jbpark0616/IDEC_Challenge/docs/figures/README.md

# 보고서 그림

| 폴더 | 내용 |
|---|---|
| [graphs](graphs/) | 실험 그래프 |
| [architecture](architecture/) | 아키텍처·회로·알고리즘 설명 그림 |
| [tables](tables/) | 보고서 표 |
| [sources](sources/) | PowerPoint 편집 원본과 생성 스크립트 |

지정주제·자유주제 그림을 함께 모았다. `winograd_`는 주로 단일 코어, `vgg_`는 주로 16코어 확장 설계를 나타낸다.
그래프 수치와 측정 조건은 [실험결과](../experiment_results/)에서 확인한다.
