jbpark0616/IDEC_Challenge/docs/figures/sources/IDEC_Challenge_figure.pptx

Weight / parameter interface (external)

Winograd CNN Accelerator

Layer FSM /

controller

control / ready–valid

Operation-fused Winograd Core

Input transform

add / sub butterfly

read (Conv2)

U / FC weight · INT4

bias / requant param

Sliding-window generator

pixel

UINT8

line buffer ×3

4×4 window

16-lane MAC / reduction array

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
Conv: lane 0–15 · FC: lane 0–9 active, 10–15 gated

INT18

Output transform

add / sub butterfly

Fused postprocess

bias add

ReLU

max-pool

requant → UINT8

FC result

Tile FIFO

D=2

V-replay FIFO

D=2

M FIFO

D=1

FC mode

store

Activation scratchpad

104 × 24-bit FF register array

Pipelined Argmax

10-class

addr 0

addr 103

## Slide 2

Winograd CNN Accelerator

Model parameters

Controller

INT4

bias / scale

Winograd Core

Compute Core

Input transform

Tile Generator

16-lane MAC

Output transform

Fused Output Unit

Class ID[3:0]

UINT8

FIFO

FIFO

FIFO

Bias

ReLU

Pool

Requant

Argmax-10

Conv2

FC

FC scores

Activation scratchpad

104 × 24-bit FF

(a) Single-core Winograd CNN accelerator

## Slide 3

Conv1

to sliding-window generator (40-vector prefill)

Stored Conv1 features (104 × 24-bit)

read: addr 0 → 103

time

Conv2 features (25 × 24-bit)

overwrite: addr 0 → 24

consumed / free

Same physical 104 × 24-bit FF scratchpad

FC read: 3 channel passes

FC input (25 × 24-bit)

free

0

24

25

(b) Lifetime-aware activation storage

Conv2

FC

## Slide 4

Operand Isolation

lane_inactive

MAC / Channel Reduction

FC Bias Fusion

pipe_mode_fc ∧ pipe_last

conv_operand[i]

fc_activation

UINT8

INT11

MUX

MUX

×

PREG

CTRL / BIAS

sign extend 15→18

+

+

ACC

RESULT

mode_fc

0

isolate

weight_zero

conv_weight[i]

INT4

MUX

0

MUX

pipe_first

0

MUX

fc_weight[i]

INT4

= 0

pipe_fc_bias[i]

(a) MAC lane with FC bias fusion

transaction

n

n+1

n+2

n+3

n+4

Conv2 example

ch0 · first

ch1

PREG

PREG

ACC

ACC

ch2 · last

PREG

ACC + RESULT

next ch0 · first

output

out_valid = 1

PREG

hold if out_ready = 0

ACC

(b) Two-stage pipeline schedule

## Slide 5

Column Transform Array

Input Transform register bank

4 × 4 spatial positions · TEMP/V layers

d₀

−

t₀

d₁

+

t₁

v_tile · 16 × INT11

d₂

−

t₂

d₃

−

t₃

Register layer

TEMP · stage 1

V · stage 2

−

+

−

−

Row Transform Array

(a) Two-stage input-transform RTL

s₀

s₁

s₂

s₃

Column Transform + TEMP

Tile 0

Tile 1

Tile 2

Tile 3

Row Transform + V

(b) Two-stage transform pipeline

Tile 0

Tile 1

Tile 2

time

n

n+1

n+2

n+3

n+4

## Slide 6

Tile 0

Tile 1

Tile 2

Tile 3

Tile 0

Tile 1

Tile 2

Tile 3

n

n+1

n+2

n+3

n+4

Output Transform Register Bank

2 × 4 LEFT / 2 × 2 Y layers

m₀

Column Transform Array

+

+

l₀

m₁

m₂

Y tile

m₁

m₂

m₃

−

−

l₁

Row Transform Array

+

−

Register layer

LEFT · stage 1

+

y₀

−

y₁

Y · stage 2

(a) Two-stage output-transform RTL

AᵀM + LEFT

LEFT·A + Y

time

(b) Two-stage transform pipeline

## Slide 7

## Slide 8

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
B (held)

2 (full)

B

C

push B + pop A

push C

hold

push D + pop B

pop C

push A

FF Storage Array

entry 0

entry 1

entry DEPTH−2

entry DEPTH−1

⋮

in_data

out_valid

~empty

out_data

in_ready

in_valid

push

pop

out_ready

~full | pop

write index

read index

read pointer

write pointer

occupancy count

push +1 · pop -1

full

count = DEPTH

count = 0

empty

(a) Synchronous elastic FIFO datapath

(b) Ready-valid operation with full-rate replacement

in_valid

in_ready

out_valid

out_ready

count

out_data

## Slide 9

FIFO

Winograd Core Array

Winograd Accelerator

Global Buffer

## Slide 10

C

N

4×4×C

Winograd convolution

2×2

d₀

d₁

F(2×2, 3×3)

y₀

y₁

H

d₂

⋯

y₂

Hₒ

3×3×C filters

W

Wₒ

Input feature maps

Output feature maps

Input transform

Element-wise product

Output transform

Bᵀ =

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
16C multiplications

per 2×2 output

Aᵀ =

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
BᵀdB

V

c

Σ

AᵀMₖA

y₀₀

y₁₀

y₀₁

y₁₁

Filter transform

U = GgGᵀ

U

k,c

Mₖ

c

Yₖ

g

Notes: Upper feature-map illustration and the B^T/A^T numeric matrix groups are unchanged. The lower flow now explicitly shows the missing filter branch: a spatial 3×3 filter g passes through Filter transform U=G g G^T to produce 4×4 transformed filter coefficients U_k,c. This branch is aligned horizontally at y=680, with g and U front-plane centers on the same datum and an arrow spanning the same x=170..330 transformation interval as the input branch. The generic U=GgG^T notation matches report Eq. (2); per-filter/channel U_k,c is used at the multiplication branch per Eq. (4). For fixed inference weights, the filter transform can be precomputed, as stated in the report. The existing input branch V_c=B^T d_c B remains centered on y=588. V enters the Hadamard node from the left and U from below, with its center at (588,588). Products reduce over input channels to M_k, then Y_k=A^T M_k A restores the 2×2 output. Input and Output transform titles remain top y=448, numeric matrix groups retain center y=508, and equations share y=544. B^T=[[1,0,-1,0],[0,1,1,0],[0,-1,1,0],[0,1,0,-1]], A^T=[[1,1,1,0],[0,1,-1,-1]]. G is 4×3, so GgG^T is 4×4 for a 3×3 spatial g. The input label d moves beside the input plane to make room for the aligned filter branch; all other existing diagram geometry is retained. Notation matches docs/IDEC_중간보고서.pdf Eqs. (2)–(5), (9), (10). All elements remain native editable PowerPoint shapes/text. Source: Lavin and Gray, CVPR 2016, https://openaccess.thecvf.com/content_cvpr_2016/papers/Lavin_Fast_Algorithms_for_CVPR_2016_paper.pdf . Final spacing adjustment translates the upper illustration up by 8 px and the lower flow down by 6 px, increasing the separation by 14 px while preserving internal geometry, text, colors and matrices.
Comparison scope: the same four spatial outputs (2x2) for one output channel, reduced over C input channels. Direct uses four independent 3x3xC inner products, 4*9C=36C weight-activation multiplications. Winograd F(2x2,3x3) uses 16C element-wise weight-activation multiplications. This comparison excludes transform addition overhead and assumes the filter transform is precomputed. It does not claim an equal reduction in total operations, cycles or energy.

## Slide 11

Winograd output tiles

Fused post-processing

(a) Tile-local operation fusion

2×2 tiles

Bias

ReLU

2×2 pool

stride 2

Requant

Next-layer activations

write

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
UINT8 activations

Output transform

Intermediate memory

Activation storage

write

read

Bias, ReLU, pool, requant

Y₀

UINT8

Full INT18 feature map

(b) Intermediate feature-map storage

Notes: Tile-level operation fusion with spatial tile-to-activation correspondence. Main view (a): the stacked Winograd output grids show spatial positions of generated output tiles, NOT an allocated intermediate buffer. In a selected output channel, the blue Y0 tile covers rows 2–3, columns 2–3 of an illustrative 8×8 convolution output; the ochre Y1 covers rows 4–5, columns 2–3. Each 2×2 Winograd output tile exactly matches a 2×2, stride-2 max-pool window. Bias and ReLU act on four tile values; pooling reduces the four values to one scalar; requantization produces one UINT8 activation. Blue Y0 maps directly to blue a0 at pooled coordinate (1,1); ochre Y1 maps to a1 at (2,1). Both blue and ochre tiles are explicitly traced through the full post-processing sequence. The two colored lanes show separate conceptual tile transactions, not two physically duplicated datapaths. Shared operation headings and equal column/row spacings emphasize the same reused process. Their vertically adjacent spatial positions are preserved in the activation map. Only the final activation is written to next-layer activation storage. Tile-local processing is indicated by aligned operator labels and repeated data positions on a white canvas, inside one white functional enclosure with a thin neutral-grey outline. The enclosure identifies the fused processing boundary; it is not a memory object or a coloured background panel. Thin grey matrix grids remain because they encode the data structure; repeated coloured outlines and decorative frames are omitted. The data colours match the approved Winograd overview (blue #9AB8CD, ochre #D8B594). Data colours alone match tile and activation identities; text and arrows are neutral. Small datapath registers are omitted. The map grid dimensions are schematic and show the 2:1 spatial downsampling relation, not fixed hardware capacity. View (b) contrasts the conventional write/read of a full INT18 convolution feature map before the same post-processing; it produces the same final activations. The logical operation order is bias → ReLU → pool → requant as in the report and user request. RTL implements equivalent max4 → saturated bias add → ReLU → requant for a channel-shared bias; this schematic is not a literal register pipeline. Styling references: Nature research figure guide, https://research-figure-guide.nature.com/figures/preparing-figures-our-specifications/ (standard fonts, editable vector content, no decorative elements or coloured text); Alwani et al., Fused-Layer CNN Accelerators, MICRO 2016 Fig. 3, https://compas.cs.stonybrook.edu/~mferdman/downloads.php/MICRO16_Fused_Layer_CNN_Accelerators.pdf (functional tile-to-output correspondence). These references guide styling only; the computation remains specific to this project. Sources: docs/winograd_postprocess.md; verilog/winograd_postprocess.v lines 3–11; docs/IDEC_중간보고서.pdf section 3.4.5; existing winograd_fused_output_unit_microarchitecture.svg. Final layout polish gives the processing enclosure 18 px left/right padding to the outer data bounds and 14 px top/bottom padding to the header/variable-label bounds. Lane arrows keep 18 px clearances from adjacent data. The lower comparison is shifted down by 8 px as a single group to balance the inter-panel gap. All matrices, arrows, labels, and functional regions are native editable shapes. No unverified numeric traffic or speedup values are shown.

## Slide 12

Class scores

3×3 kernel

2×2 pool

75

0

1

2

3

Argmax

⋮

4

5

0–9

6

7

Digit

28×28×1

Input image

MNIST

26×26×3

Conv1

3×3, 1 → 3

MaxPool + ReLU

2×2, stride 2

13×13×3

11×11×3

Conv2

3×3, 3 → 3

MaxPool + ReLU

2×2, stride 2

5×5×3

Flatten

8

9

Fully connected

75 → 10

Feature extraction

Classification

Notes: Opening CNN model architecture, composed using the user-supplied CNN reference image as a structural guide: decreasing spatial feature-map stacks, local receptive-field and pooling examples, flatten vector, explicit dense neural connections and classification. Actual model sources: training/models.py, Spatial3x3/Winograd3x3/QATWinograd3x3; training/README.md section 2. Architecture is input H×W×C=28×28×1, valid stride1 Conv1 kernel3×3 1→3 giving26×26×3, MaxPool2×2 stride2 plus ReLU giving13×13×3, valid stride1 Conv2 kernel3×3 3→3 giving11×11×3, MaxPool2×2 stride2 plus ReLU giving5×5×3, Flatten75, one FC75→10 with bias, Argmax digit0..9. No extra hidden layer, softmax or fabricated probability is added. Actual model ordering applies max pooling then ReLU, reflected by the combined stage labels. Implementation-specific convolution algorithms are intentionally omitted. There are three native planes per feature map, representing actual channel count. Front-plane grid counts match spatial dimensions. Blue input window rows10..12,col18..20 produces Conv1 outputrow10,col18. Ochre Conv1 window rows16..17,col8..9 maps to Pool1row8,col4. Highlighted rectangles and connecting rays are receptive fields, not detached filter banks. The flatten vector illustrates8 features with ellipsis for75. All8 shown features connect to all10 score neurons. Network diagram is a single FC layer despite the multi-hidden-layer reference. FC connections illustrate topology; they do not encode measured weights. Input image is the first sample from data/input_1000.txt; intermediate activations and scores are schematic. 0–9 denotes possible output labels, not a predicted value for this sample. Existing figure palette and Arial/neutral thin line treatment are preserved. All elements are editable native shapes. Final spacing: aligned 30px dimension-to-operation spacing and 28px operation-to-parameter spacing. Inter-map arrows use equal10px endpoint clearances. The flatten vector is centred on the same330px flow baseline as the FC layer; its two fan-out guides attach exactly to the rear right edge of the last tensor and to the first/last vector cells.

## Slide 13

Winograd CNN Accelerator

Model parameters

Controller

Compute Core

INT4

bias / scale

Winograd Core

Shared 16-lane MAC

Tile Generator

Zero-tile bypass

Output
transform

Fused Output Unit

Class ID[3:0]

UINT8

Input
transform

M FIFO

Bias

ReLU

Pool

Requant

Argmax-10

Tile FIFO

V buffer

Conv2

FC

FC scores

Activation scratchpad

104 × 24-bit FF

(a) Single-core Winograd CNN accelerator

Notes: MAC-focused revision of the existing overall architecture. Only slide15 changes; source slide2 and all prior figures remain unchanged. All original colours, interfaces, controller, generator, scratchpad, output unit and hierarchy remain native editable shapes. The shared16-lane MAC is enlarged to326×180 logical pixels and its original16 cell symbols are retained. Input/output transforms are reduced to90×72 and86×72 support blocks with names only; butterfly internals belong in detailed figures. This is a conceptual visual hierarchy, not synthesis-area or hardware-resource proportional sizing. Clock gates, registers and ordering FIFO remain omitted at overview level. Existing model-weight, FC-input and FC-result connections are realigned to the enlarged MAC edges. Main datapath and three intermediate buffers share y340 baseline. Tile FIFO depth2, sparse V replay two groups, M FIFO depth1 are preserved. Zero-tile bypass branches from V replay completion path and rejoins before Fused Output Unit; zero jobs still undergo bias, pooling, ReLU and requantization. Sources: verilog/winograd_conv_core.v, winograd_v_replay_buffer.v, winograd_mac_array.v, winograd_cnn_accelerator.v. Full-zero ordering and ICG implementation remain in detailed circuit figures. Final overview uses only V buffer and Zero-tile bypass labels; row compression and scheduling terminology are omitted from the visible figure per user request. The actual V replay and sparse selection behaviour is unchanged in RTL and belongs in a detailed figure. All three intermediate buffer labels share the same baseline, font size and colour. The V buffer callout is shortened to two segments. All block dimensions, positions, colours and MAC-dominant proportions remain unchanged from the approved figure.

## Slide 14

(a) Input transform

Column Transform Array

Input Transform register bank

4 × 4 spatial positions · TEMP/V layers

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
Register layer

TEMP · stage 1

V / mask · stage 2

−

+

−

−

Row Transform Array

s₀

s₁

s₂

s₃

Column Transform + TEMP

Tile 0

Tile 1

Tile 2

Tile 3

Row Transform + V + mask

(b) Two-stage transform pipeline

Tile 0

Tile 1

Tile 2

time

n

n+1

n+2

n+3

n+4

4 × 10

40

EN

zero_rows[0]

zero_rows[1]

zero_rows[2]

v_tile · 16 × INT11

zero_rows[3]

Notes: Added row-wise zero detection to a native editable copy of existing slide5. RTL source: verilog/winograd_input_transform.v, especially g_horizontal lines83–91, ready logic lines40–43 and V register update lines132–136. For each row r=0..3, zero_rows[r] <= ~|temp_tile[r*4*TEMP_BITS +: 4*TEMP_BITS]. At default TEMP_BITS=10, each detector reads the concatenated40-bit TEMP row, not one last-column value and not the unsigned raw input. Every one of the four10-bit TEMP registers in each row has its own visible Q-port branch. The four thin word lines enter a thick40-bit concatenation bus through diagonal bus-entry symbols; they are slices of a bus, not four scalar nets electrically shorted together. The concatenated row bus then drives the NOR. Junction dots occur only at real register taps. Thin existing vertical array wires crossing the thick row bus without dots are separate nets. Shared width label4×10 and40 identifies the full fan-in without repeated prose. Each standard OR-shaped body followed by an inversion bubble depicts a40-bit reduction NOR. It is a logical reduction symbol, not a claim that synthesis maps to one physical40-input cell. Four reduction NOR gates and four1-bit mask DFFs operate in parallel. B is invertible, so a whole TEMP row is zero iff the corresponding transformed V row is zero for the default exact8/10/11-bit arithmetic, including cancellation between nonzero input rows. zero_rows uses root clk and asynchronous active-low rst_n; it is not driven by the gated v_clk. The DFFs update only when output_stage_ready && temp_valid, are reset to0, and otherwise hold. Long prose, repeated TEMP-row labels and repeated internal register names are removed from the visible diagram; the shared40-bit bus width and output signal names remain. EN remains the existing update condition, documented here rather than written as a long equation in the figure. Dashed EN branches indicate this common update condition; clock triangles and active-low reset bubbles identify the register pins. Clock and reset stubs indicate common named signals, not tied-together data outputs. Detection occurs in parallel with the existing row transform, adding no pipeline stage: zero mask and V become valid together. Re-labelled pipeline row2 as Row Transform + V + mask. Existing TEMP/V register-bank, arithmetic symbols, black data lines, grey control lines, colours and timing composition are preserved. Existing slide5 and other slides are unchanged. Original V payload port is routed below the detector lanes to avoid confusing it with the40-bit TEMP rows. Four zero_rows outputs are shown individually and together form zero_rows[3:0]. Final spacing uses common51.4286px row pitch,42.8571px word pitch, equal8px Q stubs and equal8px diagonal bus entries. All NOR and mask-DFF centres share their TEMP row baseline and27px gate-bubble-to-DFF clearances. No output bypass or row scheduler is placed here; those use this metadata in a later block.

## Slide 15

V buffer

z

0

c₀

Row selection

Zero flags + unread state

T₀ · 16 active

16-lane MAC

T₀ · 4 active, 12 held

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
r₀: c₀

r₁: c₁

r₂: c₁

r₀: c₂

r₁

r₂

hold

hold

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
r₃: c₀

r₃

hold

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
Cycle n

Cycle n + 1

Time

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
V buffer

r₃

1

(a) Row compaction

0

0

0

0

Row selection

All z = 1 → bypass

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
T₀ · bypass

r₀

T₁ · 16 active

r₀: c₀

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
r₁: c₀

r₂: c₀

r₃: c₀

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
16-lane MAC

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
Cycle n

Cycle n + 1

Time

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
z = 1: zero row (skip)

r₃

1

(b) Zero-tile bypass

0

0

0

0

Notes: Sources: verilog/winograd_v_replay_buffer.v, winograd_conv_core.v and winograd_mac_array.v. The user clarified the bypass example: one all-zero tile job bypasses on cycle n, and the next tile executes normally on cycle n+1. The two panels deliberately use exactly the same source tile coordinates, three-channel vertical arrangement, zero-bit columns, MAC lane-bank coordinates, captions, time axis below states and MAC label below the banks. Panel(b) no longer introduces a different horizontal channel arrangement, output-transform block or postprocessing chain. Panel(a) T0 is the established realizable partial-zero pattern c0 nonzero rows0,3,c1 rows1,2,c2 row0. n selects[c0,c1,c1,c0],16enabled lanes; n+1 selects[c2,disabled,disabled,disabled],4enabled lanes and12hold. The five source arrows preserve row positions. Hue now identifies the row, consistently across channels: blue r0,ochre r1,sage r2,mauve r3. Each cell has a distinct deterministic shade; these are data-identity cues, not calibrated magnitudes. Source and selected destination cell shades match exactly. Channel identity is explicit in c0,c1,c2 labels. Panel(b) source tiles and all12zero flags belong to T0, an entirely zero spatial group. At n this zero job is accepted as a metadata descriptor, not a MAC input: no MAC issue occurs. The empty grey bank indicates not issued, not a claim that no unrelated pipeline work exists. The descriptor joins Y=0 before fused postprocessing; output transform is bypassed, bias and nonlinear postprocessing still operate. At n+1 the next spatial tile T1 is accepted for normal MAC issue, all16lanes enabled, using c0 for every row in the first channel-reduction beat. T1 input payload is not redrawn on the left, to keep both panel layouts identical: the T1 label explicitly identifies that the state on n+1 is for a different tile. T1 may need additional channel-reduction beats after the illustrated interval. For this immediately adjacent zero-to-next-tile trace in the fixed K=3 model, T0 is shown on its final output-channel job (k=K-1) so the group retires at n and T1 k0 can be issued at n+1, assuming already loaded and ready=1. Earlier zero descriptors for T0 outputchannels are outside the shown interval. Thus only one bypass acceptance cycle is illustrated, not a false claim that an all-zero C3 group skips just one of its nonzero-channel contributions. Wholezero metadata transfers are not arithmetic beats. Common ordering preserves work. Array snapshots refer to the same physical16-laneMAC at successive times. All elements native editable. Spacing-only follow-up: the first state moves55pixels left and the second90pixels left, so the blank interval shrinks by35pixels; source inputs, data shades, row colours and all state semantics remain unchanged. Both panels use identical modified coordinates. Prose sentences below both time axes are removed; cycle ticks, short panel identifiers and zero-bit legend remain. Only slide17 changes.

## Slide 16

PREG

MAC register banks

ACC

RESULT

product

Input accepted

Control / valid

E

ICG

Commit allowed

E

ICG

Final commit

E

ICG

clk

(a) MAC register clock gating

Idle

Final commit blocked

Idle

PREG clock

clk

ACC clock

RESULT clock

n

n + 1

n + 2

n + 3

n + 4

n + 5

n + 6

n + 7

n + 8

n + 9

n + 10

Cycle

(b) MAC clock activity

Notes: Sources: verilog/winograd_clock_gate.v; verilog/winograd_mac_array.v lines93-96,178-237; verification/asap7_final_extra_cells.v ICGx1_ASAP7_75t_R and OpenRoad project/std_cell/asap7sc7p5t_SEQ_RVT_TT_220101.v ICG definitions. The wrapper instantiates OPENROAD_CLKGATE in SYNTHESIS. Its functional model latches enable while clk is low, then ANDs latched enable with clk. ASAP7 ICG equivalent uses ENA|SE into a transparent-low latch, then AND with CLK; scan/test path is omitted in this functional illustration. CLOCK_GATING_BYPASS is assumed undefined. Panel(a) uses the MAC as the representative actual application, not a claim that every gated block uses the same enable. PREG enable is in_ready&&in_valid (input accepted). ACC enable is pipe_can_commit: pipe_valid&&(!pipe_last||!out_valid||out_ready), summarized as commit allowed. RESULT enable is pipe_can_commit&&pipe_last (final commit). The PREG label refers to the product bank, including its lane activity metadata; its control valid/first/last and bias controls remain root-clocked. ACC and RESULT are data banks. The root-clocked Control/valid block shows that valid and handshake state are not stopped and can wake the pipeline. The data arrows abstract multiplier/accumulator combinational arithmetic; no new datapath is implied. The three ICG cells have separate event-enable E and clock inputs; an ordinary clock distribution tree carries root clk to each gate. The integrated gating cell symbol abstracts its latch/AND internal circuit, which is implemented as the glitch-free latch-based model above. Panel(b) is an illustrative RTL-consistent input-ready/commit trace of11issue cycles, not measured power or a claim about end-to-end latency. Cycles1-3accept a three-beat jobA; cycle4accepts firstB while committing finalA; cycle5accepts lastB while committing nonfinalB even though resultA is held. out_ready stays0 fromcycle4through7. At6and7 the lastB product cannot commit because resultA occupies the output slot, so input_ready is0 and all3data-bank clocks are suppressed. At8 output_ready returns1, lastB commits and firstC is accepted; at9 C first is accumulated with no new input; at10 pipeline is idle. Root clk keeps pulsing in idle and blocked intervals. Product enables01111100100; ACC00111100110; result00001000100. Timing assumes each E satisfies the actual latch/gating timing and is stable in its low sampling phase, so full pulses pass or are completely suppressed; no runt pulse is implied. Partial-zero rows and zero weights use operand isolation/accumulator holding, not individual lane ICGs. Other gated banks (input/output transform, V-buffer payload, postprocess, windows, scratchpad) are outside this representative view. This follow-up changes only styling and spacing: monochrome circuit and traces, neutral grey banks and inactive windows,270pixel bank pitch, compact vertical clock branches and41pixel waveform row pitch. The enable conditions and eleven-cycle trace remain unchanged. All elements native editable; only slide18 is replaced.

## Slide 17

ICGx1_ASAP7_75t_R

ENA

Latch

IQ

SE

D

G

Q

GCLK

CLK

(a) Standard-cell functional circuit

Hold

Hold

Track

CLK

ENA

IQ

GCLK

Cycle

n

n + 1

n + 2

n + 3

n + 4

n + 5

n + 6

n + 7

n + 8

(b) Latch and clock operation (SE = 0)

Notes: Primary sources supplied in the workspace: OpenRoad project/std_cell/asap7sc7p5t_SEQ_RVT_TT_220101.v, module ICGx1_ASAP7_75t_R nearline932 and primitive altos_latch nearline139; verification/asap7_final_extra_cells.v nearline14; verilog/winograd_clock_gate.v. The actual library functional model computes invertedCLK, OR(ENA,SE), a latch enabled by invertedCLK, then GCLK=CLK&IQ. The low-active bubble at latch gate G is logically equivalent to the explicit inversion in the library. No clock-edge triangle is drawn on the latch because it is level-sensitive, not a flip-flop. ENA enables functional clock passing; SE is the library scan/test enable. Generic SE input is shown without inventing a tie-off from the missing mapped netlist. Functional timing below deliberately fixes SE=0. Internal delayed_ signals, timing notifiers and specify checks are omitted; this is a logical functional schematic of the stdcell, not a transistor schematic or physical layout. No local SPICE/CDL/GDS source was available for a transistor layout reconstruction. In the trace CLK is0for the firsthalf and1for the secondhalf of everycycle. ENA changes at1.7,4.7,6.2,7.7cycles. At1.7during CLK high the latch holdsIQ=0 until CLK falls at2, so no truncated pulse appears. ENA falls at4.7during high; IQ remains1until5 and the4.5..5 pulse completes. At6.2during low the latch transparently tracks ENA before the next risingedge6.5. At7.7ENA falls during high and the7.5..8pulse completes. IQ transitions[2:1,5:0,6.2:1,8:0]. GCLK high intervals2.5..3,3.5..4,4.5..5,6.5..7,7.5..8 all have full half-cycle width. Selected grey Hold and Track bands demonstrate high-level storage and low-level transparency; all other highphases also hold even if unshaded. This is illustrative functional timing, not measured gate delay or a simulation of setup/hold violations. Black/grey native editable shapes match the preceding clock-distribution figure. Horizontal spacing follow-up only: the cell boundary narrows from760to600pixels, wires between OR/latch/AND shorten, and timing pitch narrows100to82pixels percycle without resizing symbols or fonts. All logic, timing transitions and gate pulse widths remain unchanged in cycle units. Only slide19 is replaced; previous18slides preserved.

## Slide 18

3×3 Conv → BN → ReLU

2×2 MaxPool, stride 2

3×3 kernel

2×2 pool

Conv × 2

512

512

512

Class scores

0

Conv × 2

Conv × 3

Conv × 3

Conv × 3

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
32×32×3

CIFAR-10

16×16×64

Pool 1

8×8×128

Pool 2

4×4×256

Pool 3

2×2×512

Pool 4

1×1×512

Pool 5

Flatten

FC 1

FC 2

FC 3

7

8

9

RGB input

ReLU

ReLU

10 classes

Feature extraction

Classification

Notes: Free-topic CIFAR10 VGG16BN architecture. Primary local sources: free_topic_vgg/model.py CifarVGG16BN and BLOCKS; free_topic_vgg/config.json; pinned upstream free_topic_vgg/reference/upstream/vgg.py.txt. The frozen hardware design is not edited. A19slide source deck is extended with this general model figure at slide20, following the approved earlier designated-topic CNN architecture style, not the monochrome circuit figures. Model uses3x32x32RGB input,13Conv3x3stride1padding1layers, each followed by BatchNorm and ReLU, grouped2,2,3,3,3 with64,128,256,512,512output channels. Each block then applies MaxPool2x2stride2, giving16x16x64,8x8x128,4x4x256,2x2x512,1x1x512. Blue stacks are prepool outputs with32,16,8,4,2spatial sizes. Ochre stacks are postpool outputs labelled with their exact HxWxC dimensions. The repeated-unit counts apply to Conv-BN-ReLU, not a BN applied once per block. The13conv+3FCweight layers giveVGG16. Final1x1x512features flatten to512; three FC layers512to512,512to512,and512to10. ReLU follows the firsttwo FC layers. Dropout modules exist after those ReLUs in the source architecture but are inactive in model.eval inference, so not shown. No ImageNet-style4096classifiers or adaptive7x7pool are introduced; no softmax or probability values are invented. The graph ends at raw10class scores and illustrative IDs0..9, not an assumed prediction. Actual input is official CIFAR10test index13, groundtruthhorse(class7), read from local test_batch and rendered pixel-for-pixel as native RGB cells. Intermediate featuremaps and score values are schematic; tensor labels are authoritative. Several channel planes are drawn per tensor as a schematic of64to512channels, not the actual channel count or a physical area scale. Spatial grid counts match the corresponding tensor width. Tensor sizes are illustrative decreasing visual scales, not common geometric units. The selected3x3input patch demonstrates a primitive firstConv kernel; no false3x3receptive-field ray to the output of the entiretwo-convblock is drawn. The pooling example correctly maps the2x2window at convBlock1rows16..17,cols8..9 to Pool1row8,col4. Feature vector and hidden512layers use ellipses; dense edges indicate the fully connected topology, not numerical weights. Palette, thin neutral grids, Arial, receptive-field example and feature-extraction/classification baselines follow slide14 and its approved source .figure_review/cnn_model_final. Final refinement keeps all architecture and colours unchanged. Conv-unit captions have a uniform9pixel gap above the rear feature plane. Dimension/operation baselines move10pixels closer. The flatten vector and both hidden/output neuron sets are centred on the same315pixel data baseline; its guide endpoints attach exactly to the first/last vector cells. All inter-map arrows use4pixel endpoint clearance. FC, flatten and pooling operation captions share a baseline. All objects native editable; only slide20 is replaced and previous19slides preserved.

## Slide 19

VGG accelerator

Logical multicast interconnect

Winograd core 0

Winograd core 1

Winograd core 2

Winograd core 3

IT

16-lane MAC

OT
Fused

IT

16-lane MAC

OT
Fused

IT

16-lane MAC

OT
Fused

IT

16-lane MAC

OT
Fused

U SRAM

V SRAM

A/B SRAM

U SRAM

V SRAM

A/B SRAM

U SRAM

V SRAM

A/B SRAM

U SRAM

V SRAM

A/B SRAM

Weights / activations
64-bit

Control & I/O

64-bit SRAM I/F

Winograd core 4

IT

16-lane MAC

OT
Fused

Winograd core 5

IT

16-lane MAC

OT
Fused

Winograd core 6

IT

16-lane MAC

OT
Fused

Winograd core 7

IT

16-lane MAC

OT
Fused

Command

Status

Command / status

U SRAM

V SRAM

A/B SRAM

U SRAM

V SRAM

A/B SRAM

U SRAM

V SRAM

A/B SRAM

U SRAM

V SRAM

A/B SRAM

Class ID[3:0]

Class valid / ID

Winograd core 8

Winograd core 9

Winograd core 10

Winograd core 11

IT

16-lane MAC

OT
Fused

IT

16-lane MAC

OT
Fused

IT

16-lane MAC

OT
Fused

IT

16-lane MAC

OT
Fused

Multicast unit

U SRAM

V SRAM

A/B SRAM

U SRAM

V SRAM

A/B SRAM

U SRAM

V SRAM

A/B SRAM

U SRAM

V SRAM

A/B SRAM

Winograd core 12

IT

16-lane MAC

OT
Fused

Winograd core 13

IT

16-lane MAC

OT
Fused

Winograd core 14

IT

16-lane MAC

OT
Fused

Winograd core 15

IT

16-lane MAC

OT
Fused

clk / rst_n

U SRAM

V SRAM

A/B SRAM

U SRAM

V SRAM

A/B SRAM

U SRAM

V SRAM

A/B SRAM

U SRAM

V SRAM

A/B SRAM

Notes: Approved core layout retained with larger banked SRAM and MAC/SRAM gap. User requested the original short diagonal-to-node visual vocabulary, attached to SRAM instead of the core corner. Each of the sixteen A/B SRAM groups now has exactly one short lower-right diagonal from normalized(136,105), a port on the bottom of the rightmost A/B SRAM macro, to one dark endpoint at the core lower right. The endpoints form one4x4 lattice. Final spacing polish puts each endpoint193px right of the core origin and9px below the core bottom, making all16 diagonal lengths and slopes identical. Port-dot diameter is reduced to2.4px, diagonals0.8px line weight. Compute/SRAM blocks and external interfaces stay in place. The complete figure is centered on the slide before export. All generic core-corner diagonals, the duplicate left-side source/receive branches, extra perimeter wires, and additional corner nodes are removed. Compute glyphs and memory capacity are unchanged. The lattice is explicitly a logical multicast interconnect, not a claim of16 newly implemented physical mesh routers. The diagonal is a bundled core-memory communication interface: the shared activation feed selects/reads A/B SRAM, and multicast reception via per-core RX/IT is abstracted at this overall level. It must not be read as an RTL modification that stores multicast inputs directly in A/B SRAM. Baseline remains one owner-select/shared activation feed and one depth4 FIFO/destination-delivered-mask fanout. Each core contains16 MAC lanes and96KiB SRAM: four8KiB U, four8KiB V, four8KiB activation A/B macros. Bank array/decoder/periphery glyphs are illustrative, not a foundry macro floorplan. External64-bit SRAM access, command/status, class-valid/ID and clk/rst_n are retained, grouped Control and I/O. Core0 gives the final class. RTL sources: free_topic_vgg/rtl/vgg_sixteen_core_cluster.v, vgg_ab_layer_cluster.v, interconnect/vgg_activation_feed.v, interconnect/vgg_mcast_fanout.v. Source architecture visual references: approved designated-topic slide15, user AMD/example diagonal endpoint image, Eyerissv2 https://eems.mit.edu/wp-content/uploads/2019/04/2019_jetcas_eyerissv2.pdf, NVDLA https://nvdla.org/hw/v1/hwarch.html. No RTL changes. Only slide21 is updated; slide22 multicast detail and all earlier slides remain unchanged.

## Slide 20

Multicast delivery

w₀ reception · Cycle n

Multicast unit

w₀

w₁

w₂

w₃

FIFO (4)

Delivered mask

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
no w₀

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
Core 5

A/B SRAM

Head

Pop

64-bit

64-bit payload

accepted = valid & ready

C9: ready = 0

Time

Cycle n

15 received · C9 waiting

Cycle n + 1

Only C9 receives

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
no w₀

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
Receive now

No new write

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
FIFO head

Waiting for C9

w₀

w₁

w₁

w₂

All received

Hold w₀

Advance to w₁

Notes: RTL sources: free_topic_vgg/rtl/interconnect/vgg_mcast_fanout.v; rtl/interconnect/vgg_activation_feed.v; rtl/vgg_ab_layer_cluster.v. All per-core special orange borders remain removed. Palette updated consistently: muted warm ochre marks the current payload and newly accepting receivers; neutral light gray marks retained words with no new write; white marks the absent current word. Data arrows use warm brown. This color is a transaction state, not a special core identity. Core geometry and timing unchanged. Final polish aligns legend labels to the left, regularizes gaps below cycle subtitles and above the head transitions, and centers the complete figure. Final palette: newly received D8B594, retained E3E6E8, absent word white; retained word text remains dark. The Core9 word slot is explicitly labelled no w0 in the upper and lower views; this denotes absence of the current word w0, not an empty physical elastic FIFO. A stalled RX may contain older words, hence ready=0 is compatible with no w0 received. The reception header explicitly scopes the image to w0 delivery; all endpoint borders use the same neutral stroke. The lower n+1 arrival arrow is present only at Core9, while previously accepted words are retained as one gray word per RX with no new-write arrow. The first state waits for Core9; the completed n+1 receiver group is bracketed to the next FIFO head, explicitly showing all-received before advance. Core9 is an illustrative stalled receiver, not a distinct hardware type. Upper SRAM/FIFO/fanout/delivered-mask topology otherwise unchanged. Lower bitmaps are replaced with two side-by-side snapshots of the SAME sixteen RX endpoints at successive cycles. Each lower core rectangle shows one received word slot, not a tensor, MAC state, new SRAM bank or second physical RX array. Cycle n: fifteen endpoints accept w0, shown in warm ochre with a small incoming arrow; Core9 stalls and its slot stays empty. Cycle n+1: the same fifteen endpoints retain their single w0 in gray with no incoming arrow, so they do not receive a duplicate; only Core9 newly accepts w0 in warm ochre. For clarity the example assumes the previously accepted w0 stays in RX during the two illustrated cycles; MAC consumption is not tracked here. Head-state sketches are post-edge: w0 remains the FIFO head after n, then w1 becomes the head after n+1. The delivered register accumulates acceptance for the current head and clears on head_ready; it does not need to sit at an all-one registered state. pending=destinations & ~delivered; accepted=out_valid & out_ready; head_ready=head_valid && !(|(pending & ~out_ready)). Normal destinations include all16 active cores, including sourceCore5. Completion means RX endpoint acceptance, not MAC completion or source lifetime release. One shared64-bit payload FIFO depth4 stores words and destination masks, with delivered tracking for only the current head. The activation feed may cache/reorder/pad SRAM reads to form the tiled stream; source-to-FIFO connection abstracts this. No new RTL behavior or physical circuits. Prior21 slides unchanged.

## Slide 21

Core SRAM architecture

Host load / MAC read

Transform write / MAC read

96 KiB / core · 12 × 8 KiB · 1RW

Host R/W / Mcast read / Result write

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
U operand SRAM

8 KiB

8 KiB

8 KiB

8 KiB

V tile SRAM

8 KiB

8 KiB

8 KiB

8 KiB

A/B activation SRAM

8 KiB

8 KiB

8 KiB

8 KiB

4 banks · 32 KiB

4 banks · 32 KiB

A: B8–B9 / B: B10–B11

Bank access

(a) Per-core bank allocation

1024 × 64 · 1RW

Read response

Host R/W

Bank arbitration

H.addr

TX.addr

3:1

10

Bank 8

Q₈

Q9

4:1

bank

D

H.tag

Q

Mcast read

Round-robin

grant

W.addr

grant

en · rd · wr

Q10

Q11

bank

Host

D

TX.tag

Q

Result FIFO

Read hold

H.data

W.data

2:1

64

8 KiB

4:1

Mcast

grant

(b) A/B bank interface

Notes: Activation sparsity intuition from actual MNIST input, image0 of data/input_1000.txt. Source input SHA256=cccf35e29a63989cd74b7c949a15bf87457700f82178e2afcc233495ef499cca. Examples are exact4x4 spatial patches with zero-based top-left coordinates A=(4,16), B=(10,18), C=(20,22). Every input patch was verified as an accepted Conv1 activation tile in docs/report_data/designated_sparsity/simulation.log. Exact unsigned8-bit transform: T=B^T d, V=T B, rows T0=d0-d2; T1=d1+d2; T2=d2-d1; T3=d1-d3. Numerical d/V data stored in private examples.json. B has zero transformed rows2 and3; A has none; C is entirely zero. Figures show nonzero data by fill and zero entries by literal0. Product work is a4x4 coordinate grid for one input channel and one output channel. Dense baseline computes16 products. RTL skips whole zero rows, not individual zero elements in a live row, so work remains16/8/0 products respectively. These are illustrative exact product counts, not measured total-cycle or latency reductions. Since MNIST Conv1 has one input channel, C is also an entirely zero channel group and bypasses MAC and output transform; downstream ordering/bias/postprocessing still occurs, and zero final output is not asserted. Partial zero rows disable lane work but with C=1 do not by themselves imply a shorter MAC issue count. Row compaction across multiple channels is detailed in the existing separate figure. Sources: verilog/winograd_input_transform.v, verilog/winograd_v_replay_buffer.v, docs/report_data/designated_sparsity/README_KO.txt. No claim that Winograd increases overall sparsity. Muted colors identify three patches consistently across input, transformed tile and issued work. Native editable PowerPoint shapes. No circuit control signals shown.

## Slide 22

Spatial activation

Input tile d

4 × 4

Input transform

Transformed tile V

4 × 4

Per output channel

MAC products

A

B

A · Nonzero tile

No zero row

16 → 16 products

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
MNIST · 28 × 28 × 1

B · Partial tile

0

0

0

0

2 zero rows

0

0

0

0

16 → 8 products

Issued product

Skipped product

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
C · Zero tile

0

0

0

0

All-zero tile

0

0

0

0

16 → 0 products

Tile bypass

Notes: Activation sparsity intuition from actual MNIST input, image0 of data/input_1000.txt. Source input SHA256=cccf35e29a63989cd74b7c949a15bf87457700f82178e2afcc233495ef499cca. Examples are exact4x4 spatial patches with zero-based top-left coordinates A=(4,16), B=(10,18), C=(20,22). Every input patch was verified as an accepted Conv1 activation tile in docs/report_data/designated_sparsity/simulation.log. Exact unsigned8-bit transform: T=B^T d, V=T B, rows T0=d0-d2; T1=d1+d2; T2=d2-d1; T3=d1-d3. Numerical d/V data stored in private examples.json. B has zero transformed rows2 and3; A has none; C is entirely zero. Figures show nonzero data by fill and zero entries by literal0. Product work is a4x4 coordinate grid for one input channel and one output channel. Dense baseline computes16 products. RTL skips whole zero rows, not individual zero elements in a live row, so work remains16/8/0 products respectively. These are illustrative exact product counts, not measured total-cycle or latency reductions. Since MNIST Conv1 has one input channel, C is also an entirely zero channel group and bypasses MAC and output transform; downstream ordering/bias/postprocessing still occurs, and zero final output is not asserted. Partial zero rows disable lane work but with C=1 do not by themselves imply a shorter MAC issue count. Row compaction across multiple channels is detailed in the existing separate figure. Sources: verilog/winograd_input_transform.v, verilog/winograd_v_replay_buffer.v, docs/report_data/designated_sparsity/README_KO.txt. No claim that Winograd increases overall sparsity. Muted colors identify three patches consistently across input, transformed tile and issued work. Native editable PowerPoint shapes. No circuit control signals shown.

## Slide 23

Layer ℓ

16 cores

Output shards

A/B SRAM

64 input channels / core

Layer ℓ + 1

Core 0

W₀

Core 0

W′₀

Conv

k = 0–3

Shared input

W₁

k = 0–3

W′₁

Core 1

Multicast

0–3

4–7

⋯

60–63

Core 1

Conv

⋮

k = 4–7

Input channel c

k = 4–7

⋮

32 × 32 × 3

W₁₅

⋮

W′₁₅

Core 15

Conv

Core 15

k = 60–63

k = 60–63

(a) Output-channel sharding

(b) Cross-layer multicast

Notes: Conceptual output-channel sharding and cross-layer multicast, grounded in the frozen16-core RTL. Example: first two64-output-channel VGG convolutions with CIFAR-10 input. First layer input32x32x3; output32x32x64, equal4-channel output shards per core. Core0 owns0–3, core1 owns4–7, core15 owns60–63; cores2–14 are omitted using ellipses. First-layer convolution is shown without pooling, so all shards retain the same spatial extent. Per-core kernel banks W_i operate on the same complete activation input. Output maps are stored in the owning core activation A/B SRAM, not gathered into a centralized feature-map buffer. A logical source-read bus, channel-ordered stream and multicast fanout connect each source SRAM to every active core. At the next layer all64 prior output channels are input channels needed by each output-channel owner. The stream strip illustrates channel order at one spatial position; the RTL actually emits padded4x4 input tiles in spatial-tile/input-channel/pixel order, with64-bit packed words. It is not a physical12-byte packet specification and does not imply each full feature map is permanently replicated in all cores. The same16 physical cores are reused across the two sequential layers; the two core columns are layer views, not32 physical cores. Next-layer kernel groups Wprime_i differ by output-channel partition. Multicast avoids issuing one separate payload copy for every receiver: one queued word is shared and delivered once to each configured endpoint, with completion managed in vgg_mcast_fanout. Initial shared-input distribution is abstracted as a bus; detailed SRAM controls, packet handshakes, masks and clocks are deliberately omitted. The local source channel ranges remain distributed; aggregate channel concatenation is logical and serialized. Tensor plane counts and small spatial grids are schematic; color families identify ownership, and shade variations distinguish representative data with no measured-value claim. Source references: free_topic_vgg/rtl/vgg_sixteen_core_cluster.v; free_topic_vgg/rtl/vgg_ab_layer_cluster.v (equal K shards and multicast active_cores); free_topic_vgg/rtl/interconnect/vgg_activation_feed.v (source owner, local channel and SRAM reads); free_topic_vgg/rtl/interconnect/vgg_mcast_fanout.v (one payload with per-receiver acceptance). No RTL changes.

## Slide 24

C

36C multiplications

Direct convolution

N

6

3×3×C

stride 1

4 × 9C per 2×2 output

1×1

y₀₀

y₁₀

y₀₁

y₁₁

4

Input feature maps

6

⋯

4

3×3×C filters

Output feature maps

Notes: Direct 3x3 convolution, stride one, no padding. A complete 6x6xC input produces a complete 4x4xN output map. The four colored overlapping 3x3xC receptive fields start at input coordinates (1,1), (1,2), (2,1), (2,2) and map separately to the four colored scalar output positions (1,1), (1,2), (2,1), (2,2). One selected receptive field is enlarged, and its one scalar result is connected to the corresponding cell in the full output map. Each output uses 9C multiplications; the four highlighted outputs use 36C. Computing the full 4x4 map would require 144C multiplications per output channel. The four highlighted scalar outputs are the common comparison workload with Winograd F(2x2,3x3).
Comparison scope: the same four spatial outputs (2x2) for one output channel, reduced over C input channels. Direct uses four independent 3x3xC inner products, 4*9C=36C weight-activation multiplications. Winograd F(2x2,3x3) uses 16C element-wise weight-activation multiplications. This comparison excludes transform addition overhead and assumes the filter transform is precomputed. It does not claim an equal reduction in total operations, cycles or energy.
