jbpark0616/IDEC_Challenge/docs/figures/winograd_w4_compute_width_sweep.pdf

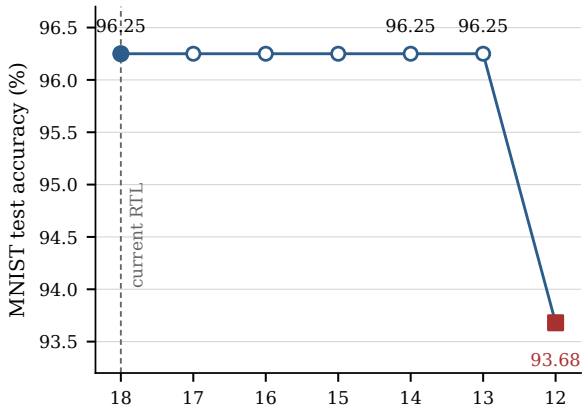
[picture p47: figure]
MNIST test accuracy (%); current RTL

### Compute width (bit)

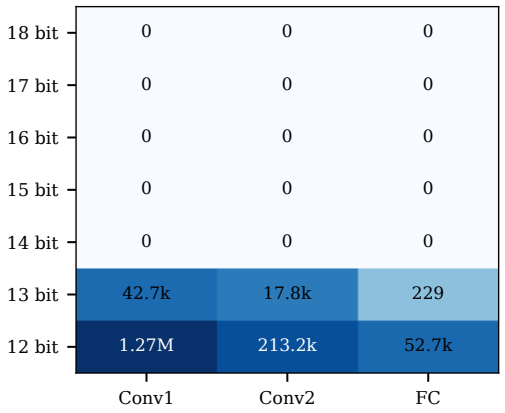
[picture p48: figure]
Conv1; Conv2; 18 bit; 17 bit; 16 bit; 15 bit; 14 bit; 13 bit; 12 bit

### Compute block

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
Saturation events

(a) Accuracy | (b) Saturation events
