jbpark0616/IDEC_Challenge/docs/figures/free_topic/fig06_mac_activity/figure.pdf

Conv1 | Conv2 | Conv3 | Conv4 | Conv5 | Conv6 | Conv7 | Conv8 | Conv9 | Conv10 | Conv11 | Conv12 | Conv13

Convolution layer

0

4

8

12

16

MAC lane operations (million)

29.2%

| 4.9% | 9.7%
| | | 15.0% 17.9% 13.8%

0.2%

17.5%

33.1% 43.6%

22.3%

49.9% 51.8%

Annotations: reduction per layer | Total Conv reduction: 30.76%
Zero-skipping disabled | Sparsity-aware execution
