jbpark0616/IDEC_Challenge/docs/experiment_results/free_topic/report700/core_actual/effects.csv

mode | case | input | local_K | data_kind | capacity_fits | resident | u_bytes | cycles_off | cycles_on | cycle_reduction_percent | inclusive_off | inclusive_on | inclusive_reduction_percent | lane_reduction_percent | weight_wait_off | weight_wait_on | v_read_blocked_off | v_read_blocked_on | no_ready_channel_off | no_ready_channel_on
capacity_policy | 0 | 1,4,4,3 | 6 | synthetic | 1 | 1 | 288 | 573 | 529 | 7.6788830715532335 | 671 | 627 | 6.5573770491803245 | 33.333333333333336 | 284 | 265 | 0 | 0 | 8 | 9
capacity_policy | 1 | 1,4,4,128 | 6 | synthetic | 1 | 1 | 12288 | 3973 | 3229 | 18.72640322174679 | 7047 | 6303 | 10.557684120902511 | 25.09765625 | 272 | 272 | 163 | 155 | 259 | 291
capacity_policy | 2 | 1,4,4,512 | 4 | synthetic | 1 | 1 | 32768 | 12520 | 10981 | 12.29233226837061 | 20715 | 19175 | 7.434226405985999 | 25.59814453125 | 174 | 175 | 6 | 4 | 4006 | 4519
capacity_policy | 3 | 1,2,2,512 | 4 | synthetic | 1 | 1 | 32768 | 3134 | 2746 | 12.380344607530313 | 11329 | 10941 | 3.4248389089946207 | 30.46875 | 26 | 27 | 0 | 0 | 1027 | 1156
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
