jbpark0616/IDEC_Challenge/docs/IDEC_Poster_발표대본.txt

Sparsity-Aware Winograd Accelerator
포스터 발표 통합 대본

※ 대괄호는 그림을 짚는 위치이며, 읽지 않습니다.
※ 10분을 목표로 구성한 초안입니다. 실제 소요 시간은 그림을 짚는 시간까지 포함해 리허설로 확인합니다.

도입

안녕하십니까. 성균관대학교 SKKAF팀 박준범입니다.
이번 설계에서는 Winograd와 activation sparsity를 활용해 CNN 추론의 연산량과 에너지 소모를 줄였습니다.

Winograd는 이웃한 출력을 묶어 계산해 필요한 곱셈 수를 줄이는 알고리즘입니다. Activation sparsity는 CNN의 입력과 중간 특징값에 0이 포함되는 특성으로, 이 값에 대한 불필요한 연산을 생략하는 데 활용할 수 있습니다.

저는 두 기법을 적용한 연산 코어를 구현하고, 줄어든 연산량이 실제 사이클과 에너지 감소로 이어지는지 검증했습니다. 이후 같은 코어를 SRAM과 통신망을 갖춘 16코어 구조로 확장했습니다.

1번. MNIST Evaluation

[왼쪽 모델 그림을 입력부터 완전연결층까지 짚는다.]

대회 지정주제는 제공된 MNIST 분류 CNN의 정확도를 유지하면서 PPA를 개선하는 과제입니다. 28×28 흑백 이미지를 받아 합성곱과 풀링을 두 차례 수행하고, 완전연결층에서 숫자를 분류합니다.

계층 구성은 유지하면서 커널은 3×3으로 변경했습니다. Winograd는 다른 커널 크기에도 적용할 수 있지만, 널리 연구되어 있고 변환 회로의 부담이 작은 구성을 선택했습니다.

가중치는 signed 4비트, 저장 activation은 unsigned 8비트로 양자화했습니다. 대회 검증 입력에 대한 분류 정확도는 97%를 유지했습니다.

2번. Direct vs. Winograd

[Direct 그림의 3×3 필터와 네 출력을 짚는다.]

Direct convolution에서는 출력 하나에 곱셈이 아홉 번 필요합니다. 출력 네 개를 각각 계산하면, 입력·출력 채널 한 쌍을 기준으로 총 서른여섯 번의 곱셈을 수행합니다.

[Winograd 그림의 4×4 입력 타일과 2×2 출력을 짚는다.]

Winograd는 같은 4×4 입력을 한 타일로 받아 출력 네 개를 함께 계산합니다. 입력과 필터를 변환하고 열여섯 번의 원소별 곱셈을 수행한 뒤, 출력 변환으로 2×2 결과를 얻습니다.

같은 네 출력을 계산하는 곱셈이 36회에서 16회로, 약 55.6% 줄어듭니다.

추가되는 입력·출력 변환은 덧셈과 뺄셈으로 구현했고, 가중치는 미리 변환한 값을 공급합니다. 이를 처리하는 회로를 설명드리겠습니다.

3번. Sparsity-Aware Core Architecture

[왼쪽 위 전체 아키텍처를 짚는다.]

한 사이클에 한 픽셀을 받고 분류 결과를 출력하는 대회의 외부 동작은 유지하고, 내부의 연산부와 저장 구조를 재설계했습니다.

합성곱은 타일 생성, 입력 변환, MAC, 출력 변환과 후처리 순서로 진행됩니다. 단계 사이의 작은 FIFO는 일시적인 처리 속도 차이를 흡수하고, 다음 단계가 받을 수 있을 때 데이터를 전달합니다.

[왼쪽 아래 재사용 그림을 짚는다.]

Conv1, Conv2와 완전연결층은 하나의 16-lane MAC 배열을 공유합니다. 중간 결과는 같은 FF scratchpad를 통해 전달하고, 완전연결층에서는 변환을 우회합니다. Bias, ReLU, pooling과 재양자화도 타일 단위로 이어서 처리합니다.

[MAC 배열을 짚은 뒤 오른쪽 변환 회로로 이동한다.]

연산 선택의 단위는 행입니다. MAC 네 개가 한 묶음이 되어, 변환된 4×4 타일의 각 행을 처리합니다.

[변환 행렬, 덧셈·뺄셈 회로, 중간 레지스터를 짚는다.]

입력 변환은 열 방향과 행 방향의 두 단계로 나눴습니다. 첫 번째 결과를 이 레지스터에 저장하고, 두 번째 변환에서는 각 행 안의 값들을 조합합니다.

따라서 중간값의 한 행이 모두 0이면 나머지 변환 후에도 0으로 남아, 대응하는 MAC 연산을 생략할 수 있습니다.

[NOR와 Row mask 박스를 짚는다.]

기존 레지스터의 비트를 행별로 NOR 검사해, 생략 가능 여부를 한 비트씩 표시합니다. 이 결과가 4비트 행 마스크입니다.

[아래 왼쪽 Row compaction 그림을 짚는다.]

합성곱에서는 여러 입력 채널의 계산값을 누적합니다. 각 행은 자기 위치의 값들을 채널 순서대로 누적합니다.

어떤 채널의 행이 0이면, 다음 유효 채널의 같은 위치의 행을 앞당겨 넣고 가중치도 맞춰 가져옵니다.

한 사이클에 처리하는 네 행은 서로 다른 채널에서 가져와도, 누적 위치와 계산 순서는 유지됩니다. 그림에서는 세 채널의 유효 행을 모아 MAC 투입을 세 번에서 두 번으로 줄였습니다.

이렇게 0인 행을 건너뛰고 남은 작업을 앞당기는 것이 스케줄 압축입니다.

[오른쪽 Zero-tile bypass 그림을 짚는다.]

모든 입력 채널에서 유효한 행이 없으면 MAC과 출력 변환을 우회합니다. Bias 같은 후처리와 출력 순서는 유지해 같은 결과를 내도록 했습니다.

4번. Clock Gating

[MAC 레지스터 경로를 짚는다.]

연산을 생략하더라도 레지스터에 클럭이 계속 공급되면 클럭 활동에 따른 전력 소모는 남습니다. 이를 줄이기 위해 클럭 게이팅을 적용했습니다.

[위쪽 ICG 셀 그림을 짚는다.]

RTL의 동작뿐 아니라, 합성 후 어떤 표준셀로 구현되는지도 중요합니다. ASAP7 라이브러리에서 래치와 클럭 게이트가 통합된 전용 ICG 셀을 찾아 매핑했고, 합성 결과에서도 16개가 사용된 것을 확인했습니다.

내부 래치가 클럭이 낮을 때 enable을 받아두고 높은 동안 유지해, 클럭 펄스가 중간에 잘리는 것을 방지합니다.

[아래 곱셈 결과·누산·최종 결과 레지스터를 짚는다.]

곱셈 결과, 누산값, 최종 결과 레지스터를 각각 갱신할 때만 클럭을 공급합니다. 연산 생략과 함께 불필요한 클럭 활동도 억제했습니다.

5번. Single-Core Results

[왼쪽 비교 그래프를 짚는다.]

결과는 ASAP7 예측 7나노미터 라이브러리를 사용한 합성 후 평가입니다.

왼쪽은 커널 변경 등을 포함한 최종 구현과 대회 참조 보고값의 비교입니다. 이미지당 사이클은 약 25.4%, 셀 면적은 약 68.7% 감소했습니다. 대회 참조 연산량으로 정규화한 에너지 효율 지표는 46.51 TOPS/W입니다.

[가운데 두 그래프를 짚는다.]

각 기법의 효과는 동일한 입력과 클럭 조건에서 따로 비교했습니다. 여기서는 ICG를 공통으로 켠 상태에서, zero-row 생략을 추가했을 때의 변화를 보여줍니다.

왼쪽을 보시면 Conv1과 Conv2 모두 MAC에 투입하는 연산이 절반 이상 줄었습니다. 그런데 오른쪽의 실행 사이클은 서로 다르게 나타납니다.

Conv1은 외부에서 한 사이클에 한 픽셀씩 입력받습니다. 연산을 빨리 끝내더라도 다음 입력을 기다려야 하므로 전체 사이클은 거의 줄지 않습니다.

반면 Conv2는 내부 scratchpad에서 데이터를 공급받기 때문에, 생략한 연산만큼 남은 작업을 앞당길 수 있습니다. 그 결과 실행 사이클이 약 31.8% 감소했습니다.

[오른쪽 에너지 그래프를 짚는다.]

전체 추론에서는 평균 사이클이 7.11%, 이미지당 에너지가 15.02% 추가로 감소했습니다.

여기서 확인한 점은 연산량을 줄이는 것과 처리시간을 줄이는 것은 구분해야 한다는 것입니다. 이 차이가 생기는 조건을 더 큰 모델에서도 살펴봤습니다.

6번. Multicore Architecture

[왼쪽 CIFAR-10 이미지와 VGG 모델을 짚는다.]

자유주제에서는 입력 자체에 0이 많은 MNIST에서 나아가, 자연이미지의 activation에서도 기법이 유효한지 확인하고자 CIFAR-10을 선택했습니다.

모델은 합성곱층 열세 개와 완전연결층 세 개로 구성된 VGG-16-BN이며, 추론 파라미터는 약 1,525만 개입니다.

[16코어 아키텍처와 출력 채널 분할 그림을 짚는다.]

기존 코어의 Winograd, zero-row skipping과 ICG를 유지하면서 16코어로 확장했습니다. 출력 채널 방향으로 분할해, 각 코어가 서로 다른 필터를 맡고 출력 특징맵의 일부를 계산합니다.

코어마다 계산하는 출력은 다르지만 입력 activation은 공통입니다. 이 분할 방식을 선택하면 여러 코어가 같은 입력 데이터를 필요로 합니다.

[Multicast 경로를 짚는다.]

이 데이터를 개별적으로 반복 전송하는 비용을 줄이기 위해 multicast를 사용했습니다. 한 번 발행한 데이터를 여러 코어에 함께 전달합니다.

각 코어의 출력도 다음 계층에서는 공통 입력의 일부가 됩니다. 저장한 결과를 multicast로 공유해 다음 계층의 계산으로 연결합니다.

[SRAM 그림을 짚는다.]

저장 용량이 커지면 FF 배열만으로 보관하는 것도 부담이 됩니다. ASAP7용 오픈소스 SRAM 매크로 모델을 찾아 합성 흐름에 연결하고, 대용량 저장부를 SRAM 매크로로 구현했습니다.

코어별 SRAM에 담당 가중치와 중간 데이터를 저장·재사용하고, 다음 계층의 공통 입력은 multicast 경로로 공유합니다.

7번. Multi-Core Results

[위쪽 MAC 연산량 그래프를 짚는다.]

위 그래프는 CIFAR-10 이미지 한 장의 합성곱 연산량입니다. Direct의 약 3억 1,320만 MAC이 Winograd로 약 1억 3,920만, zero-row skipping까지 적용하면 약 9,638만으로 줄었습니다.

Winograd 이후에도 MAC 연산을 추가로 30.76% 줄였습니다. Direct는 이론값이며, 변환과 완전연결층은 집계에서 제외했습니다.

하지만 타일 생성과 변환, 데이터 공급도 필요하므로 연산량 감소만으로 전체 성능과 에너지 효율을 판단할 수는 없습니다.

[아래 공급 속도별 그래프를 짚는다.]

가중치를 코어에 상주시킨 뒤 변환 후 zero-row 비율과 입력 공급 간격을 바꿨습니다. 같은 코어에서도 공급에 따라 효과가 어떻게 달라지는지 비교했습니다.

[50% 지점의 파란색 선과 회색 선을 차례로 짚는다.]

Zero-row 비율이 50%일 때, 매 사이클 한 워드를 공급하면 사이클은 약 39.3%, 이미지당 에너지는 약 41.6% 감소했습니다. 데이터가 준비되어 있어 남은 연산을 바로 이어서 처리할 수 있기 때문입니다.

여덟 사이클에 한 워드를 공급하면 각각 약 4.9%, 8.9%로 제한됩니다. 연산을 생략해도 입력 대기 시간은 남기 때문입니다.

별표는 실제 VGG 레이어의 코어 단위 측정입니다. Activation 분포와 텐서 크기에 따라 절감 효과가 다르게 나타났습니다.

[6번 SRAM·multicast 구조와 7번 결과를 함께 짚는다.]

Winograd와 sparsity의 효과를 살리려면 연산부의 처리율과 SRAM·통신망의 공급 능력을 함께 맞춰야 합니다.

PPA 관점에서는 공급 구조의 면적과 전력도 고려해야 합니다. 주어진 자원 안에서 대기 시간을 줄여야 곱셈 절감이 실제 성능과 에너지 이득으로 이어집니다.

마무리

정리하면, Winograd로 곱셈 수를 줄이고 행 단위 skipping과 스케줄 압축, 전용 ICG 셀로 불필요한 연산과 클럭 활동을 억제했습니다.

이를 단일코어에서 검증하고 SRAM과 multicast를 갖춘 16코어로 확장했습니다.

앞으로는 SRAM 접근과 통신, 외부 가중치 공급을 개선해 전체 시스템에서도 절감 효과를 더 충분히 활용하겠습니다.

이상으로 발표를 마치겠습니다. 감사합니다.
