jbpark0616/IDEC_Challenge/free_topic_vgg/architecture/DESIGN_FREEZE_20261030.txt

자유주제 설계 기준본 고정 — 2026-10-30
====================================

사용자 지시: 현재 설계를 fix하고, 임의로 변경하지 않는다.

기준
  현재 작업 트리의 rtl/sources.f와 그 소스 28개.
  최상위 vgg_sixteen_core_cluster, 16코어, 코어당 16 MAC lane.
  코어당 SRAM 12개 x 8KiB = 96KiB. U8/V8 기본 설정 유지.
  공유 activation feed가 SRAM에서 타일 순서로 읽어 기존 multicast로 공급.
  코어의 고정 크기 4x4 타일 조립부 -> input transform -> V SRAM 재사용
  -> 기존 row MAC -> output transform/postprocess 경로 유지.
  FC 경로, mask/bypass/ICG, A/B 역할 전환, U 적재 및 V 해제 정책 유지.
  기존 TILE_INPUT=0 경로는 소스에 남아 있지만 메인 TILE_INPUT=1을 대체하지 않는다.

증거와 한계
  evidence/single_core_fixed_window/REPORT_KO.txt가 최신 단일 코어 합성 근거.
  FF 12,970, SRAM 12개, 배치배선 전 추정 약 560MHz; 1GHz 미달.
  고정 타일 공급 버전의 전체 VGG 재검증/큰 레이어 전후 사이클 비교는 미완료.
  설계 고정은 모든 성능 목표가 검증되었다는 뜻이 아니다.

변경 규칙
  RTL, 메모리 배치, 스케줄/재사용, 포트/파라미터 및 메인 소스 선택은
  사용자가 해당 변경을 승인하기 전까지 수정하지 않는다.
  테스트/프로파일링/합성 요청으로 설계 변경까지 허용되었다고 해석하지 않는다.
  문제 발견 시 위치와 영향, 수정안을 먼저 보고한다.
  테스트는 현재 기준본으로 실행하고 결과에 소스 해시를 기록한다.
  코드 정리도 RTL 변경이면 먼저 범위를 승인받는다.
  지정주제 verilog/는 별도 최종본으로 보존한다.

보존
  evidence/design_freeze_20261030/source_snapshot/ : 현재 소스 복사본
  evidence/design_freeze_20261030/manifest.json : 상대경로와 SHA256
  Git commit/push는 이번 고정 작업에 포함하지 않는다.
