jbpark0616/IDEC_Challenge/free_topic_vgg/evidence/cluster_bottleneck/REPORT_KO.txt

Conv5 병목 실측 — 원본 RTL, 즉시 요청 응답 TB
입력 [1,8,8,128], 출력256, 16코어, U 전체상주. 이미지1장.
RTL 계측은 read-only. 측정 전후 해시 일치. 기존 즉시TB와 사이클 동일.
모든 최종 출력 2048word/실행 golden 일치. OFF/ON 2회 PASS.

1. 공급기 사이클 분해 (서로 배타적인 상태 카운터)
BUILD hit는 새로 읽은 워드의 재시도도 포함하므로 cache reuse hit rate가 아니다.
sparse=0, total=110446, sampled_RUN=110445, last_feed=108033
픽셀 조립(hit+pad)=32768; 미스 판정=25088; 요청상태=25088; 응답상태=25088; drain=1; 기타(주로feed완료후)=2412
downstream 정지=0, 요청 추가대기=0, 응답 추가대기=0
전송=4096word, 고유 source word=1024
sparse=1, total=110311, sampled_RUN=110310, last_feed=108033
픽셀 조립(hit+pad)=32768; 미스 판정=25088; 요청상태=25088; 응답상태=25088; drain=1; 기타(주로feed완료후)=2277
downstream 정지=0, 요청 추가대기=0, 응답 추가대기=0
전송=4096word, 고유 source word=1024

2. 코어별 계측 (서로 다른 그룹의 카운터는 중첩 가능; 합산 금지)
sparse=0
core0: MACbeats=32768 V미도착=74213 operand요청거절=0 MACready대기=0 weight상태=1039 RX미도착=106349 RX막힘=0 완료위치=110068
core1: MACbeats=32768 V미도착=73838 operand요청거절=0 MACready대기=0 weight상태=1439 RX미도착=106349 RX막힘=0 완료위치=110093
core2: MACbeats=32768 V미도착=73455 operand요청거절=0 MACready대기=0 weight상태=1839 RX미도착=106349 RX막힘=0 완료위치=110118
core3: MACbeats=32768 V미도착=73083 operand요청거절=0 MACready대기=0 weight상태=2255 RX미도착=106349 RX막힘=0 완료위치=110143
core4: MACbeats=32768 V미도착=72708 operand요청거절=0 MACready대기=0 weight상태=2650 RX미도착=106349 RX막힘=0 완료위치=110168
core5: MACbeats=32768 V미도착=72342 operand요청거절=0 MACready대기=0 weight상태=3047 RX미도착=106349 RX막힘=0 완료위치=110193
core6: MACbeats=32768 V미도착=71967 operand요청거절=0 MACready대기=0 weight상태=3450 RX미도착=106349 RX막힘=0 완료위치=110218
core7: MACbeats=32768 V미도착=71595 operand요청거절=0 MACready대기=0 weight상태=3853 RX미도착=106349 RX막힘=0 완료위치=110243
core8: MACbeats=32768 V미도착=71220 operand요청거절=0 MACready대기=0 weight상태=4247 RX미도착=106349 RX막힘=0 완료위치=110268
core9: MACbeats=32768 V미도착=70853 operand요청거절=0 MACready대기=0 weight상태=4650 RX미도착=106349 RX막힘=0 완료위치=110293
core10: MACbeats=32768 V미도착=70485 operand요청거절=0 MACready대기=0 weight상태=5058 RX미도착=106349 RX막힘=0 완료위치=110318
core11: MACbeats=32768 V미도착=70110 operand요청거절=0 MACready대기=0 weight상태=5442 RX미도착=106349 RX막힘=0 완료위치=110343
core12: MACbeats=32768 V미도착=69735 operand요청거절=0 MACready대기=0 weight상태=5850 RX미도착=106349 RX막힘=0 완료위치=110368
core13: MACbeats=32768 V미도착=69368 operand요청거절=0 MACready대기=0 weight상태=6258 RX미도착=106349 RX막힘=0 완료위치=110393
core14: MACbeats=32768 V미도착=68996 operand요청거절=0 MACready대기=0 weight상태=6653 RX미도착=106349 RX막힘=0 완료위치=110418
core15: MACbeats=32768 V미도착=68625 operand요청거절=0 MACready대기=0 weight상태=7042 RX미도착=106349 RX막힘=0 완료위치=110443
sparse=1
core0: MACbeats=31185 V미도착=75654 operand요청거절=0 MACready대기=0 weight상태=1039 RX미도착=106214 RX막힘=0 완료위치=109933
core1: MACbeats=31185 V미도착=75280 operand요청거절=0 MACready대기=0 weight상태=1443 RX미도착=106214 RX막힘=0 완료위치=109958
core2: MACbeats=31185 V미도착=74910 operand요청거절=1 MACready대기=0 weight상태=1842 RX미도착=106214 RX막힘=0 완료위치=109983
core3: MACbeats=31185 V미도착=74539 operand요청거절=0 MACready대기=0 weight상태=2247 RX미도착=106214 RX막힘=0 완료위치=110008
core4: MACbeats=31185 V미도착=74163 operand요청거절=0 MACready대기=0 weight상태=2643 RX미도착=106214 RX막힘=0 완료위치=110033
core5: MACbeats=31185 V미도착=73790 operand요청거절=0 MACready대기=0 weight상태=3045 RX미도착=106214 RX막힘=0 완료위치=110058
core6: MACbeats=31185 V미도착=73418 operand요청거절=0 MACready대기=0 weight상태=3450 RX미도착=106214 RX막힘=0 완료위치=110083
core7: MACbeats=31185 V미도착=73050 operand요청거절=0 MACready대기=0 weight상태=3843 RX미도착=106214 RX막힘=0 완료위치=110108
core8: MACbeats=31185 V미도착=72675 operand요청거절=0 MACready대기=0 weight상태=4244 RX미도착=106214 RX막힘=0 완료위치=110133
core9: MACbeats=31185 V미도착=72305 operand요청거절=0 MACready대기=0 weight상태=4644 RX미도착=106214 RX막힘=0 완료위치=110158
core10: MACbeats=31185 V미도착=71933 operand요청거절=0 MACready대기=0 weight상태=5047 RX미도착=106214 RX막힘=0 완료위치=110183
core11: MACbeats=31185 V미도착=71562 operand요청거절=0 MACready대기=0 weight상태=5451 RX미도착=106214 RX막힘=0 완료위치=110208
core12: MACbeats=31185 V미도착=71192 operand요청거절=0 MACready대기=0 weight상태=5850 RX미도착=106214 RX막힘=0 완료위치=110233
core13: MACbeats=31185 V미도착=70819 operand요청거절=0 MACready대기=0 weight상태=6249 RX미도착=106214 RX막힘=0 완료위치=110258
core14: MACbeats=31185 V미도착=70448 operand요청거절=0 MACready대기=0 weight상태=6650 RX미도착=106214 RX막힘=0 완료위치=110283
core15: MACbeats=31185 V미도착=70076 operand요청거절=0 MACready대기=0 weight상태=7050 RX미도착=106214 RX막힘=0 완료위치=110308

3. 확정할 수 있는 원인
독립 주소 재생 address_audit.json: 유효 픽셀25088회마다 cache miss. 재사용hit=0.
HWC C128: spatial pixel 간 word address 간격16. cache index는 word[1:0].
서로 다른 공간 픽셀이 같은 cache entry를 덮어써 다음 채널의 같은 word를 재사용하지 못함.
8KiB 원본을 25088*8=200704byte(196KiB) 읽음. 고유word1024, 평균24.5회 재독.
유효 픽셀마다 미스판정/요청/응답/픽셀조립 4사이클; padding7680개는 각1사이클.
25088*4 + 7680 =108032, drain 포함 마지막 공급108033과 일치.
SRAM 추가 wait나 multicast backpressure 없이도 공급기 FSM만으로 이 시간이 필요.
bypass는 공급기 주소순서/전송량을 바꾸지 않아 OFF/ON 공급완료시점이 동일.
코어의 작업 감소는 상당부분 V미도착 대기 증가로 바뀐다.
이 결론은 이 HWC Conv5 측정에 해당. sharded/다른shape/비상주U에 자동 일반화하지 않음.
이번에는 수정하지 않음. 개선 우선순위는 같은64bit워드의8채널 재사용과 요청/응답 파이프라인.
처리순서/출력/재사용 수명을 유지하는 제한된 공급기 수정 후 동일시험으로 검증해야 함.
