jbpark0616/IDEC_Challenge/free_topic_vgg/evidence/cluster_immediate/REPORT_KO.txt

원본 16코어 Conv5 — TB 요청 즉시 서비스 비교
입력 [1,8,8,128], 출력256, 코어당 U32KiB 전체 상주. 같은 이미지/RTL/포트/벡터.
변경: TB status fetch polling만 read-only request descriptor 관찰로 교체.
연속 전송 최대64bit/cycle, 공유 호스트 포트와 ready/valid 유지.
16코어 동시 무제한 전송이나 DUT 내부 쓰기/force 없음.
초기 적재 제외 실행 cycles 비교. 실제 SRAM/tile feed/multicast 포함.

sparse=0: 110512 -> 110446, saved=66 cycles (0.0597%). MAC=8388608, U_words=65536, source_reads=25088, requests=496
sparse=1: 110375 -> 110311, saved=64 cycles (0.0580%). MAC=7578624, U_words=65536, source_reads=25088, requests=496
bypass cycle reduction: previous=0.1240%, immediate=0.1222%
OFF/ON 각각 최종 SRAM 2048 word golden 일치. MAC/U/source read/request 수 이전과 동일.
결론: 이 레이어의 낮은 bypass cycle 효과는 TB polling만으로 설명되지 않는다.
메타데이터의 실제 포트 전송 비용은 남아 있다. 다른 레이어로 일반화하지 않는다.
전체 build+run 경과=302.7초
