jbpark0616/IDEC_Challenge/free_topic_vgg/evidence/feed8_bypass_audit/REPORT_KO.txt

8채널 공급기 bypass / 병목 계측
================================
16코어 U8/V8, 동일 이미지 HWC 독립 레이어, 초기 적재 제외 / 실행 중 U 공급 포함.
원본 RTL 수정 없음. 계측 전후 cycles/MAC lanes/weight waits 정확히 일치.
모든 출력 golden 검증. 전력 및 합성 주파수는 이번 시험의 측정 대상이 아님.

Conv3 [1,16,16,64] -> Cout128
 cycles 37,121 -> 36,071: 2.8286% 감소
 MAC lanes 8,388,608 -> 7,975,936: 4.9194% 감소
 MAC beats (16코어 합) 524,288 -> 508,672: 2.9785% 감소
 코어당 평균 beat 절감=976.00, 전체 wall-cycle 절감=1,050
 OFF feed: cycles=37,120, emit=8,192, pad=992, prepare=7,200, blocked=4,475, request=7,200, request_stall=0, response=7,200, response_stall=0, finished=1,861, other=0, words=8,192, last_feed=35,259, unique_reads=2,048
 OFF core0: core=0, wait_v_slot=65, job=512, mac_state=36,531, weights=0, done=12, mac_beats=32,768, v_missing=317, row_blocked=0, mac_blocked=0, busy_other=3,446, rx_missing=19,757, rx_blocked=8,217, producer_no_tile=14,773, finish=37,117
 OFF v_missing: min=317 max=317 mean=317.00 core-cycles
 OFF row_blocked: min=0 max=0 mean=0.00 core-cycles
 OFF mac_blocked: min=0 max=0 mean=0.00 core-cycles
 OFF weights: min=0 max=0 mean=0.00 core-cycles
 OFF producer_no_tile: min=14,773 max=14,773 mean=14773.00 core-cycles
 OFF finish: min=37,117 max=37,117 mean=37117.00 core-cycles
 ON feed: cycles=36,070, emit=8,192, pad=992, prepare=7,200, blocked=3,545, request=7,200, request_stall=0, response=7,200, response_stall=0, finished=1,741, other=0, words=8,192, last_feed=34,329, unique_reads=2,048
 ON core0: core=0, wait_v_slot=65, job=512, mac_state=35,481, weights=0, done=12, mac_beats=31,792, v_missing=319, row_blocked=5, mac_blocked=0, busy_other=3,365, rx_missing=19,750, rx_blocked=7,184, producer_no_tile=15,010, finish=36,067
 ON v_missing: min=319 max=319 mean=319.00 core-cycles
 ON row_blocked: min=5 max=5 mean=5.00 core-cycles
 ON mac_blocked: min=0 max=0 mean=0.00 core-cycles
 ON weights: min=0 max=0 mean=0.00 core-cycles
 ON producer_no_tile: min=15,010 max=15,010 mean=15010.00 core-cycles
 ON finish: min=36,067 max=36,067 mean=36067.00 core-cycles

Conv5 [1,8,8,128] -> Cout256
 cycles 36,833 -> 35,222: 4.3738% 감소
 MAC lanes 8,388,608 -> 7,578,624: 9.6558% 감소
 MAC beats (16코어 합) 524,288 -> 498,448: 4.9286% 감소
 코어당 평균 beat 절감=1615.00, 전체 wall-cycle 절감=1,611
 OFF feed: cycles=36,832, emit=4,096, pad=960, prepare=3,136, blocked=14,334, request=3,136, request_stall=0, response=3,136, response_stall=0, finished=8,034, other=0, words=4,096, last_feed=28,798, unique_reads=1,024
 OFF core0: core=0, wait_v_slot=17, job=256, mac_state=35,103, weights=1,039, done=417, mac_beats=32,768, v_missing=621, row_blocked=0, mac_blocked=0, busy_other=1,714, rx_missing=20,491, rx_blocked=11,764, producer_no_tile=11,383, finish=36,424
 OFF v_missing: min=621 max=621 mean=621.00 core-cycles
 OFF row_blocked: min=0 max=0 mean=0.00 core-cycles
 OFF mac_blocked: min=0 max=0 mean=0.00 core-cycles
 OFF weights: min=1,039 max=1,475 mean=1249.75 core-cycles
 OFF producer_no_tile: min=7,126 max=11,383 mean=9199.88 core-cycles
 OFF finish: min=36,424 max=36,829 mean=36634.75 core-cycles
 ON feed: cycles=35,221, emit=4,096, pad=960, prepare=3,136, blocked=13,284, request=3,136, request_stall=0, response=3,136, response_stall=0, finished=7,473, other=0, words=4,096, last_feed=27,748, unique_reads=1,024
 ON core0: core=0, wait_v_slot=17, job=256, mac_state=33,488, weights=1,039, done=421, mac_beats=31,153, v_missing=624, row_blocked=1, mac_blocked=0, busy_other=1,710, rx_missing=19,938, rx_blocked=10,707, producer_no_tile=11,406, finish=34,809
 ON v_missing: min=624 max=624 mean=624.00 core-cycles
 ON row_blocked: min=0 max=4 mean=1.31 core-cycles
 ON mac_blocked: min=0 max=0 mean=0.00 core-cycles
 ON weights: min=1,039 max=1,474 mean=1247.75 core-cycles
 ON producer_no_tile: min=7,133 max=11,406 mean=9243.38 core-cycles
 ON finish: min=34,809 max=35,218 mean=35016.88 core-cycles

Conv11 [1,2,2,512] -> Cout512
 cycles 466,426 -> 466,243: 0.0392% 감소
 MAC lanes 4,194,304 -> 3,563,520: 15.0391% 감소
 MAC beats (16코어 합) 262,144 -> 248,832: 5.0781% 감소
 코어당 평균 beat 절감=832.00, 전체 wall-cycle 절감=183
 OFF feed: cycles=466,425, emit=1,024, pad=768, prepare=256, blocked=0, request=256, request_stall=0, response=256, response_stall=0, finished=463,865, other=0, words=1,024, last_feed=2,560, unique_reads=256
 OFF core0: core=0, wait_v_slot=2, job=32, mac_state=18,540, weights=386,204, done=61,647, mac_beats=16,384, v_missing=1,805, row_blocked=0, mac_blocked=0, busy_other=351, rx_missing=465,017, rx_blocked=320, producer_no_tile=1,036, finish=404,787
 OFF v_missing: min=1,805 max=1,805 mean=1805.00 core-cycles
 OFF row_blocked: min=0 max=0 mean=0.00 core-cycles
 OFF mac_blocked: min=0 max=0 mean=0.00 core-cycles
 OFF weights: min=386,204 max=447,839 mean=417021.50 core-cycles
 OFF producer_no_tile: min=1,036 max=1,036 mean=1036.00 core-cycles
 OFF finish: min=404,787 max=466,422 mean=435604.50 core-cycles
 ON feed: cycles=466,242, emit=1,024, pad=768, prepare=256, blocked=0, request=256, request_stall=0, response=256, response_stall=0, finished=463,682, other=0, words=1,024, last_feed=2,560, unique_reads=256
 ON core0: core=0, wait_v_slot=2, job=32, mac_state=17,733, weights=386,828, done=61,647, mac_beats=15,552, v_missing=1,830, row_blocked=0, mac_blocked=0, busy_other=351, rx_missing=464,834, rx_blocked=320, producer_no_tile=1,036, finish=404,604
 ON v_missing: min=1,830 max=1,830 mean=1830.00 core-cycles
 ON row_blocked: min=0 max=0 mean=0.00 core-cycles
 ON mac_blocked: min=0 max=0 mean=0.00 core-cycles
 ON weights: min=386,828 max=448,463 mean=417645.50 core-cycles
 ON producer_no_tile: min=1,036 max=1,036 mean=1036.00 core-cycles
 ON finish: min=404,604 max=466,239 mean=435421.50 core-cycles

해석
Conv3/5: OFF에서 코어당 32,768 MAC beat가 실행되며 V 미도착 대기는 각각317/621이다.
Conv5: 코어당 beat 감소1,615회에 대해 wall-cycle 감소1,611이다. 생략된 beat의 시간 이득이 거의 보존된다.
lane 수 감소는 같은 beat 안의 일부 lane 비활성화도 포함하므로 beat/사이클 감소와 동일하지 않다.
Conv11 OFF: activation 공급은2,560에 끝난다. 최종 코어15의 C_WEIGHTS 체류는447,839이다.
이 경우 activation/V 포트보다 U 가중치 전환 및 공급 대기가 주된 실행시간을 차지한다.
공급기 출력 역압은 downstream이 받아줄 수 없다는 뜻이며 SRAM read 자체가 느리다는 뜻이 아니다.
다음 최적화 후보는 비상주 U의 전송/전환과 연산 중첩이다. 이 실험에서는 구조를 바꾸지 않았다.

계측 정의
feed: emit=출력 handshake, pad=padding 준비, prepare=유효 위치 주소 준비,
request/response=상태 체류시간. *_stall은 해당 상태 안에서 handshake가 없던 부분집합.
blocked=출력 역압, finished=공급 완료 뒤 cluster 실행이 끝날 때까지의 시간.
feed 상태 항목 합계는 audit_cycles와 일치하도록 TB에서 검사한다.
core: weights=C_WEIGHTS 체류, wait_v_slot=C_WAIT 체류, job=C_JOB, mac_state=C_MAC.
v_missing=engine busy 중 남은 유효 채널이 없고 reduction 완료도 아닌 시간.
MAC acceptance > MAC blocked > V missing > row blocked > busy other 우선순위로 분류.
따라서 row_blocked는 이전 MAC beat 수락과 겹치지 않는 read 거절만 센다.
producer_no_tile/rx_missing은 다른 카운터와 중첩하므로 총 사이클에 더하지 않는다.
16코어 대기 합계는 wall-clock 사이클과 다르다. min/max/mean은 코어별 통계다.
V missing은 데이터 미도착 상태의 지표이며 SRAM 포트 충돌이라는 뜻이 아니다.
실행 중 weight 대기와 다른 코어 연산은 겹칠 수 있어 개별 시간을 단순 합산하지 않는다.
