jbpark0616/IDEC_Challenge/free_topic_vgg/evidence/feed8_bypass_audit/REPORT_SELECTION_KO.txt

보고서 본문용 결과 선별 — 추가 실험 중단
======================================
선별 범위: U 상주 + HWC 연속 저장 + 8채널 공급 개선 적용.
동일 실제 이미지, 16코어 U8/V8. 초기 적재 제외, 실행 중 제어/공급 포함.
전체 출력 golden 일치. 원본 RTL 수정 없음.

레이어  입력 NHWC          Cout  cycles OFF -> ON  beat 감소  lane 감소  cycle 감소
Conv3   [1,16,16,64]       128   37121 -> 36071    2.9785%    4.9194%    2.8286%
Conv5   [1,8,8,128]        256   36833 -> 35222    4.9286%    9.6558%    4.3738%

핵심 근거: Conv5 코어당 MAC beat가 1615회 감소하고 실행 사이클은1611 감소.
주장: 이 두 조건에서는 생략한 MAC beat의 시간 이득이 전체 실행시간에 반영된다.
lane 연산량 감소율과 사이클 감소율은 동일한 지표가 아니다.

본문 밖에 남길 한계:
- Conv11은 U 비상주. 가중치 공급 대기가 지배하므로 위 비교 범위에서 제외.
- Conv2는 U 상주지만 분산 activation 경로로 원본 공급기 fallback 사용.
  추가 실측 754658 -> 754610, cycle 절감0.00636%. HWC8 개선 결과로 표시하지 않는다.
- Conv4 추가 시험은 사용자 요청으로 도중 중단. 완료된 OFF/ON 쌍이 없으므로 사용하지 않는다.
- 선택한 두 레이어를 VGG 전체의 평균 효과라고 표현하지 않는다.
- 전력 감소율은 이번 cycle/MAC 계측으로 직접 측정한 값이 아니다.

원자료: 이 폴더 results.json, conv3_sparse*.log, conv5_sparse*.log, provenance.json.
분산 경로 추가 기록: ../feed8_resident_more/results.json.
새 시뮬레이션이나 합성은 실행하지 않는다.
