jbpark0616/IDEC_Challenge/free_topic_vgg/evidence/feed_group_sweep/REPORT_KO.txt

4채널/8채널 공급기 비교 — 원본 보존
================================
동일 원본16코어, U8/V8, 같은 이미지, 같은 즉시응답 shared host TB.
전체 출력 golden 일치, 원본 RTL 해시 일치. 초기 적재 제외 실행시간.
4채널: 64byte staging, 같은64bit word의 나머지4채널은 다음 묶음에서 재독.
8채널: 128byte staging, 한64bit word의8채널 모두 재사용.
두 변형 모두 HWC에 한정, 기존 sharded/FC fallback 유지. 합성/PPA 미측정.
비교하는 채널 묶음은 memory transport 단위이며 MAC lane 수 변경 아님.

Conv3: [1,16,16,64] -> Cout128
 original: OFF=238,837 ON=238,823 bypass=0.0059% source_reads=57,600 OFFspeedup=1.0000x U_words=16,384 resident=1
 group4: OFF=53,879 ON=53,865 bypass=0.0260% source_reads=14,400 OFFspeedup=4.4328x U_words=16,384 resident=1
 group8: OFF=37,121 ON=36,071 bypass=2.8286% source_reads=7,200 OFFspeedup=6.4340x U_words=16,384 resident=1

Conv5: [1,8,8,128] -> Cout256
 original: OFF=110,446 ON=110,311 bypass=0.1222% source_reads=25,088 OFFspeedup=1.0000x U_words=65,536 resident=1
 group4: OFF=37,373 ON=35,757 bypass=4.3240% source_reads=6,272 OFFspeedup=2.9552x U_words=65,536 resident=1
 group8: OFF=36,833 ON=35,222 bypass=4.3738% source_reads=3,136 OFFspeedup=2.9986x U_words=65,536 resident=1

Conv11: [1,2,2,512] -> Cout512
 original: OFF=478,196 ON=478,013 bypass=0.0383% source_reads=2,048 OFFspeedup=1.0000x U_words=524,288 resident=0
 group4: OFF=467,958 ON=467,775 bypass=0.0391% source_reads=512 OFFspeedup=1.0219x U_words=524,288 resident=0
 group8: OFF=466,426 ON=466,243 bypass=0.0392% source_reads=256 OFFspeedup=1.0252x U_words=524,288 resident=0

해석 및 범위
- Conv3/5는 U 상주, Conv11은 U 비상주 조건이다.
- 실제 입력 C=4 및 C=12도 별도 공급기 단위시험에서 정상/역압 조건으로 검증했다.
- 레이어 비교의 group4는 입력 C를 줄인 것이 아니라 전송 묶음을 4채널로 한 것이다.
- 4채널 변형은 저장소를 절반으로 줄이는 대신 C가 8의 배수일 때 읽기가 8채널의 두 배다.
- 초기 activation/weight 적재는 사이클에서 제외하되 실행 중 weight 공급은 포함한다.
- 한 이미지의 독립 레이어 시험이다. 전체 모델 시간/정확도 및 sharded 경로 개선 주장이 아니다.
- MAC 투입 횟수 감소는 실측 전력/에너지 감소율과 같지 않다.
- 원본 RTL 수정 없음. 면적, 최대 주파수, 전력은 이 변형에 대해 아직 측정하지 않았다.
