jbpark0616/IDEC_Challenge/free_topic_vgg/evidence/multicast_profile/SUPPLY_REPORT_KO.txt

SRAM 공급 경로 통제 비교 — RTL 변경 없음
반복 적재: 하나의64-bit 외부 포트로 각 코어 SRAM에 HWC 데이터를16회 적재. 각 코어 적재 직후 독립 activation_feed가 시작하며 이후 코어 적재와 중첩된다.
단일 적재+멀티캐스트: core0 SRAM에1회 적재 후 실제 activation_feed(TILE_STREAM=1) -> fanout ->16개 RX FIFO.
비교용 반복 적재 경로의16개 독립 feed는 테스트벤치 구성이다. 현재 메인 칩에16개 feed가 있다는 뜻이 아니다.
양쪽 실제 activation_sram, 제공된 SRAM behavioral macro, activation_feed, elastic_fifo를 사용했다.
첫 host write 제공부터 모든 코어가 마지막 tile word를 소비하고 FIFO가 비워질 때까지 측정.
padding/4x4 타일/입력채널 순서를 독립 HWC oracle와 모든 수신 word에 대해 비교했다. 12회 통과.
수신측 항상ready. 실제 MAC backpressure, DRAM command latency, weight traffic는 포함하지 않는다.
외부 공급률1word/cycle 또는1word/4cycles. 이는64-bit host 경계의 공급률이다.
이 결과는 SRAM 공급 subsystem 비교이며 full-model 가속비나 물리 DRAM 실측이 아니다.
(a) 통신블록은payload 자체를 전송, (b) 공급경로는HWC를타일로 확장하므로 패널간 절대cycles를 직접 비교하지 않는다.

{'input_NHWC': '[1,4,4,32]', 'bytes': 512, 'period': 1, 'repeated_load_cycles': 6531, 'single_load_mcast_cycles': 5572, 'speedup': 1.1721105527638191, 'reduction_percent': 14.683815648445876, 'external_bytes_repeated': 8192, 'external_bytes_mcast': 512, 'repeated_load_phase': 1024, 'mcast_load_phase': 64, 'tile_words_per_receiver': 256}
{'input_NHWC': '[1,4,4,32]', 'bytes': 512, 'period': 4, 'repeated_load_cycles': 9600, 'single_load_mcast_cycles': 5761, 'speedup': 1.6663773650407916, 'reduction_percent': 39.989583333333336, 'external_bytes_repeated': 8192, 'external_bytes_mcast': 512, 'repeated_load_phase': 4093, 'mcast_load_phase': 253, 'tile_words_per_receiver': 256}
{'input_NHWC': '[1,8,8,64]', 'bytes': 4096, 'period': 1, 'repeated_load_cycles': 62211, 'single_load_mcast_cycles': 54532, 'speedup': 1.1408164013790068, 'reduction_percent': 12.34347623410651, 'external_bytes_repeated': 65536, 'external_bytes_mcast': 4096, 'repeated_load_phase': 8192, 'mcast_load_phase': 512, 'tile_words_per_receiver': 2048}
{'input_NHWC': '[1,8,8,64]', 'bytes': 4096, 'period': 4, 'repeated_load_cycles': 86784, 'single_load_mcast_cycles': 56065, 'speedup': 1.5479175956479088, 'reduction_percent': 35.397077802359874, 'external_bytes_repeated': 65536, 'external_bytes_mcast': 4096, 'repeated_load_phase': 32765, 'mcast_load_phase': 2045, 'tile_words_per_receiver': 2048}
{'input_NHWC': '[1,8,8,256]', 'bytes': 16384, 'period': 1, 'repeated_load_cycles': 248835, 'single_load_mcast_cycles': 218116, 'speedup': 1.1408379027673348, 'reduction_percent': 12.345128297868069, 'external_bytes_repeated': 262144, 'external_bytes_mcast': 16384, 'repeated_load_phase': 32768, 'mcast_load_phase': 2048, 'tile_words_per_receiver': 8192}
{'input_NHWC': '[1,8,8,256]', 'bytes': 16384, 'period': 4, 'repeated_load_cycles': 347136, 'single_load_mcast_cycles': 224257, 'speedup': 1.5479383029292286, 'reduction_percent': 35.39794201696165, 'external_bytes_repeated': 262144, 'external_bytes_mcast': 16384, 'repeated_load_phase': 131069, 'mcast_load_phase': 8189, 'tile_words_per_receiver': 8192}
