jbpark0616/IDEC_Challenge/free_topic_vgg/evidence/raster_restore/REPORT_KO.txt

지정주제 raster generator 단일 코어 연결 — 1차 검증
================================================
범위: 단일 코어 시험용 분리 구현. 메인 RTL/16코어 클러스터 미변경.
verilog/winograd_sliding_window_generator.v 최종본을 모듈명만 변경해 사용.
원본 해시는 provenance.json. 지정주제 원본 파일 미변경.

경로
실제 activation_sram + SRAM macro -> HWC 순차 읽기(16바이트 작업 큐)
-> 패딩/3채널 픽셀 -> 지정주제 행 지연/가로 윈도 생성기
-> 64비트 타일 직렬화 -> 기존 vgg_sram_conv_layer(TILE_INPUT=1)
-> 기존 transform/V SRAM/row MAC/output.
비교 경로는 기존 vgg_activation_feed(TILE_STREAM=1)와 동일 SRAM/코어.
TB가 타일을 만들어 DUT에 주입하지 않음. tile_word는 비교 oracle로만 사용.

동일 입력 [1,4,4,3], 실제 source SRAM 초기 적재 제외, 코어 실행 cycles:
local K | sparse | 기존 | raster | source read 기존/raster
6       | OFF    | 627  | 599    | 18 / 6
6       | ON     | 586  | 549    | 18 / 6
128     | OFF    | 8013 | 7977   | 18 / 6
128     | ON     | 7497 | 7465   | 18 / 6

각 경로 OFF/ON 4회, 총 8회 PASS. 경로당 최종 출력 536개 64비트 word 일치.
각 실행 타일 스트림 24 word도 독립 HWC oracle와 일치.
V 마지막 재사용 후 release, backpressure, stale weight commit 거부 검증 포함.
가중치는 두 경우 모두 용량 내 상주. 메타데이터 전환/호스트 polling은 기존 TB 유지.

한계/미완료
3채널/4x4 입력의 연결 검증이며 VGG 깊은 레이어 일반화 완료가 아님.
원본 생성기는 3채널의 행 지연/윈도를 FF로 보관한다. 512채널로 확대하지 않음.
대규모 채널의 SRAM 행 저장, 처리 순서, V 수명을 맞춘 일반화는 아직 미구현.
전체 클러스터의 cycle/power/frequency 개선을 주장하지 않는다. 재합성 안 함.
본 수정은 verification/raster_restore에만 있으며 메인 sources.f에 편입하지 않음.

재현: WSL에서 free_topic_vgg를 cwd로 python3 verification/raster_restore/run.py
