jbpark0616/IDEC_Challenge/docs/report_data/figure_sources/free_topic/REPORT_SELECTION.txt

보고서 채택 상태
================
fig01_sparse_scaling: 사용자 요청으로 보고서에서 제외. 원본 증거와 파일은 보존.
fig02_sparse_response: 채택. 단일 코어 통제 실험의 희소도-사이클 관계.
fig03_vgg_layer_effect: 실제16코어 VGG Conv1/5/9/13 비교. 이미지1장, 독립 레이어 실행.

통제 실험과 실제 레이어 결과를 같은 성능 수치처럼 혼합하지 않는다.
현재 실제 레이어의 실행 사이클 절감은0~0.124%이며 MAC 절감과 구분해 제시한다.
