jbpark0616/IDEC_Challenge/submission/IDEC2026_FREE_TOPIC/03_evaluation/01_vgg_layers/results/REPORT_KO.md

# 레이어별 코어 활동 기반 PPA 비교

비교: Winograd + ICG (sparse OFF) / Winograd + ICG + sparsity-aware (sparse ON).
최종 합성 netlist에서 추출한 동일 계산 코어이며, 양쪽의 면적과 정적 Fmax는 같다.
U/V SRAM 8개 포함. 외부 activation SRAM 4개, 공급기, multicast, 나머지 코어 제외.
실제 VGG 이미지 한 장에서 추출한 레이어 입력/가중치, 로컬 출력 4채널만 평가.
전체 16코어 전력, 전체 VGG 처리시간 또는 이미지당 에너지로 해석하지 않는다.
초기 U 적재 제외; 명령 시작부터 완료 관측까지 측정. 실행 중 제어/대기 포함.
동일 1430ps 클록(699.300699MHz), 제로 지연 게이트 시뮬레이션. 배치·배선·SDF 미적용.
ASAP7 FF Liberty와 제공된 SRAM Liberty를 이용한 OpenROAD 전력 추정. 실측 전력이 아니다.
SRAM 모델의 전압/온도 조건은 표준셀과 다르며 기존 전체 합성과 같은 혼합 라이브러리 조건이다.

공통 Liberty 면적: 35958.28950 um²; 배치 전 Fmax: 725.89 MHz.

| 레이어 | 입력 NHWC | 전력 OFF→ON (mW) | 전력 감소 | 지연 OFF→ON (µs) | 구간 에너지 OFF→ON (nJ) | 에너지 감소 |
|---|---|---|---|---|---|---|
| Conv9 | [1,4,4,512] | 36.50921 → 36.30581 | 0.56% | 17.86213 → 14.09837 | 652.13229 → 511.85271 | 21.51% |
| Conv13 | [1,2,2,512] | 37.89423 → 37.64854 | 0.65% | 4.47161 → 4.37437 | 169.44822 → 164.68863 | 2.81% |

모든 완료된 OFF/ON 조건의 출력 word는 같은 독립 정수 기준값과 일치했다.
활동 주석 범위는 각 case의 activity.rpt, 원시 전력은 power.rpt, 파형 구간은 measurement.json 참조.
동적 모드 비교이므로 최적화 회로를 제거한 별도 구현 대비 면적 오버헤드를 측정한 실험이 아니다.
ICG는 양쪽에 유지하므로 이 결과로 ICG 자체의 절감률을 주장하지 않는다.
