jbpark0616/IDEC_Challenge/submission/IDEC2026_FREE_TOPIC/03_evaluation/02_controlled/results/REPORT_KO.md

# 공급 조건과 변환 영역 희소성에 따른 코어 에너지 평가

주 실험은 통제 입력이며 실제 VGG Conv9/Conv13 결과는 별도 적용 사례이다.
동일 최종 합성 코어, ICG ON 공통, runtime sparsity OFF/ON 비교. 면적 35,958.28950 um²와 정적 Fmax 725.89 MHz는 공통이다.
입력 [1,4,4,32], 출력 8채널, U8/V8. 가중치 4096 bytes 상주. 초기 U 적재 제외, 명령부터 완료까지 측정.
공급기는 64-bit 타일 데이터 word를 매 cycle, 4 cycles 또는 8 cycles마다 제공한다. 이는 최대 제공 빈도이며 실제 수락률은 ready에 영향을 받는다.
공간 입력에서 채널을 규칙적으로 0으로 설정해 변환 후 zero-row 0/25/50/75/100%를 생성했다. 비영 입력과 가중치 생성 규칙은 고정되어 있다. mask를 강제로 주입하지 않았다.
전체가 0인 채널 타일이 주기적으로 분포하는 통제 패턴이다. 같은 zero-row 비율의 모든 공간적/행별 분포를 대표하지 않는다. 실제 SRAM/제어 회로가 포함된 한 코어의 평가이며 외부 공급 회로 전력은 제외된다.
주기 1430ps(699.30MHz), zero-delay gate VCD 및 OpenROAD Liberty 전력 추정. SRAM/표준셀 라이브러리 조건과 활동 주석 범위는 VGG 예시 평가와 동일하다.
에너지=Pavg×측정 구간 시간. 이미지당 에너지 또는 전체 16코어 에너지가 아니다. 본 결과는 회로 제거 전후의 면적 비교가 아니다.

| 공급 | zero row | 사이클 OFF→ON | 사이클 감소 | 전력 OFF→ON (mW) | 에너지 OFF→ON (nJ) | 에너지 감소 |
|---|---:|---:|---:|---:|---:|---:|
| fast | 0% | 1273 → 1273 | 0.00% | 34.394 → 34.394 | 62.81 → 62.81 | -0.00% |
| fast | 25% | 1273 → 1025 | 19.48% | 35.307 → 34.557 | 64.47 → 50.85 | 21.13% |
| fast | 50% | 1273 → 773 | 39.28% | 36.271 → 34.792 | 66.24 → 38.66 | 41.64% |
| fast | 75% | 1273 → 515 | 59.54% | 35.231 → 35.041 | 64.34 → 25.91 | 59.73% |
| fast | 100% | 1273 → 431 | 66.14% | 34.050 → 32.144 | 62.18 → 19.90 | 67.99% |
| slow | 0% | 1433 → 1433 | 0.00% | 34.245 → 34.245 | 70.37 → 70.37 | -0.00% |
| slow | 25% | 1433 → 1236 | 13.75% | 35.056 → 34.287 | 72.04 → 60.65 | 15.81% |
| slow | 50% | 1433 → 1179 | 17.73% | 35.915 → 34.088 | 73.80 → 57.57 | 21.99% |
| slow | 75% | 1433 → 1123 | 21.63% | 34.992 → 33.567 | 71.91 → 54.00 | 24.90% |
| slow | 100% | 1433 → 1063 | 25.82% | 33.942 → 32.179 | 69.75 → 49.01 | 29.74% |
| supply8 | 0% | 2312 → 2312 | 0.00% | 33.677 → 33.677 | 111.39 → 111.39 | -0.00% |
| supply8 | 25% | 2312 → 2256 | 2.42% | 34.182 → 33.464 | 113.06 → 108.01 | 4.47% |
| supply8 | 50% | 2312 → 2199 | 4.89% | 34.719 → 33.232 | 114.84 → 104.60 | 8.92% |
| supply8 | 75% | 2312 → 2143 | 7.31% | 34.144 → 32.924 | 112.94 → 100.99 | 10.58% |
| supply8 | 100% | 2312 → 2083 | 9.90% | 33.505 → 32.177 | 110.82 → 95.94 | 13.43% |
