jbpark0616/IDEC_Challenge/docs/figures/lifetime_storage.pptx

to sliding-window generator (40-vector prefill)

Conv1

Stored Conv1 features (104 × 24-bit)

read: addr 0 → 103

time

Conv2

Conv2 features (25 × 24-bit)

overwrite: addr 0 → 24

consumed / free

Same physical 104 × 24-bit FF scratchpad

FC read: 3 channel passes

FC

FC input (25 × 24-bit)

free

0

24

25

(b) Lifetime-aware activation storage

103
