jbpark0616/IDEC_Challenge/docs/figures/winograd_figures.pptx

Weight / parameter interface (external)

Winograd CNN Accelerator

Layer FSM /

controller

control / ready–valid

Operation-fused Winograd Core

Input transform

add / sub butterfly

read (Conv2)

U / FC weight · INT4

bias / requant param

Sliding-window generator

pixel

UINT8

line buffer ×3

4×4 window

16-lane MAC / reduction array

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
Conv: lane 0–15 · FC: lane 0–9 active, 10–15 gated

INT18

Output transform

add / sub butterfly

Fused postprocess

bias add

ReLU

max-pool

requant → UINT8

FC result

Tile FIFO

D=2

V-replay FIFO

D=2

M FIFO

D=1

FC mode

store

Activation scratchpad

104 × 24-bit FF register array

Pipelined Argmax

10-class

decision · 4b

addr 0

addr 103

## Slide 2

Winograd CNN Accelerator

## Slide 3

Conv1

prefill + store

104 × 24-bit FF scratchpad

40 vec → Sliding-window generator (prefill, not stored)

overwrite ←

Conv1 activations (addr 0–103)

sequential read →

consumed (freed)

time

Conv2

read + overwrite

Conv2 output (packed 3ch→24b)

FC

packed read

packed read →

packed Conv2 features

free

0

addr 0–24

25

addr 25–103

(b) Lifetime-aware activation storage

103

## Slide 4
