jbpark0616/IDEC_Challenge/docs/report_assets/free_topic/figures/vgg_controlled_cycle_energy_extended.pdf

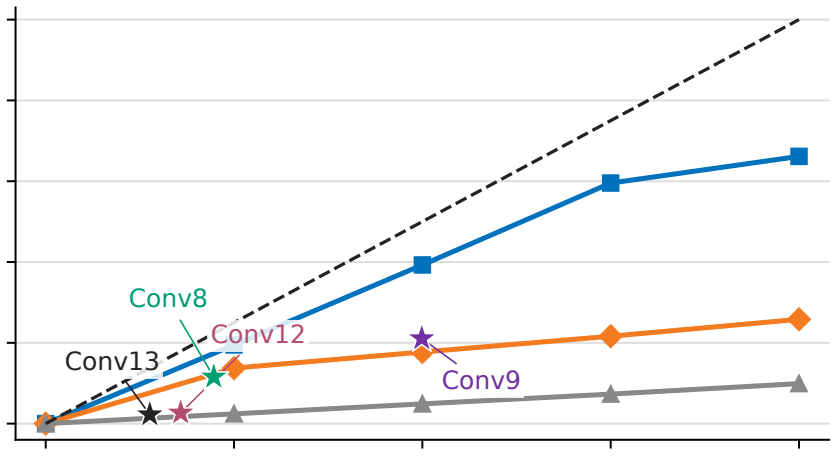
[picture p148: figure]
Conv9; Conv13; Conv8; Conv12

0 | 25 | 50 | 75 | 100

## Zero rows after input transform (%)

0

20

40

60

80

100

### Reduction (%)

## (a) Cycle reduction

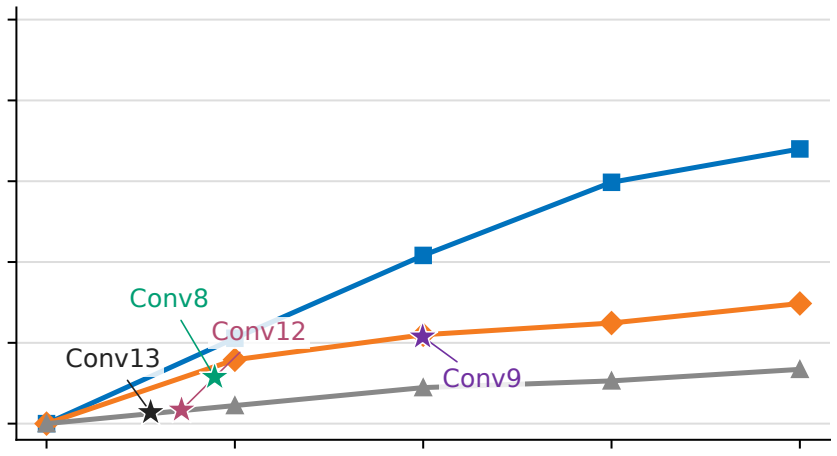
[picture p149: figure]
Conv9; Conv13; Conv8; Conv12

0 | 25 | 50 | 75 | 100

## Zero rows after input transform (%)

0

20

40

60

80

100

### Reduction (%)

## (b) Energy reduction

Controlled: 4×4×32 input, 8 output channels. VGG stars: one-image layer slices, 256 or 512 input / 4 output channels. All weights resident; stars are application examples with different tensor shapes, not samples of the controlled curves.
