jbpark0616/IDEC_Challenge/docs/자유주제 결과보고서 표지.pdf

## 결 과 보 고 서

과제명: A Multicore Extension of the Sparsity-Aware Winograd CNN Accelerator

팀 | 명: | SKKAF

경북대학교 IDEC 2026 창의 회로설계 챌린지

1. 과제 개요
2. 설계 목표
3. 설계 및 시뮬레이션

( ) 1. 예 구상도 및 알고리즘 설계
2. OOO 구동회로 설계
3. OOO 회로 동작 원리
4. OOO 시뮬레이션 및 결과 분석
4. 결과 및 기대효과
