jbpark0616/IDEC_Challenge/docs/수상작/경북대IDEC2025창의회로설계챌린지_결과보고서_드가자_ Clock Gating과 Zero Skipping을 적용한 CNN가속기 설계.pdf

# 결 과 보 고 서

# 과제명: Clock Gating과 Zero Skipping을 적용한 CNN

# 가속기 설계

팀 | 명: | 드가자

# 경북대학교 IDEC 2025 창의 회로설계 챌린지

설계 목표 | 경북대학교 IDEC 2025 창의 회로설계 챌린지

### 1. 과제 개요

인공지능(AI) 기술, 특히 딥러닝의 급속한 발전은 산업 전반에 걸쳐 전례 없는 변화를 주도하고 있다. 이러한 기술 진보는 모델의 복잡성과 연산량의 폭발적인 증가를 동반하며, AI 연산을 처리하는 하드웨

어의 패러다임 변화를 요구한다. 현재 AI 하드웨어는 학습(Training)과 추론(Inference) 단계의 고유한 특성에 따라 분화되는 뚜렷한 경향을 보인다. 학습 단계는 GPU가 지배적이지만, 학습된 모델을 실제 서 비스에 배포하는 추론 단계에서는 특정 작업에 최적화된 전용 가속기(Accelerator)로의 전환이 가속화 되고 있다. 특히 전력과 연산 자원이 제한된 edge device 환경에서는 이러한 고효율 저전력 가속기의 필요성이 더욱 절실하다. 이에 본 연구는 edge device에 최적화된 고성능 저전력 CNN 하드웨어 가속기 를 설계하는 것을 최종 목표로 한다. 본 문서는 이 목표 달성을 위한 설계 과정을 체계적으로 기술한 다. 2장에서는 edge 환경의 요구사항을 반영한 구체적인 '설계 목표'를 정의한다. 3장에서는 연산 정밀 도 최적화, 파이프라이닝 전략 등 핵심 아이디어를 포함한 '설계 및 시뮬레이션' 과정을 상세히 설명한 다. 마지막 4장에서는 시뮬레이션 '결과 및 기대효과'를 논의하며 결론을 맺는다. 2. 설계 목표

## 2.1. Baseline Improvement

Baseline hardware 분석 후 두 가지 특징에 주목하였는데, 첫째는 ‘module 별 전력 소모’, 그리고 ‘module 별 유효 데이터 처리 시간’이다.

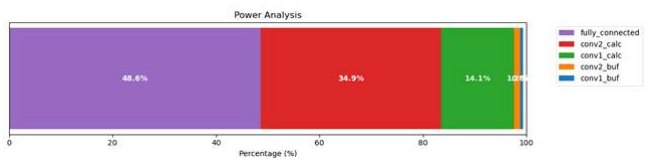
[picture p177: figure]

Fig 1. Power estimation of each module

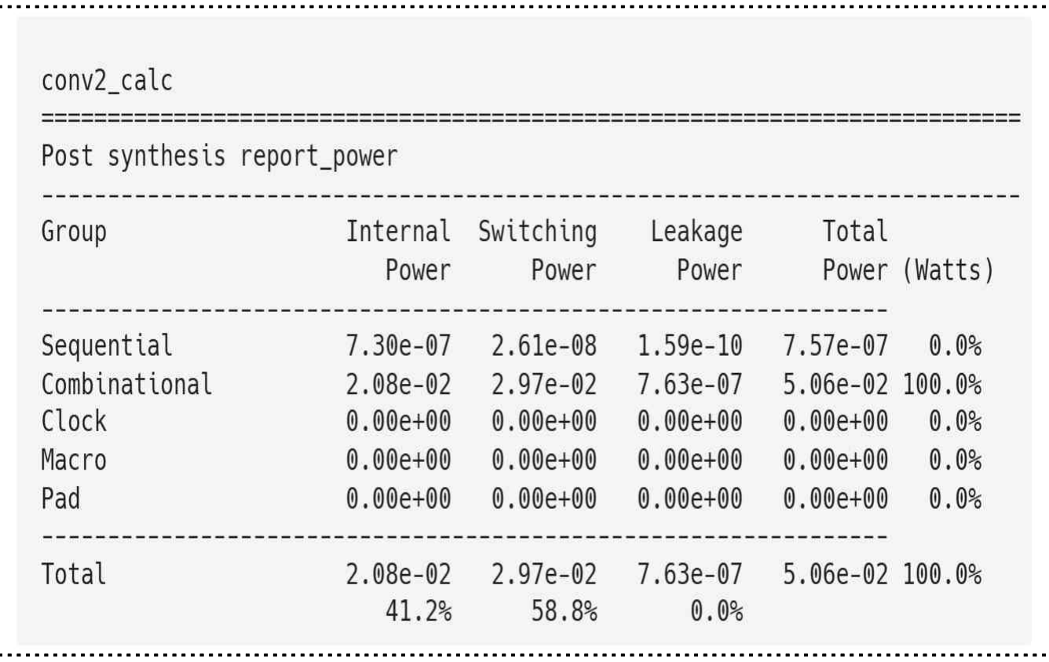
[picture p178: figure]
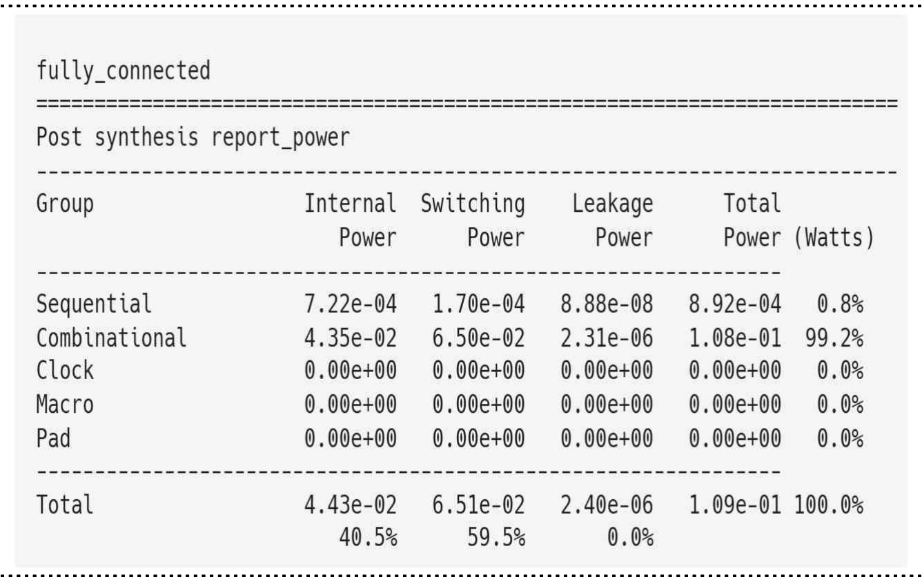
[picture p179: figure]

Fig 2. Detail power analysis of conv2_calc, fully_connected modules

Fig 1. 은 OpenROAD Tool 활용하여 baseline chip에서 module별 전력 소모를 분석한 결과이다. 측정 결 과 conv2_calc, fully_connected 두 개의 특정 module에서 전력 소모 대부분을 차지하고 있는 것을 파 악하였다. 특히 Fig 2.를 통해 두 module 내에서 convolution, matrix multiplication을 수행하기 위한 combinational logic의 switching power가 상당한 전력 소모를 유발한다는 것도 확인할 수 있다.

설계 목표 | 경북대학교 IDEC 2025 창의 회로설계 챌린지

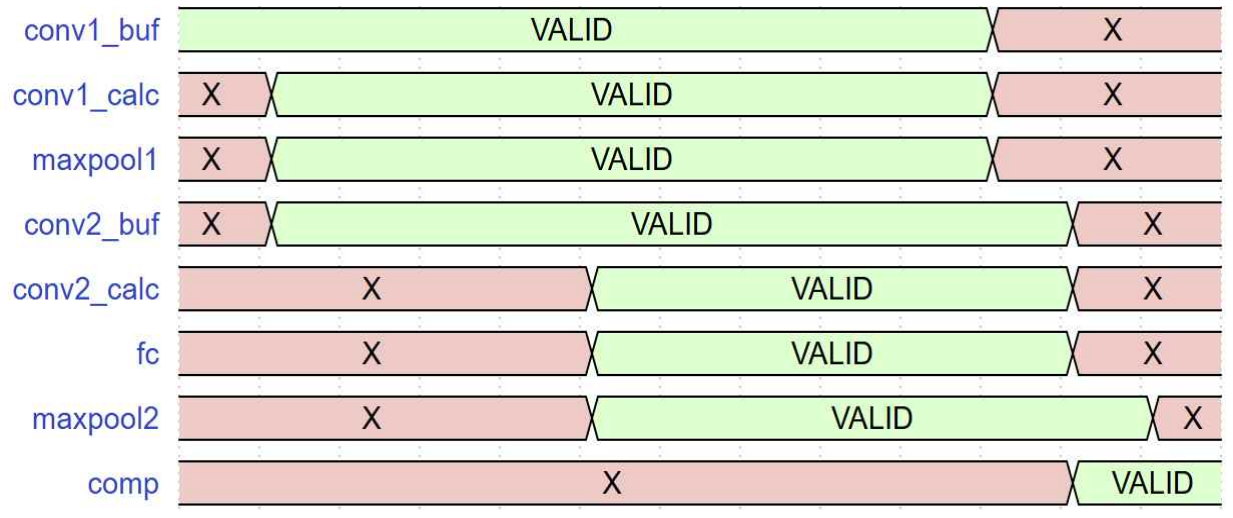
[picture p180: figure]

Fig 3. Processing time of each module for valid data

Fig 3.은 baseline chip 내부 module별로 유효한 데이터를 처리하는 시간을 분석한 결과이다. 첫 번째 layer에서 feature map의 크기가 더 크기 때문에 주로 valid data를 처리하는 시간이 첫 번째 layer module에서 집중 되어있는 것을 확인할 수 있다. 위 두 가지 특징을 종합하면, 현재의 baseline chip 구조는 유효한 데이터를 처리하는 시간이 적은 부

분에서 대부분의 전력 소모가 집중 되어있는 구조임을 알 수 있다. 따라서 본 과제에서는 ‘clock gating 기법’을 도입하여 유효한 데이터를 처리하는 시간에만 module이 동작할 수 있도록 설계하여 전

## 력 소모를 절감하고자 한다. 2.2 Proposed Design

본 과제는 CNN 가속기의 PPA 개선을 목표로 clock gating과 더불어, 목표 Task인 CNN의 연산 특성 분석 에 기반하여, hardware 및 software 최적화 기법을 통합 적용한 새로운 아키텍처를 제안한다.

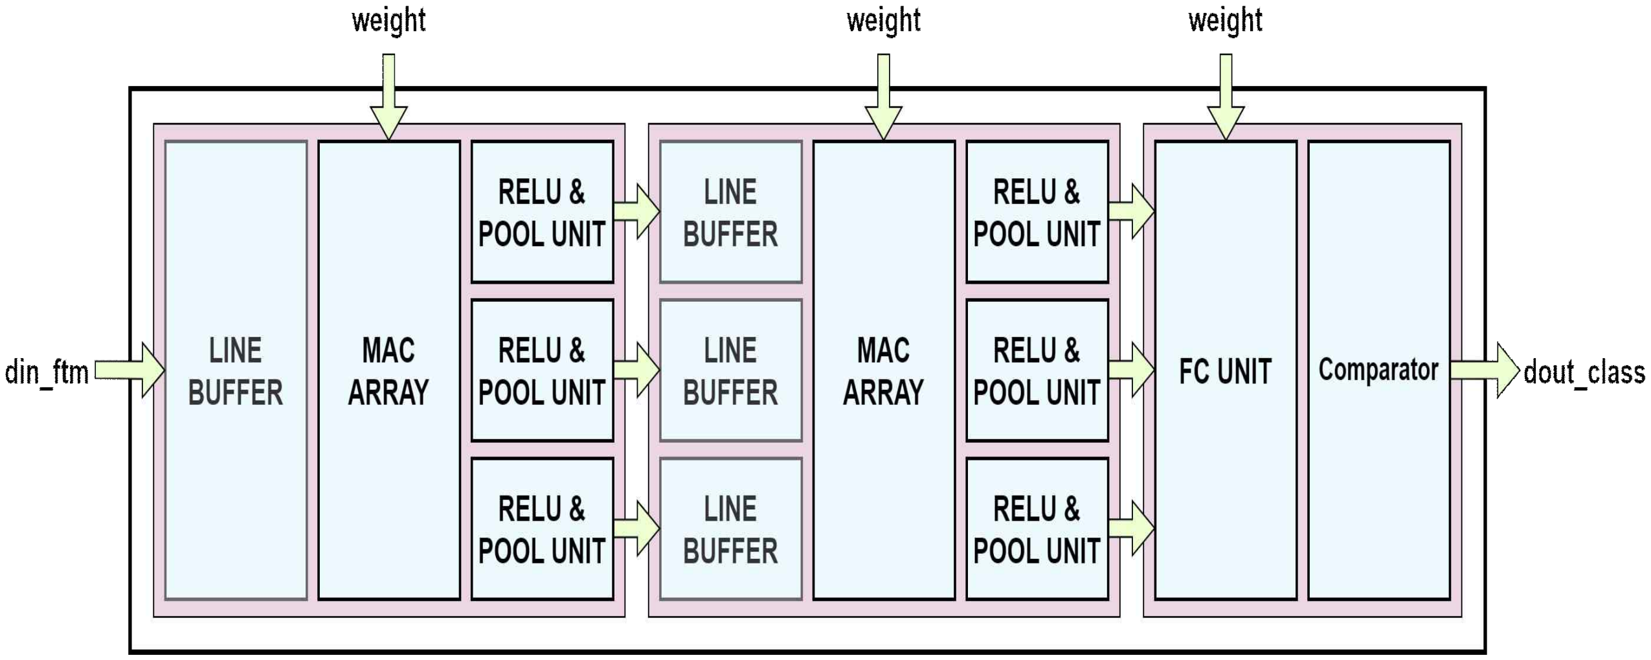
[picture p181: figure]

Fig 4. Top architecture of proposed CNN accelerator

Fig 4.에 본 과제에서 제안하는 CNN 가속기의 전체 구조를 나타내었다. 전체적인 구조는 기존 baseline hardware와 유사한 형태이지만 세부적으로 아래와 같은 개선점을 제시한다.

1. Improved Line Buffer

설계 및 시뮬레이션 | 경북대 IDEC 2025 창의 회로설계 챌린지

목표 Task인 CNN의 convolution 연산의 특징에 맞춰 line buffer를 재설계 하였다.
2. Reducing I/O Ports
weight 데이터의 입출력 port를 간소화하였다.
3. Feature Map Shifting MAC
Feature map shifting을 활용하여 MAC Unit 내부에서 데이터 재사용을 증가시켰다.
4. Pseudo Zero Skipping
MAC Unit 내부에서 pseudo zero skipping을 도입하여 zero 데이터 연산에 대한 불필요한 switching 을 최소화하였다.
5. Model Re-design with Bit Precision Scaling
CNN 모델의 성능과 정확도를 개선하고, 양자화(quantization)을 적용하여 hardware cost를 감소시켰 다. 3. 설계 및 시뮬레이션

## 3.1. Baseline Improvement

3.1.1 Clock Gating Method

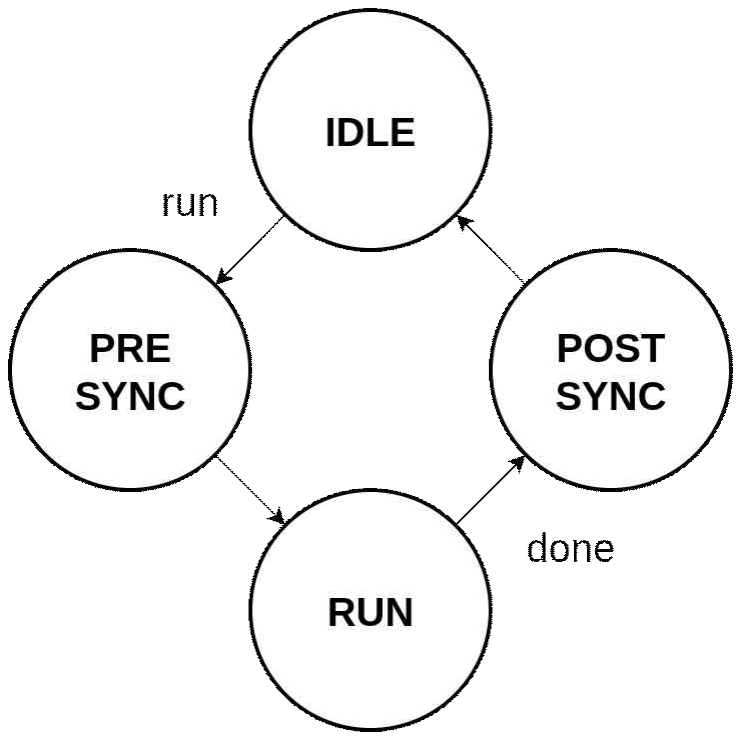
[picture p182: figure]
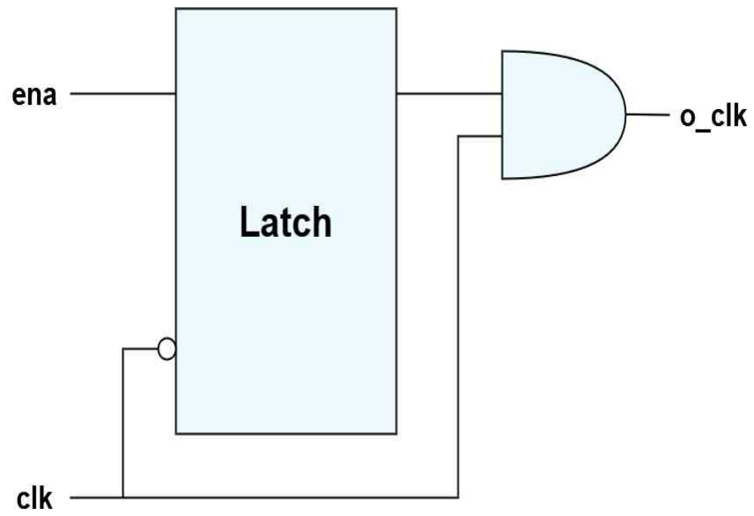
[picture p183: figure]

(a) (b)

Fig 5. Architecture of an ICG Cell and state transition diagram for clock gating

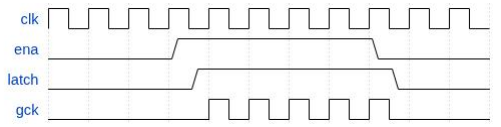
[picture p184: figure]

Fig 6. Timing Diagram of ICG Cell

Fig 5 (a). 은 Clock Gating에 사용되는 Latch-based Integrated Clock Gating Cell의 구조이다. Positive edge가 아닌 구간에서 transition으로 인한 glitch 발생을 방지하기 위해 Enable signal을 negative latch의 input으로 연결하고, latch의 output을 clock과 AND gate로 연결하여 gated clock을 생성한다. Fig 6.은 IGC Cell의 동작에 대한 timing diagram 이다. Negative latch는 clock이 low일 때 transparent mode로 작동하여, enable signal이 인가된 다음 cycle부터 gated clock이 작동하기 시작한

다. Fig 5 (b). 은 clock gating을 적용하기 위한 FSM의 state diagram이다. 외부에서 인가되는 run 신 호를 통해 hardware는 IDLE state에서 벗어나 동작을 수행한다. Gated clock은 IDLE state가 아닐 때 동작 해야하기 때문에 아래와 같은 조건으로 enable signal을 생성할 수 있다. _

필요한 동작을 모두 수행한 hardware는 다시 IDLE state로 돌아가며 gated clock을 off 시킨다. 이때, system의 안정성과 초기화 작업 등을 고려하여 RUN state 전후로 PRE_SYNC, POST_SYNC state를

추가하였다.

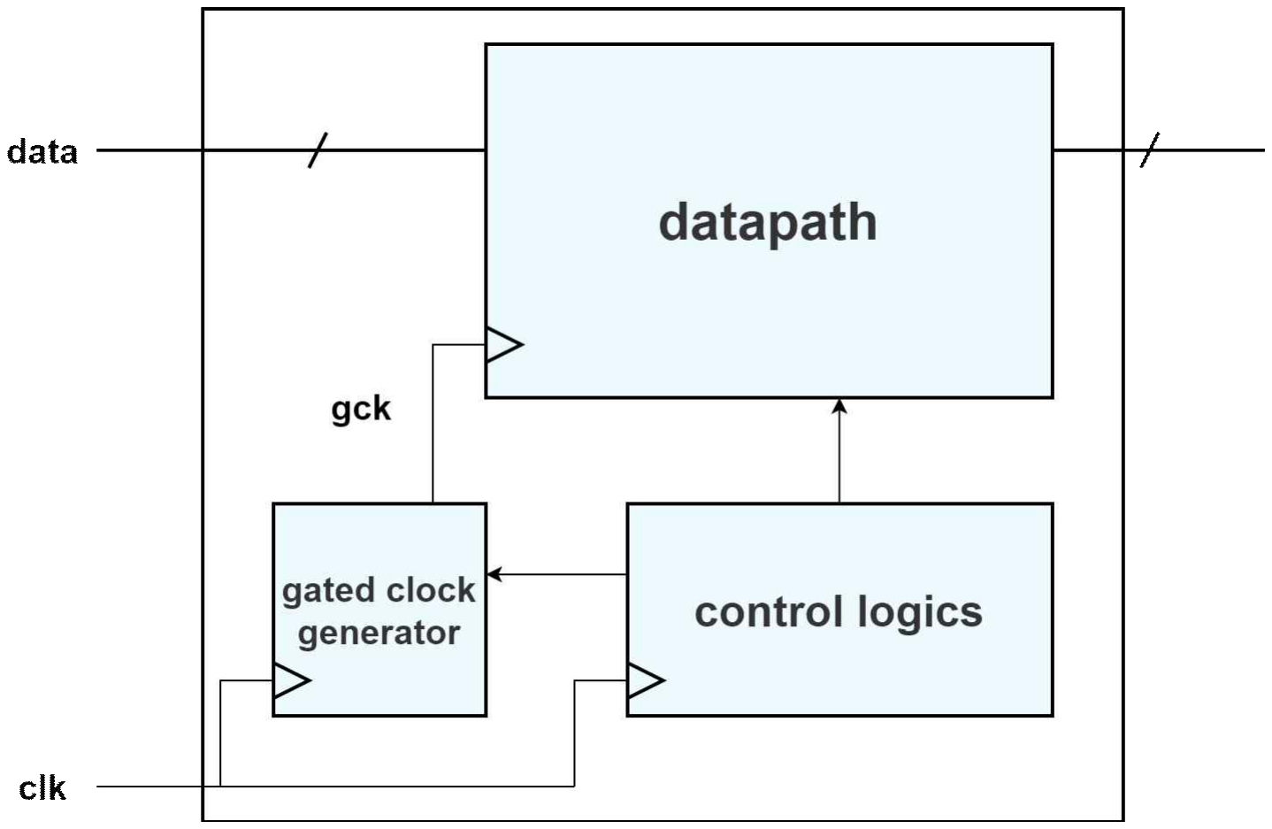
[picture p185: figure]
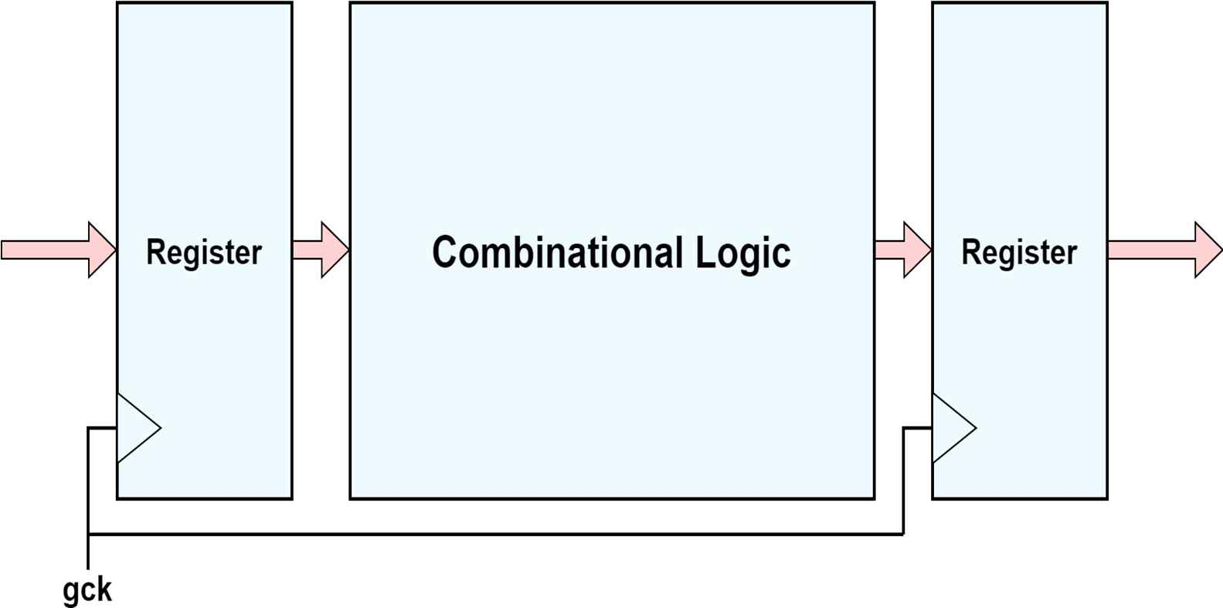
[picture p186: figure]

(a) (b)

Fig 7. System architecture with clock gating logic

Hardware Module은 Fig 7 (a).와 같은 구조로 구현되었다. Module의 control을 담당하는 control logic은 gated clock을 인가하지 않고 기존 clock에 연결하였다. control logic은 datapath와 달리 내부 register를 초기화하는 작업이 필요한데, 본 과제에서 사용하는 asap7 process에서는 asynchronous reset을 지원하지 않아 control logic은 gated clock을 인가할 수 없었다.

Control logic은 외부에서 인가되는 run signal에 의해 FSM이 작동한다. RUN state에서는 control logic이 enable signal을 high로 인가하여 gated clock을 생성하여 datapath에 인가한다. datapath는 Fig 7 (b).와 같이 gated clock이 인가된 register 사이에 combinational path가 존재하며, gated clock이 동작할 때만 data transfer가 발생하며 IDLE state에서는 data transfer가 차단되어 내부적으로 switching이 발생하지 않는다.

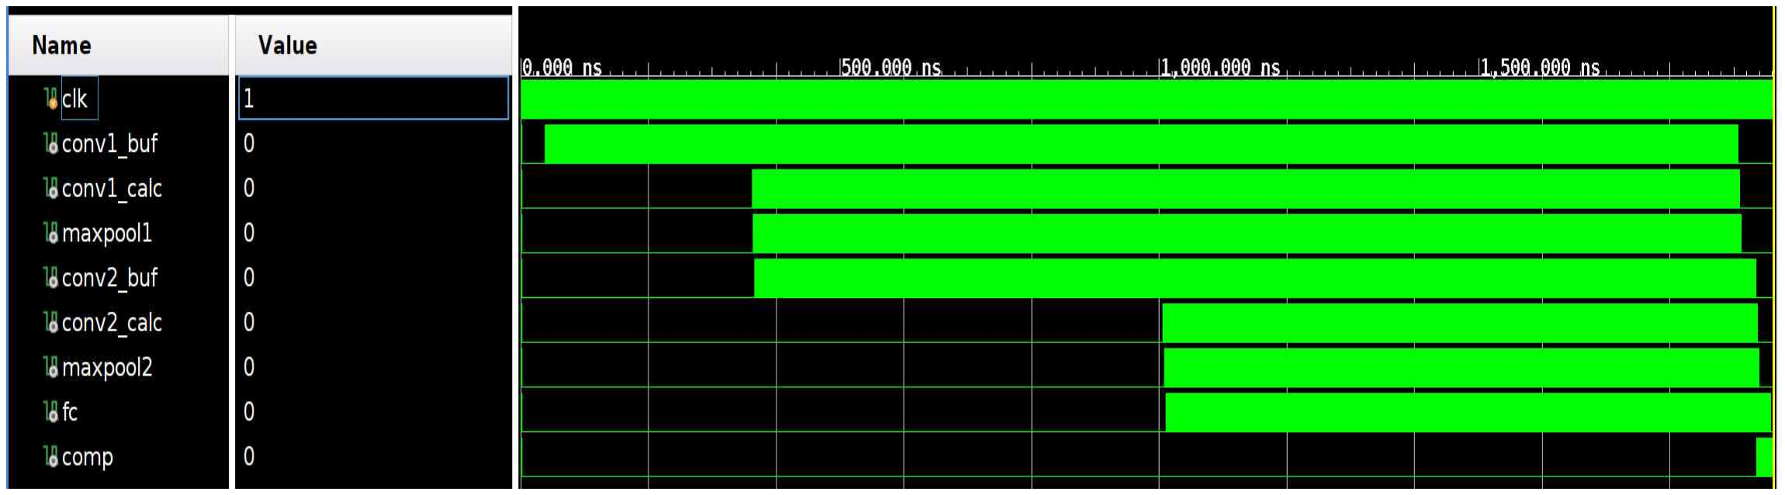
[picture p187: figure]

Fig 8. Operating time analysis of gated clock’s of each modules

Fig 8.은 clock gating을 적용한 baseline hardware가 이미지 1개를 처리하는 동안의 module 별 gated clock의 waveform을 나타낸 것이다. 전체적인 waveform 이 Fig .와 유사한 형태를 보이고 있으며,전력 소모가 많이 발생하는 conv2_calc, fc module은 전체 유효 데이터 처리 시간 중 약 40% 정도의 시간 동

안만 동작하는 것을 확인할 수 있다. 3.1.2 Power Estimation with OpenSTA

OpenROAD synthesis tool의 post-synthesis power report에는 clock gating에 의한 전력 소모 변화를 정확하게 측정할 수 없다. 임의의 로직에 대한 동적 전력 소모는 아래의 식으로 계산된다.

여기서 는 switching activity를 의미하며, logic의 output이 toggling 하는 비율을 의미한다. 디지

털 회로의 전력 소모는 switching activity에 의해 크게 좌우되며, clock gating 기법은 switching activity를 감소시켜 동적 전력 소모를 절감한다. 하지만 synthesis 단계에서 전력을 측정할시, switching acitivity 값을 특정 상수로 고정하여 (e.g. 0.1) 전력을 측정하기 때문에 clock gating의 영향이 제대로 반영되지 않는다. 이에 본 과제에서는 OpenROAD에서 추가로 제공하는 OpenSTA tool을 이 용하여 chip의 전력 소모를 측정하였다. OpenSTA tool을 활용한 전력 측정 방법은 아래와 같이 진행된 다.

1. OpenROAD synthesis tool을 이용하여 회로 합성
2. Vivado Simulator를 이용하여 post synthesis simulation을 수행
3. simulation을 통해 측정된 파형 변화 기록 파일 (e.g .vcd, .saif) 추출
4. OpenSTA tool에서 파형 변화 기록 파일을 적용하여 전력 소모 측정

3.1.3 Post Synthesis Simulation Scenario

정확한 전력 소모를 측정하기 위해서는 실제 chip의 동작과 유사한 환경으로 시뮬레이션을 진행하여 파 형 변화를 측정해야 한다. 실제 hardware에서는 chip의 I/O port가 interconnect나 다른 module에 물리 적으로 연결되어 있고, port를 사용하지 않을 때도 임의의 데이터가 chip으로 주입되거나 외부로 전송 될 것이다. 따라서 본 과제에서는 control signal을 제외한 input port는 임의의 데이터가 항상 인가되 고 있는 상황을 가정하고 시뮬레이션을 진행하였다. 예를 들어 feature map data input port는 이미지 처리 동작 중에는 feature map data를 인가하고, 그렇지 않은 경우, random data가 인가되는 방식으로 처리하였다. 3.1.4 Result of the Power Estimation

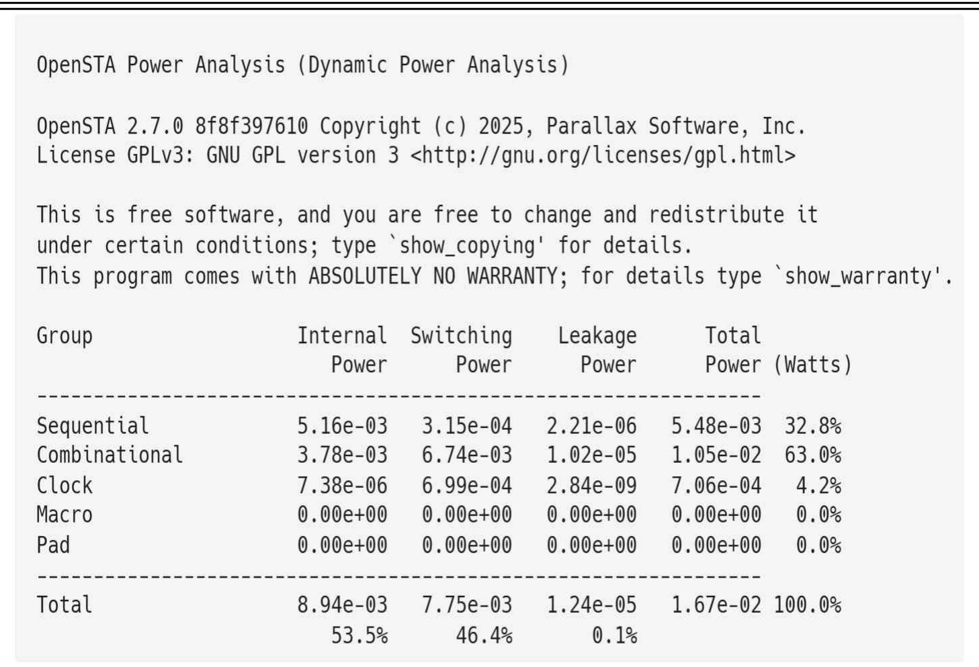
[picture p188: figure]
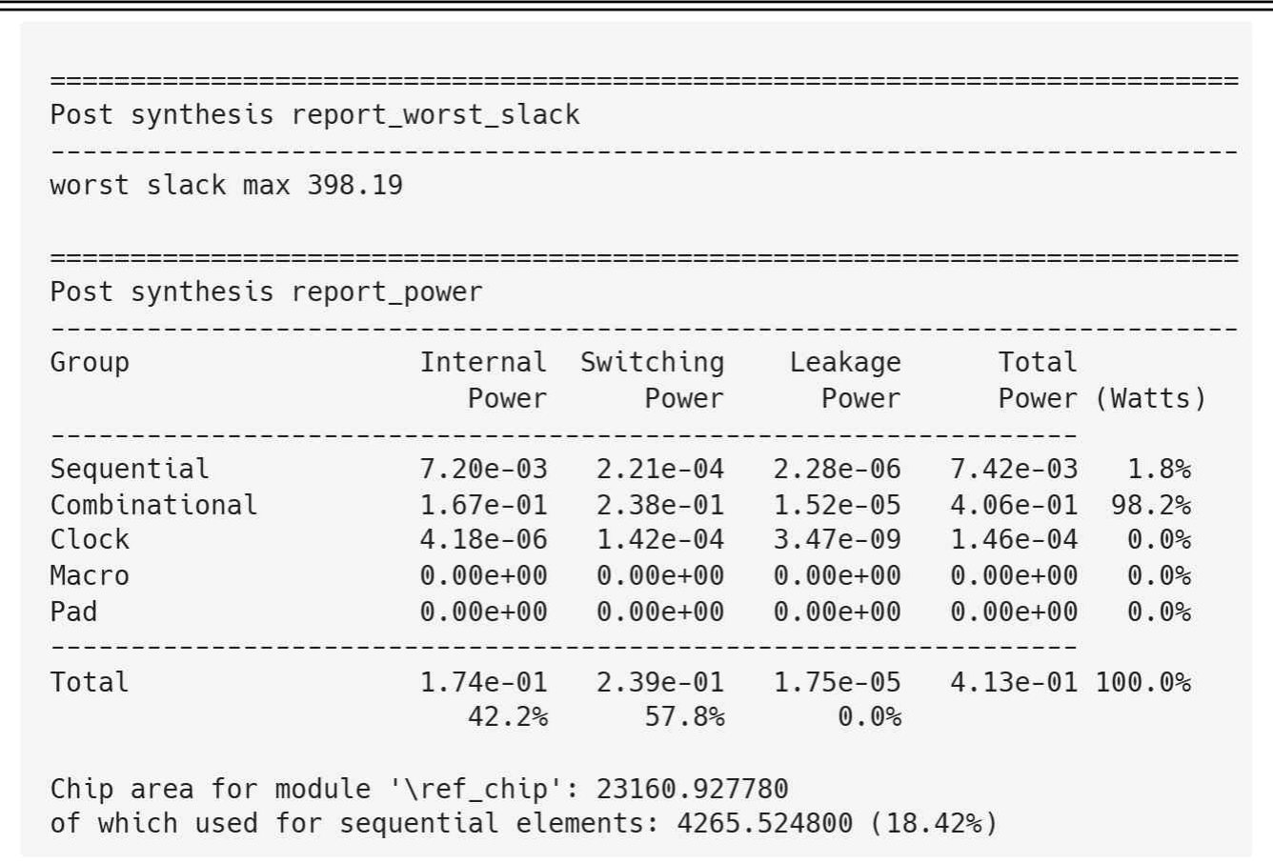
[picture p189: figure]

(a) (b)

Fig 9. Power estimation of improved hardware

class | baseline | improved (post-synthesis) | improved(OpenSTA)
power | 331 mW | 413 mW | 16.7 mW
power / baseline | 1 | 1.25 | 0.05

Fig 9.은 OpenROAD synthesis tool에서 측정한 post synthesis power report와 OpenSTA tool로 측정한 power report이다. post-synthesis power report에서는 clock gating의 영향이 제대로 반영되지 않고, 오히려 logic이 추가 되었기 때문에 baseline hardware보다 전력 소모가 높게 측정되었다. 하지만

OpenSTA tool에서는 clock gating의 영향을 반영하여 전력 소모가 감소된 것을 확인 할 수 있다. 3.2. Proposed Design

3.2.1 Line Buffer

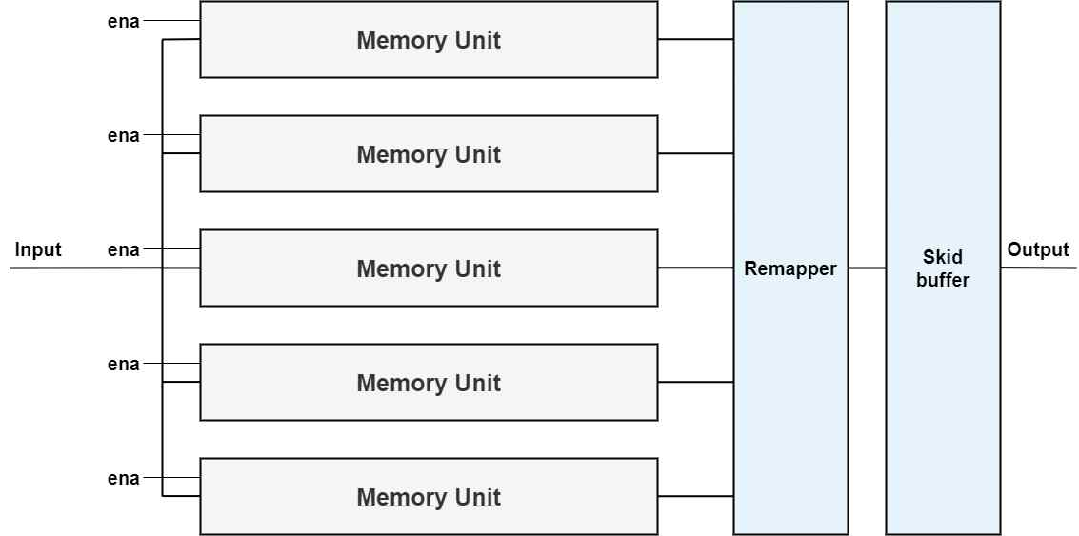
[picture p190: figure]
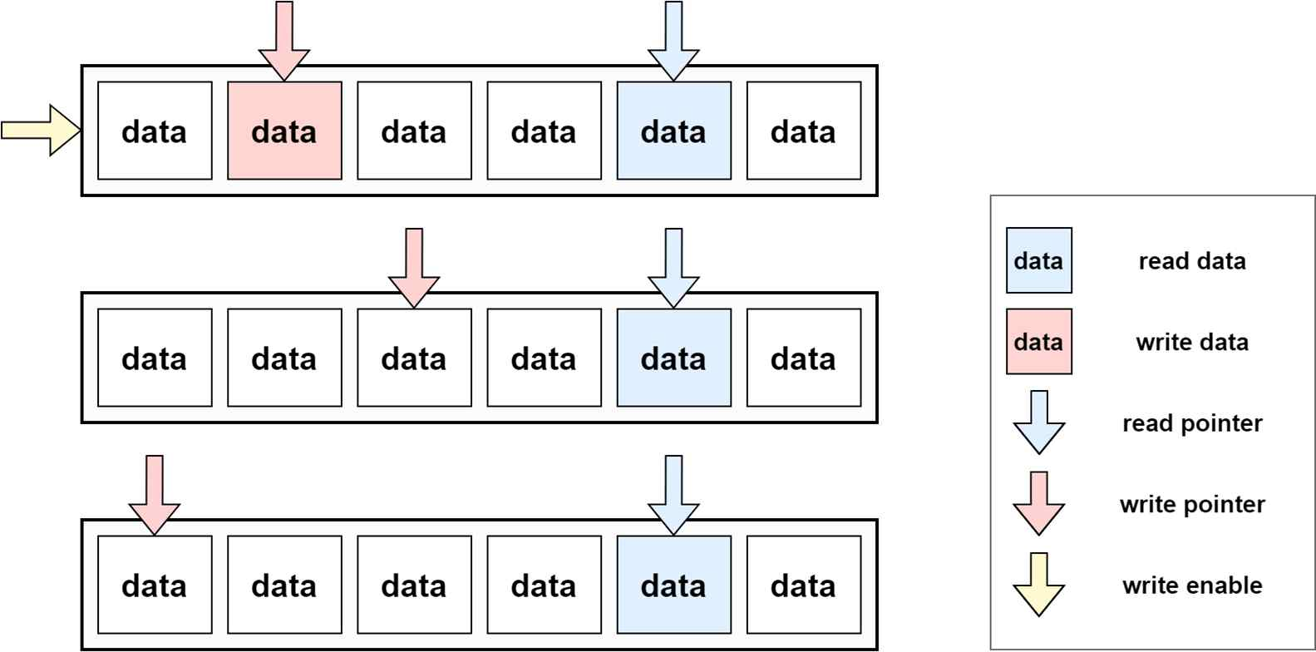
[picture p191: figure]

(a) (b)

Fig 10. Architecture of proposed line buffer and operation flow

Fig 10 (a). 은 본 과제에서 제안하는 Line Buffer의 구조이다. CNN Layer의 kernal size에 맞게 5 개 의 memory unit이 병렬로 배치되었고, 각각 layer에 맞는 feature map 크기의 depth를 가진다. Fig 10 (b).는 line buffer의 동작 방식을 나타낸 것이다. 화살표는 memory unit에서 포인터가 가리키는 현재 위치를 의미한다. 각각의 line buffer는 read pointer, write pointer에 의해 입출력이 제어된다. read pointer의 경우 동일한 column의 feature map 데이터를 출력해야 하기 때문에 모든 memory unit이 동일 한 주소를 가리킨다. write 동작은 하나의 feature map 데이터가 입력으로 들어오면 write enable이 인
가된 memory unit의 write pointer 위치에 입력 데이터를 저장한다. Characteristic | Baseline | Proposed
Architecture | 140 x 1 | 28 x 5
Total memory size | 140 B | 140 B
Input data port | 1 | 1
Output data port | 25 | 5
Read logic MUX | # 25 of 140to1 MUX | # 5 of 28to1 MUX

Table 1. comparison of line buffer of layer 1

Table 1.에 baseline hardware의 line buffer와 본 과제에서 제안한 line buffer의 특징을 비교했다. 가장 큰 차이점은 output data port의 개수이다. convolution 연산은 인접 index의 output을 계산하는

데 많은 feature map data를 중복하여 사용한다. 5x5 kernal을 사용하는 경우, 현재 index에서 사용된 feature map data 중 80% (20/25)가 다음 column index의 convolution 연산에 사용된다. systolic array와 같은 구조에서 적용하는 feature map shifting을 적용하면 5개의 output port만 사용해도 충분 한 bandwidth를 유지할 수 있다.

따라서 제안하는 line buffer는 5개의 memory unit에 데이터를 저장하고, 각각 하나의 data만 출력하여 read path의 logic을 간소화하였다. baseline hardware에서 제시한 순환방식의 데이터 출력은 barrel shifter를 활용한 remapper unit을 추가하여 동작을 유지하였다. 다만, 이 과정에서 데이터를 출력하는 데 한 cycle이 추가로 필요한데, 이로 인해 발생할 수 있는 hardware interface 간 동기화 문제를 방지 하기 위해 skid buffer를 추가했다. 3.2.2 Reducing I/O Port

Data port | Baseline (Byte) | Proposed (Byte) | Reduced width | Required Cycle
L1 kernal | 75 (25x3) | 5 | 93.33 % | 15
L1 bias | 3 | 1 | 66.67 % | 4
L2 kernal | 225 (25x3x3) | 5 | 97.78 % | 45
L2 bias | 3 | 1 | 66.67 % | 3
FC kernal | 480 (48x10) | 3 | 99.38 % | 160
FC bias | 10 | 1 | 90.00 % | 10

Table 2. Comparison of data width for parameter data port

본 과제에서는 병렬적으로 모든 파라미터 데이터를 입력받는 대신 순차적으로 파라미터 데이터를 입력 받아 chip 내부에 저장하는 방식을 도입하였다. Baseline hardware와 같이 상당수의 I/O port를 사용하 는 경우, chip의 면적이 비약적으로 증가한다. 따라서 본 과제에서는 I/O port의 수를 줄여 chip의 면 적을 감소시켰다. 순차적으로 데이터를 입력받는 경우, feature map 데이터가 module에 도달하기 전까 지 loading이 완료되어야 하는데, 첫 번째 layer의 line buffer에서 처음 buffer를 채우는데 140 cycle 이 필요하기 때문에 parameter 데이터를 load 하는데 충분한 시간이 보장된다. 3.2.3 Feature Map Shifting MAC

CNN, Transformer와 같은 Deep Learning Model은 다수의 행렬 연산을 수행하며, AI 가속기는 행렬 연산 을 최적화하여 수행하는 것을 목표로 발전해왔다. Systolic Array는 대표적인 AI 가속기 구조 중 하나 로, 행렬 곱 연산에 특화 되어있다. 하지만 systolic array는 NxN 행렬 곱 수행 시, 총 3N-1 사이클 중 2N-1 사이클을 파이프라인 데이터 입출력 소모하는 오버헤드를 본질적으로 가진다. 이러한 오버헤드는 대규모의 연속적인 데이터 스트림이 입력되어야만 상쇄될 수 있는데, 본 과제의 목표인 28x28 크기 이 미지 처리는 충분히 큰 데이터 스트림을 생성하기 어려워, 유효 연산 시간보다 입출력 오버헤드가 더 지배적이게 된다. 이는 심각한 자원 활용률 저하로 이어지므로, 본 과제 설계에 부적합하다고 판단했 다. 이와 같은 이유로 2D systolic array의 장점인 데이터 재사용성은 유지하면서 목표 task에 더 적합 한 1D-like Feature map shifting 구조를 도입하였다.

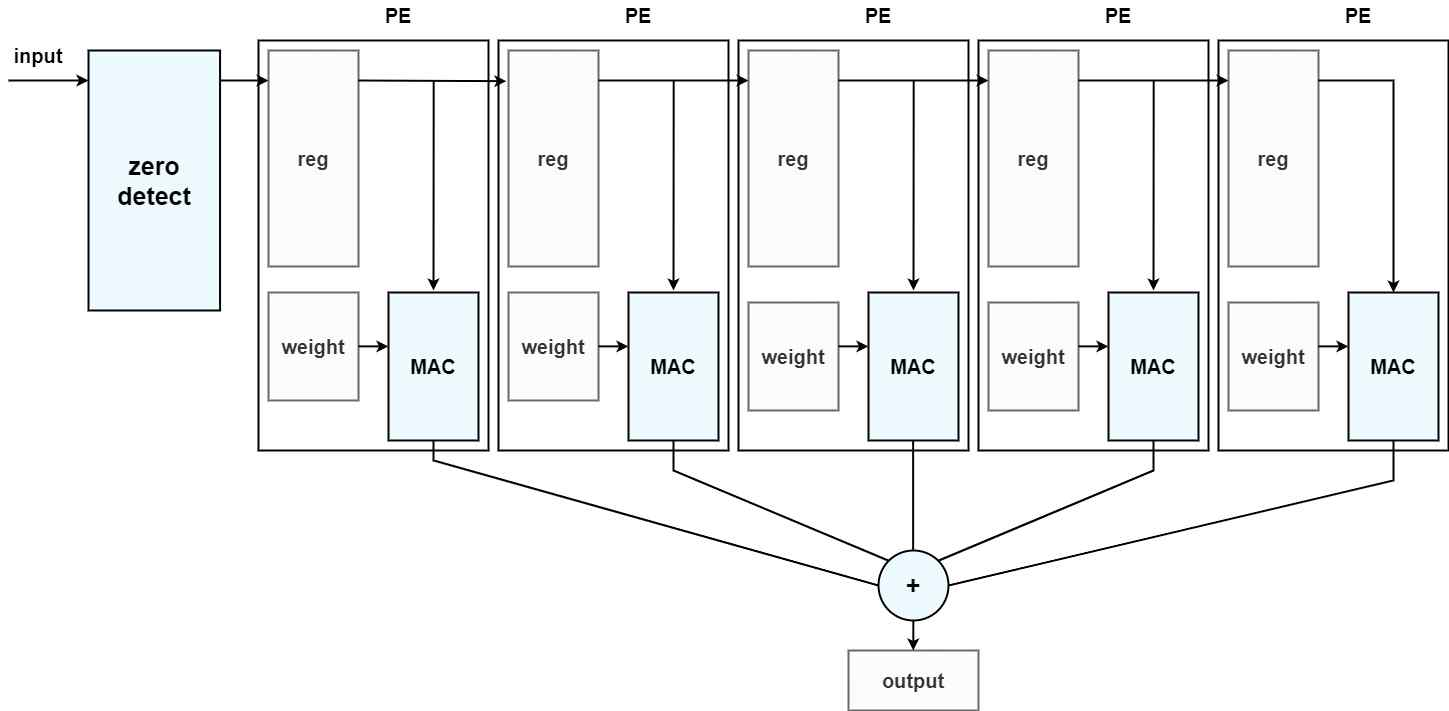
[picture p192: figure]
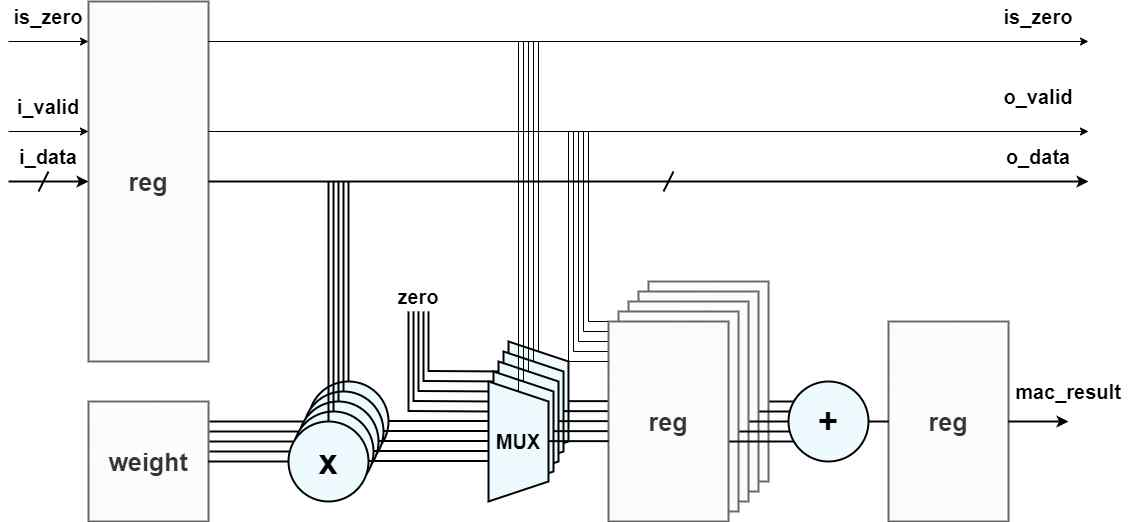
[picture p193: figure]

(a) (b)

Fig 11. Architecture of the proposed design Processing Element array (PE) and MAC unit

Fig 11.는 본 과제에서 제안하는 PE array와 MAC unit의 구조를 나타낸 것이다. PE 5개가 모여 PE Array를 이루고, 5x5 크기의 feature map과 kernal에 대한 convolution을 수행한다. 이때, PE array의 입력 데이터는 5x1의 1 column vector 형태로 입력된다. 입력 데이터는 zero detect unit (3.2.4에서 후술)를 거쳐 vector 단위로 다음 PE로 shifting 된다.

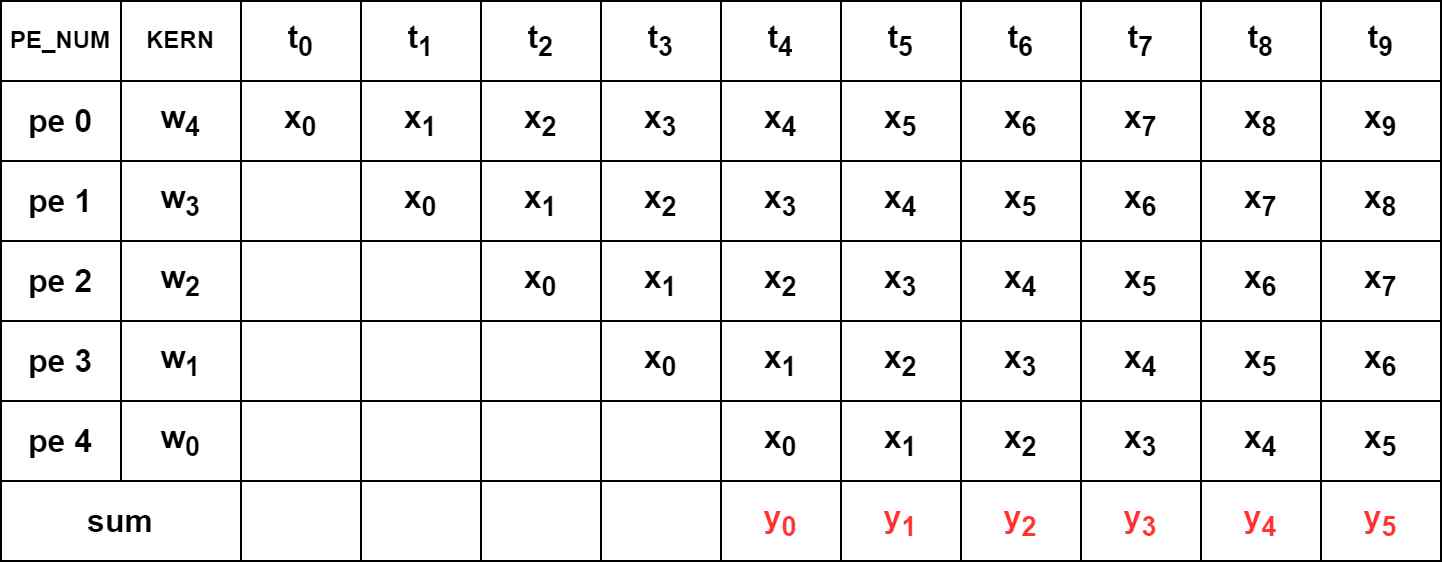
[picture p194: figure]

Fig 12. An example of execution flow in the proposed architecture

Fig 12. 은 PE array에서 2D Convolution을 수행하는 과정의 예시이다. 본 예시에서 입력 5x10 크기의 feature map matrix를 , 5x5 크기의 kernal matrix를 , 출력 벡터를 라고 정의한다. 표 상단부

- 는 cycle 변화를 나타낸 것이다. | : 5x1 column vector ∈
| : 5x1 column vector ∈
- | : 1x6 output vector

출력 벡터 의 임의의 성분 에 대해 아래의 식과 같이 표현할 수 있다.

여기서 하나의 내적 연산

- 이 하나의 PE에서 수행되며, summation 연산은 Fig 11 (a). 하단부의

adder에서 수행된다. feature map matrix 는 column vector 단위 ()로 PE array에 입력되며,

shifting을 통해 다음 PE로 이동한다. 모든 PE에 feature map 데이터가 들어있으면, 출력 벡터 의 성

분 가 차례대로 한 cycle마다 PE array에서 출력된다.

Vector 단위의 feature map shifting과 연산 구조를 도입했기 때문에 systolic array의 데이터 재사용 성은 그대로 유지하는 반면, output이 출력되는데 필요한 latency는 3N-1 cycle에서 2N cycle로 감소하 였다. 또한 입력 데이터가 0인지 판단하는 zero detect unit을 파이프라인 가장 앞쪽에 배치하여, 해당 정보도 같이 shift 되기 때문에 하나의 zero detect unit만 이용하여 모든 PE에 zero bit 정보를 전달 할 수 있다.

3.2.4 Pseudo Zero Skipping

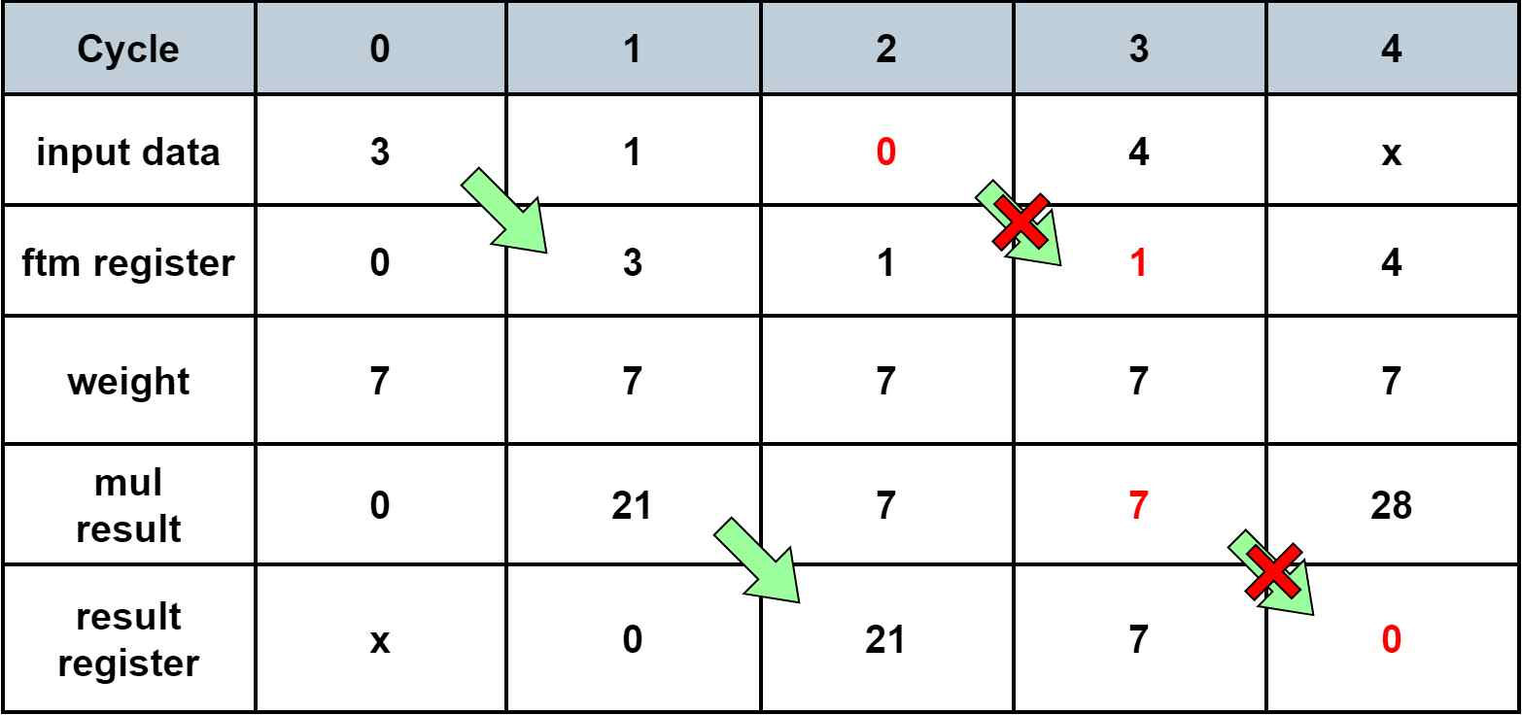
[picture p195: figure]
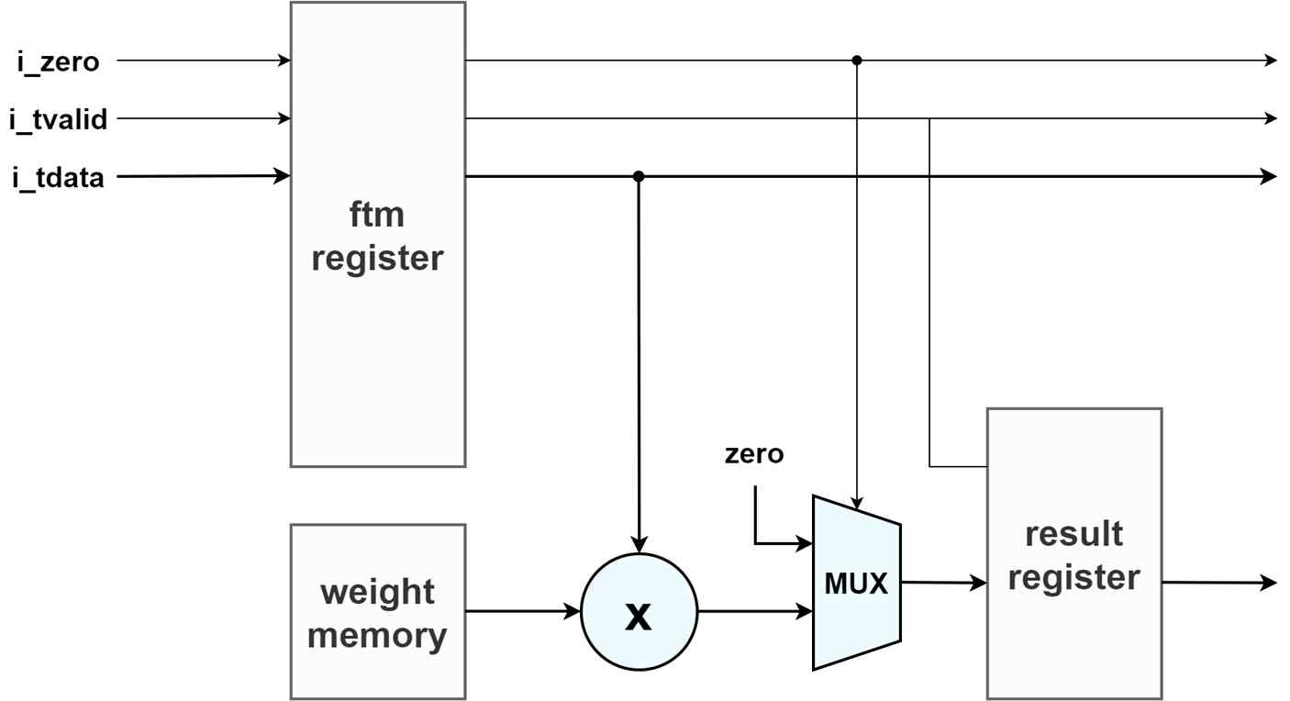
[picture p196: figure]

(a) (b)

Fig 13. Architecture of zero skipping logic and an example of execution flow

Convolution 연산은 다수의 곱셈과 덧셈을 수행하는 고비용의 연산으로, 이 과정에서 다수의 switching 이 발생하며 전력이 소모된다. 현대 deep learning 모델은 relu와 같은 activation 함수를 많이 사용하 기 때문에, feature map data에‘0’값이 다수 분포되어 있다. 따라서 convolution 연산 이전에 feature map에서 zero 데이터를 감지하면, 불필요한 연산을 제거할 수 있다. 하지만 이러한 zero skipping 기법은 searching algorithm과 scheduling이 필요하다. 이를 hardware에서 구현하는 것은 다 소 복잡하며, 비용 또한 만만치 않다. 따라서 searching algorithm과 scheduling을 적용하지 않고, 앞 서 제시한 PE array의 pipeline 초기 단계에서 zero 값을 detection 하여 pipeline register에서 feature map data의 update를 차단하는 방식으로 switching을 감소시켜 전력 소모를 절감할 수 있다.

Fig 13. 는 본 과제에서 제안하는 psuedo zero skipping 기법을 구현하기 위한 logic의 구조와 동작 과 정을 보여준다. 데이터의 값이 0인지 여부를 확인하는 zero bit, 데이터의 유효성을 확인하는 valid bit, feature map 데이터가 입력으로 인가되면 데이터의 유효성을 판단하고 ftm register에 저장된다. 이때, zero bit, valid bit에 따라 데이터의 저장 여부를 결정한다.

Fig 13 (b). 의 예시를 살펴보면, cycle 0에서 입력 데이터는 0이 아니기 때문에 (valid data로 가정) ftm register에 저장되며, 다음 cycle에 weight와 곱해져 result register에 저장된다. 반면 cycle 2에 서 입력 데이터는 0이기 때문에 ftm register에 저장되지 않고, ftm register는 현재 값을 유지한다. 이 과정에서 곱셈 logic에는 이전 cycle과 동일한 데이터가 연결되어 있어 signal switching이 발생하

지 않는다. 해당 cycle의 연산 결과는 0이 되어야 하므로 MUX에서 ‘hard-wired’된 0값이 result register에 저장되어 연산 결과는 일치한다. MAC 연산 과정에서 곱셈 연산에서 가장 많은 전력 소모가 발생하기 때문에 위와 같은 pseudo zero skipping 기법을 적용하면 간단한 비교기만 사용하여 곱셈 연 산에서 발생하는 signal switching을 감소시킬 수 있다. 3.2.5 Model Re-Design with Bit Precision Scaling

본 과제의 목표는 classification 작업을 수행하는 것이기 때문에 최종 출력에서는 절대적인 예측값보 다 클래스 간의 상대적인 차이가 더 중요하다. 이러한 특성을 고려하여, weight를 INT6 또는 INT4와 같 은 더 작은 scale을 사용할 수 있을 것으로 가정하고 이를 검증하는 실험을 수행하였다.
FP32에서 INT로의 변환은 per-tensor uniform symmetric quantization을 적용하였다. 이 방식은 zero-point를 0으로 고정하고 scale factor만을 사용하여 [-2^(N-1)+1, 2^(N-1)-1] 범위로 양자화하는 방법이다. 구체적으로 INT6의 경우 scale factor 64를 사용하여 [-63, 63] 범위로, INT8 bias의 경우 scale factor 128을 사용하여 [-127, 127] 범위로 양자화하였다. baseline 모델은 FP32 정밀도에서 96.07%, INT8 정밀도에서 96.32%의 정확도를 보였다. 그러나 INT4로 quantization을 진행한 경우 정확 도가 90.69%로 급격히 하락하는 현상이 관찰되었다. 더 높은 정확도와 quantization robustness를 확보

하기 위해 모델 구조는 baseline과 동일하게 유지한 채 재훈련을 진행하였다. 이는 본 연구의 목적이 알고리즘 구조 개선보다는 hardware 적용 시의 효율성 향상에 있기 때문이다. 일반적으로 낮은 정밀도에서 급격히 성능이 저하된 원인은 모델이 weight 분포가 특정 부분에서 sharp

하게 밀집되어, 학습이 수치적으로 안정적인 minimum에 도달하지 못했기 때문으로 해석된다. 이러한 현 상은 quantization과 같은 수치적 변화에 취약한 비견고한 학습 상태를 의미한다. 이를 보완하기 위해 weight 값의 정밀도가 감소하거나 노이즈가 주입되더라도 주요한 feature 표현이 유지되는 것을 목표로 하였다. 이를 위해 다음과 같은 검증된 학습 기법을 적용하였다. 먼저, optimizer를 기존의 SGD에서 Adam으로 변경하였다. Adam은 파라미터마다 adaptive learning rate

을 적용하여, SGD보다 빠르고 안정적으로 수렴하는 것으로 알려져 있다. 손실 함수는 기존의 NLL Loss와 LogSoftmax 조합 대신, 수치적으로 더 안정적이고 다중 클래스 분류에

서 표준적으로 사용되는 CrossEntropy Loss로 변경하였다. 학습의 안정성과 재현성을 향상시키기 위해 weight 초기화 방식도 개선하였다. ReLU를 사용하는

convolution layer에는 Kaiming 초기화, fully connected layer에는 Xavier 초기화를 적용하였다. 이러 한 초기화 방법은 학습 초기에 activation의 분산을 적절히 유지하여 gradient vanishing을 방지하고 학습의 수렴 특성을 개선한다. 마지막으로, 모델의 일반화 성능을 높이고 overfitting을 방지하기 위해 data augmentation과 early

stopping을 도입하였다. 학습 데이터에는 ±5도의 random rotation과 ±5%의 random translation을 적 용하여 다양한 입력 변형에 대한 적응력을 높였다. 또한 validation set의 성능이 더 이상 개선되지 않 을 때 학습을 종료하여, 가장 우수한 일반화 성능을 보이는 시점의 weight를 확보하였다. 개선된 학습 전략을 활용하여 모델을 재훈련하였다. Fig.를 보면, 정밀도가 낮을수록 정확도도 낮은 경
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
