jbpark0616/IDEC_Challenge/docs/figures/graphs/multicast_transport_supply.pdf

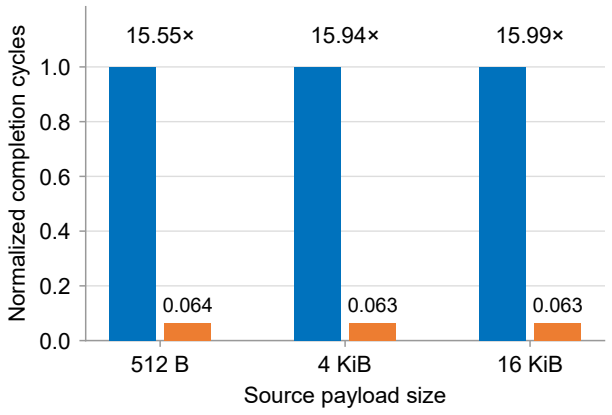
[picture p197: figure]
4 KiB; 16 KiB; Source payload size; Normalized completion cycles

(a) Fanout + receive FIFOs

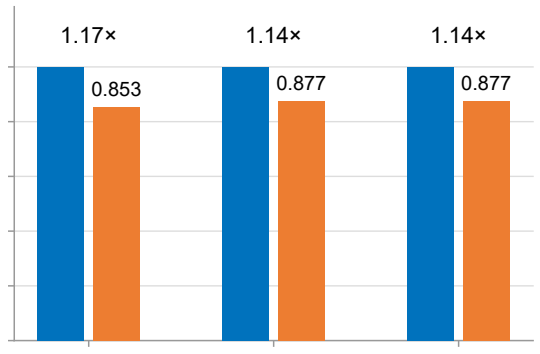
[picture p198: figure]

512 B | 4 KiB | 16 KiB
| Source payload size
(b) SRAM load + tile feed + delivery
Repeated per-core transfer | Single transfer + multicast
