jbpark0616/IDEC_Challenge/docs/figures/free_topic/fig06_mac_activity/figure.png

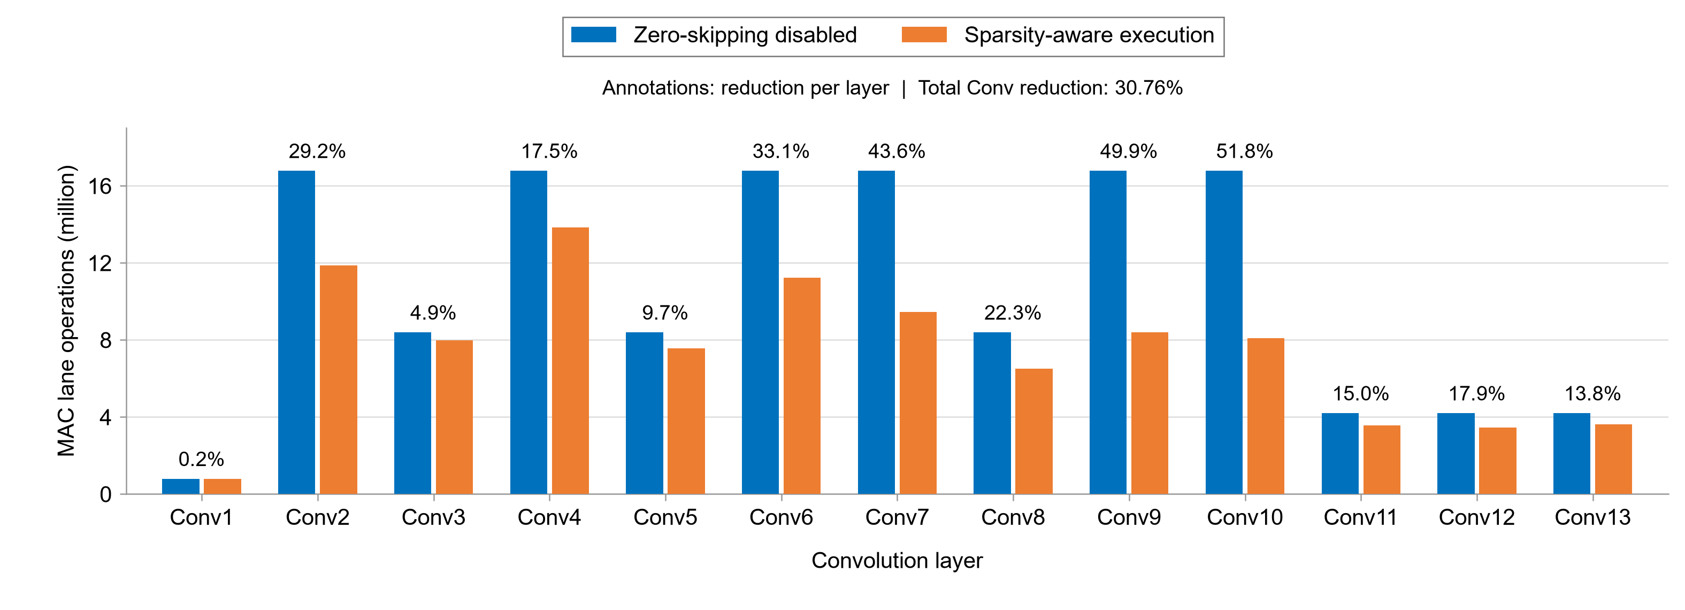
docs/figures/free_topic/fig06_mac_activity/figure.png
