jbpark0616/IDEC_Challenge/docs/figures/graphs/multicast_transport.png

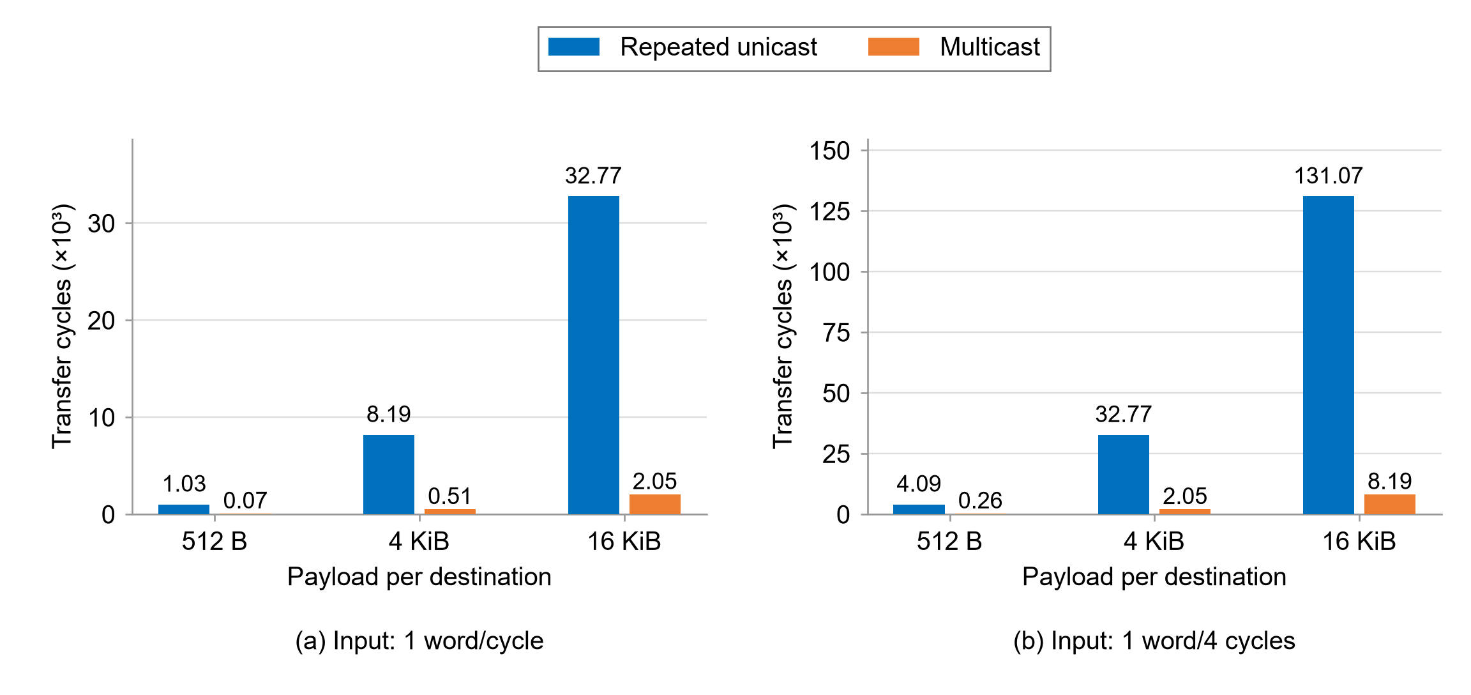
docs/figures/graphs/multicast_transport.png
