jbpark0616/IDEC_Challenge/docs/figures/graphs/multicast_transport_supply.png

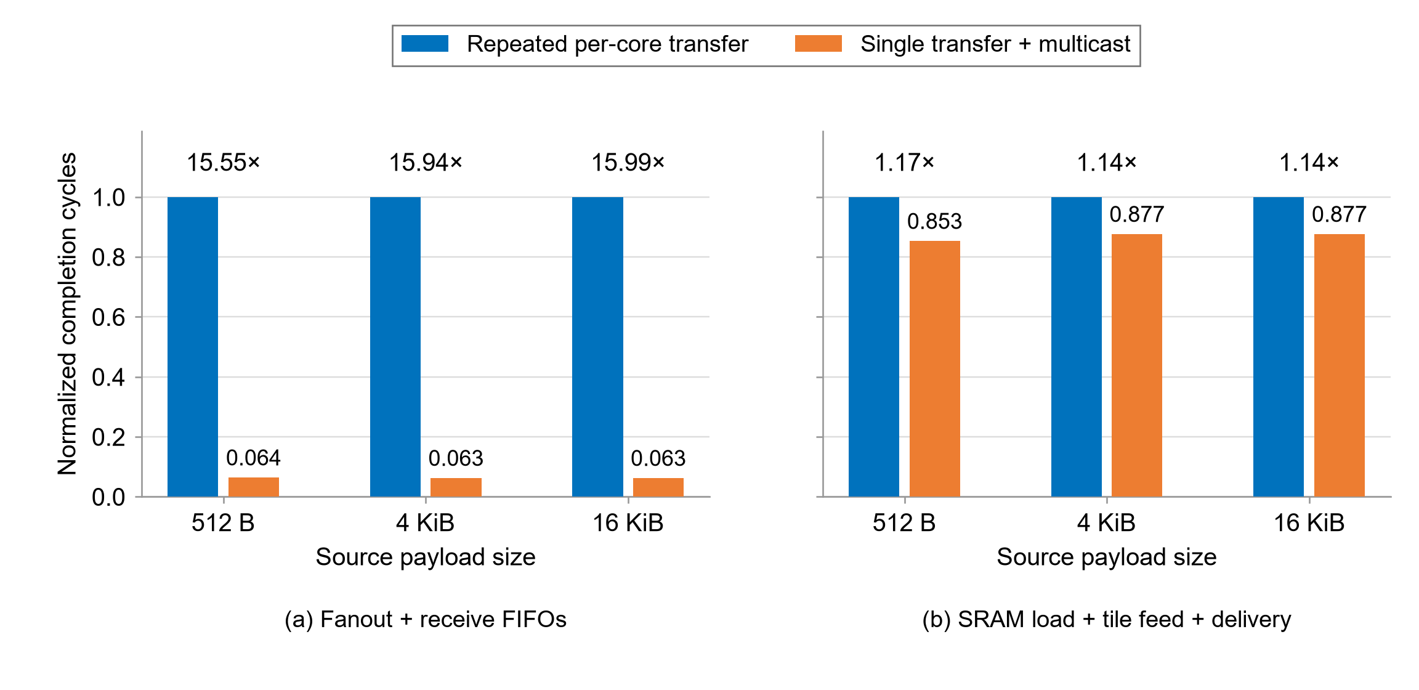
docs/figures/graphs/multicast_transport_supply.png
