jbpark0616/IDEC_Challenge/docs/figures/winograd_bitwidth_selection.png

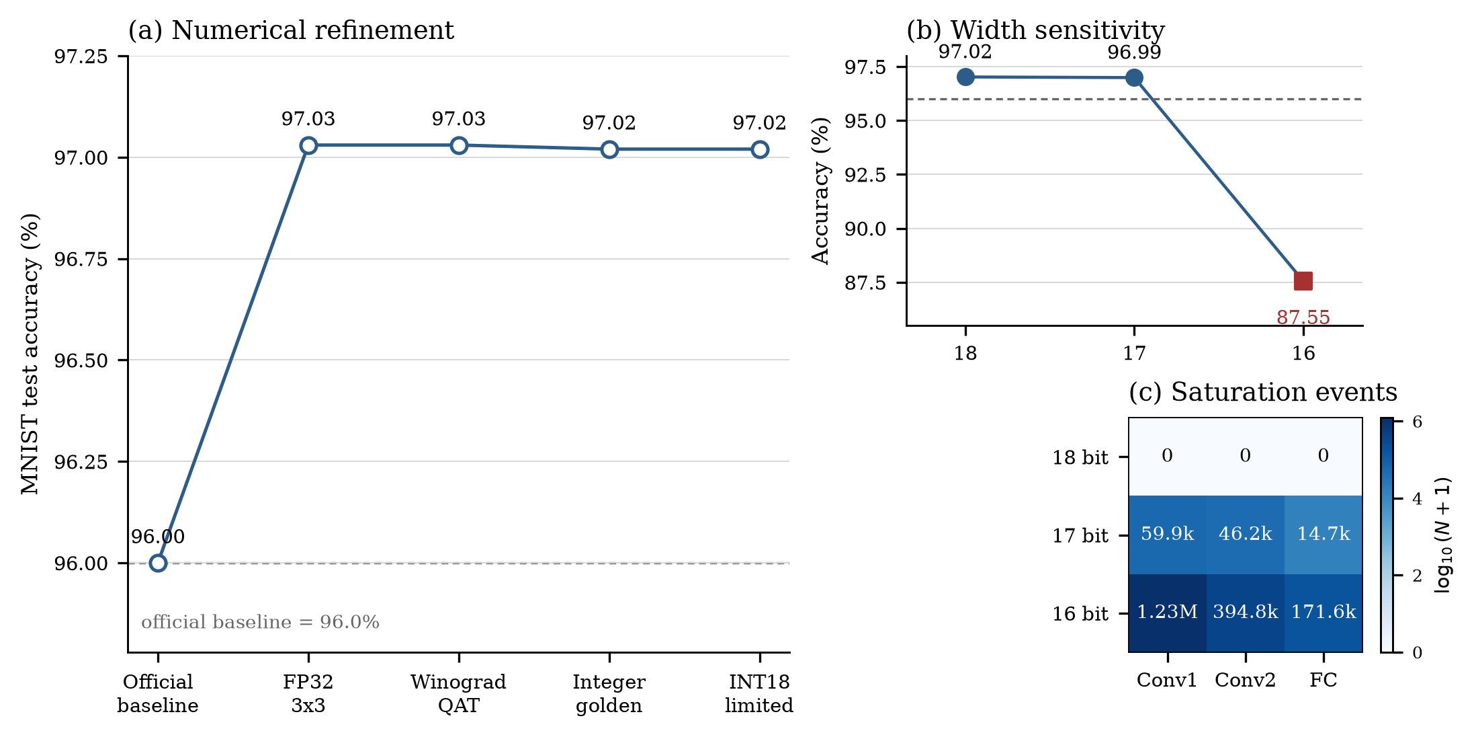
docs/figures/winograd_bitwidth_selection.png
