jbpark0616/IDEC_Challenge/docs/IDEC_GitHub_QR.png

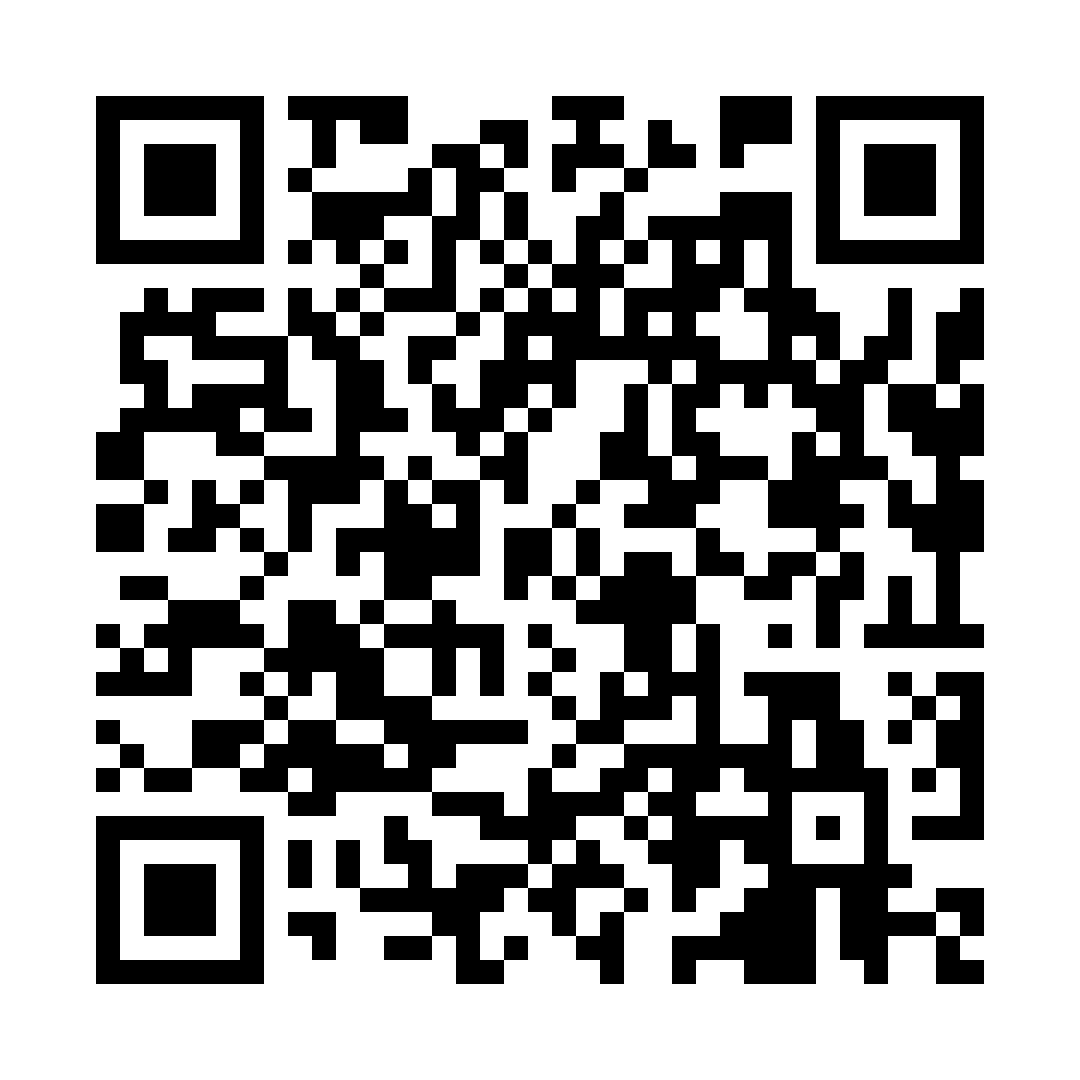
docs/IDEC_GitHub_QR.png
