jbpark0616/IDEC_Challenge/docs/report_assets/free_topic/figures/vgg_controlled_cycle_energy_with_examples.png

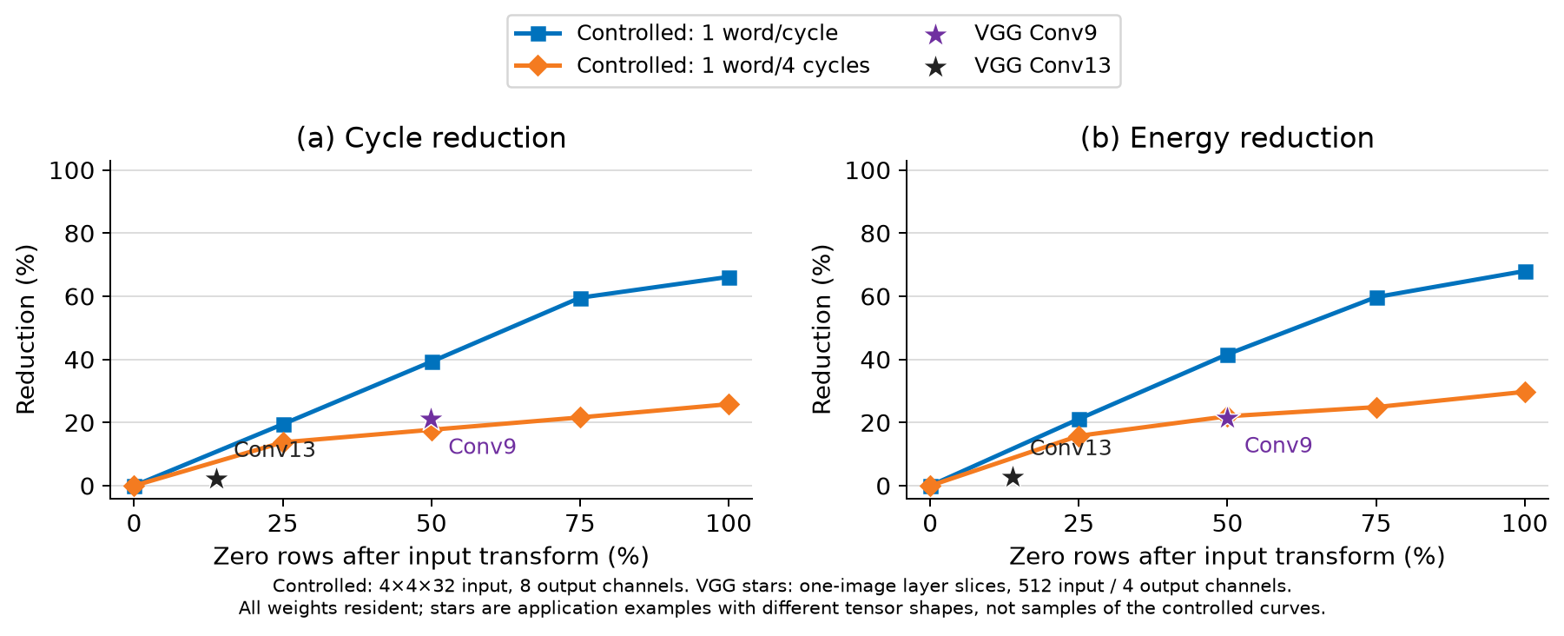
docs/report_assets/free_topic/figures/vgg_controlled_cycle_energy_with_examples.png
