jbpark0616/IDEC_Challenge/docs/buffer_depth_optimization/ppa_comparison.csv

m_fifo_depth | total_area_um2 | sequential_area_um2 | flip_flop_count | fmax_mhz | vectorless_power_mw
2 | 9488.416140 | 3264.141240 | 10752 | 1074.84 | 43.7
1 | 9366.148260 | 3176.690400 | 10453 | 1092.26 | 42.8
