jbpark0616/IDEC_Challenge/docs/experiment_results/free_topic/extra_vgg_ppa/comparison.csv

layer | input_NHWC | local_output_channels | area_off_um2 | area_on_um2 | fmax_off_mhz | fmax_on_mhz | clock_mhz | active_cycles_off | active_cycles_on | row_issues_off | row_issues_on | power_off_mw | power_on_mw | power_reduction_pct | latency_off_us | latency_on_us | latency_reduction_pct | energy_off_nj | energy_on_nj | energy_reduction_pct
Conv8 | [1,4,4,256] | 4 | 35958.2895 | 35958.2895 | 725.89 | 725.89 | 699.3006993006993 | 5236 | 4630 | 16384 | 12728 | 38.56055066 | 38.59942779 | -0.10082099278818646 | 7.49177 | 6.62233 | 11.605268180950567 | 288.88677661806815 | 255.6181486365507 | 11.516147734758142
Conv12 | [1,2,2,512] | 4 | 35958.2895 | 35958.2895 | 725.89 | 725.89 | 699.3006993006993 | 3128 | 3044 | 8192 | 6724 | 37.6900807 | 37.40495443 | 0.7565021477919154 | 4.47733 | 4.35721 | 2.6828489300542935 | 168.750929020531 | 162.98124149194027 | 3.4190552680683384
