jbpark0616/IDEC_Challenge/docs/experiment_results/free_topic/layer_ppa/comparison.csv

layer | input_NHWC | local_output_channels | area_off_um2 | area_on_um2 | fmax_off_mhz | fmax_on_mhz | clock_mhz | active_cycles_off | active_cycles_on | row_issues_off | row_issues_on | power_off_mw | power_on_mw | power_reduction_pct | latency_off_us | latency_on_us | latency_reduction_pct | energy_off_nj | energy_on_nj | energy_reduction_pct
Conv9 | [1,4,4,512] | 4 | 35958.2895 | 35958.2895 | 725.89 | 725.89 | 699.3006993006993 | 12488 | 9856 | 32768 | 16408 | 36.50921211 | 36.305807529999996 | 0.5571322092275177 | 17.86213 | 14.09837 | 21.071171243295172 | 652.1322929063944 | 511.85270770672605 | 21.510909170664817
Conv13 | [1,2,2,512] | 4 | 35958.2895 | 35958.2895 | 725.89 | 725.89 | 699.3006993006993 | 3125 | 3055 | 8192 | 7060 | 37.89423034 | 37.64853626 | 0.6483680438830741 | 4.47161 | 4.37437 | 2.174608250719534 | 169.44821933064742 | 164.6886275596562 | 2.8088768296253064
