jbpark0616/IDEC_Challenge/docs/experiment_results/free_topic/controlled_power/slow/measurements.csv

case | sparse | input_NHWC | local_output_channels | duration_ps | clock_period_ps | power_w | energy_nj | unannotated_lef_only_sdel_pins | analysis_elapsed_s | vcd_sha256
2 | 0 | [1,4,4,32] | 8 | 2054910 | 1430 | 0.03591481224 | 73.8017068200984 | 40 | 75.51419602299939 | 5c61cfea694f7b714920eded31c09b30be8d47ef52a9db75350293f656495cee
2 | 1 | [1,4,4,32] | 8 | 1688830 | 1430 | 0.03408830613 | 57.56935404152791 | 40 | 51.61265179799739 | a668bd936036def6cf1a2a025022a5dcb9d1b0f1c3fc203608ef52c65fb148a9
