jbpark0616/IDEC_Challenge/docs/experiment_results/free_topic/report700/core_actual/measurements.csv

case | input | local_K | U_block | sparse | cycles | transforms | V_writes | releases | requests | U_words | weight_wait | rows | early | resident | preload | elapsed | mac_beats | mac_lanes | v_read_blocked | v_write_blocked | no_ready_channel | mac_backpressure | busy | result_blocked | weight_mac_overlap | mode | u_bytes | u_capacity_bytes | capacity_fits | preload_plus_run | data_kind
0 | 1,4,4,3 | 6 | 2 | 0 | 573 | 12 | 12 | 4 | 11 | 48 | 284 | 288 | 2 | 1 | 96 | 575 | 72 | 1152 | 0 | 1 | 8 | 0 | 152 | 0 | 0 | capacity_policy | 288 | 32768 | 1 | 671 | synthetic
0 | 1,4,4,3 | 6 | 2 | 1 | 529 | 12 | 12 | 4 | 11 | 48 | 265 | 192 | 1 | 1 | 96 | 531 | 48 | 768 | 0 | 0 | 9 | 0 | 129 | 0 | 0 | capacity_policy | 288 | 32768 | 1 | 627 | synthetic
1 | 1,4,4,128 | 6 | 2 | 0 | 3973 | 512 | 512 | 4 | 11 | 1536 | 272 | 12288 | 126 | 1 | 3072 | 3975 | 3072 | 49152 | 163 | 162 | 259 | 0 | 3566 | 0 | 0 | capacity_policy | 12288 | 32768 | 1 | 7047 | synthetic
1 | 1,4,4,128 | 6 | 2 | 1 | 3229 | 512 | 512 | 4 | 11 | 1536 | 272 | 9204 | 94 | 1 | 3072 | 3231 | 2304 | 36816 | 155 | 155 | 291 | 0 | 2822 | 0 | 0 | capacity_policy | 12288 | 32768 | 1 | 6303 | synthetic
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
