jbpark0616/IDEC_Challenge/docs/experiment_results/README.md

# 실험결과

- [designated](designated/): 지정주제
- [free_topic](free_topic/): 자유주제

측정 조건·원시 수치·검증 로그를 보존한다. 서로 다른 입력, 공급 속도, 정밀도 및 측정 구간의 결과를 동일 조건으로 취급하지 않는다.
자유주제의 최종 레이어 PPA 재현은 [제출 패키지](../../submission/IDEC2026_FREE_TOPIC/README.md)를 사용한다.
