jbpark0616/IDEC_Challenge/docs/experiment_results/free_topic/controlled_power/comparison.csv

rate | zero_row_pct | input_NHWC | output_channels | cycles_off | cycles_on | cycle_reduction_pct | power_off_mw | power_on_mw | energy_off_nj | energy_on_nj | energy_reduction_pct
fast | 0 | [1,4,4,32] | 8 | 1273 | 1273 | 0.0 | 34.394372249999996 | 34.39439833 | 62.8079071094475 | 62.8079547343963 | -7.58263584810237e-05
fast | 25 | [1,4,4,32] | 8 | 1273 | 1025 | 19.481539670070703 | 35.30728817 | 34.55722332 | 64.4749920001187 | 50.8499173986804 | 21.132340119426807
fast | 50 | [1,4,4,32] | 8 | 1273 | 773 | 39.27729772191674 | 36.27116233 | 34.79208052 | 66.23513224243631 | 38.657828586577196 | 41.63546251394145
fast | 75 | [1,4,4,32] | 8 | 1273 | 515 | 59.54438334642577 | 35.23102403 | 35.040769729999994 | 64.3357252914233 | 25.905991469086295 | 59.73311662884158
fast | 100 | [1,4,4,32] | 8 | 1273 | 431 | 66.14296936370778 | 34.04965997 | 32.143954189999995 | 62.1784245678167 | 19.903214994906097 | 67.99015875161314
slow | 0 | [1,4,4,32] | 8 | 1433 | 1433 | 0.0 | 34.245058889999996 | 34.24509987 | 70.3705139636499 | 70.3705981738617 | -0.00011966689890119397
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
