jbpark0616/IDEC_Challenge/docs/experiment_results/free_topic/extra_vgg_ppa/measurements.csv

case | sparse | input_NHWC | local_output_channels | duration_ps | clock_period_ps | power_w | energy_nj | unannotated_lef_only_sdel_pins | analysis_elapsed_s | vcd_sha256
12 | 0 | [1,4,4,256] | 4 | 7491770 | 1430 | 0.03856055066 | 288.88677661806815 | 40 | 437.7555273020007 | ebaa06a62f927ba2588c201ed2f82d75e6c020785320c554bfeb9a3d4757b809
12 | 1 | [1,4,4,256] | 4 | 6622330 | 1430 | 0.03859942779 | 255.6181486365507 | 40 | 357.88973198700114 | b6d3e4a0f681efdff6ae79415efd8bb429498023c949e70386d265eb5c4fe3ab
13 | 0 | [1,2,2,512] | 4 | 4477330 | 1430 | 0.0376900807 | 168.750929020531 | 40 | 246.22235601799912 | b73c92afa3de79e13dc2317ed7afb1b4a83cabc08b6e8e494b8636eb8386b50e
13 | 1 | [1,2,2,512] | 4 | 4357210 | 1430 | 0.03740495443 | 162.98124149194027 | 40 | 222.92208675000074 | c4507435cd39e33fb882105d3f3422a45d4d125ab04e6b0a7ae7434b1acea8f6
