jbpark0616/IDEC_Challenge/docs/experiment_results/free_topic/figure_data/mac_three_way.csv

layer | H | W | Cin | Cout | direct_analytical | winograd_rtl | sparse_rtl | sparse_reduction_vs_winograd_pct | combined_reduction_vs_direct_pct
Conv1 | 32 | 32 | 3 | 64 | 1769472 | 786432 | 784896 | 0.1953125 | 55.642361111111114
Conv2 | 32 | 32 | 64 | 64 | 37748736 | 16777216 | 11885824 | 29.15496826171875 | 68.51331922743056
Conv3 | 16 | 16 | 64 | 128 | 18874368 | 8388608 | 7975936 | 4.91943359375 | 57.741970486111114
Conv4 | 16 | 16 | 128 | 128 | 37748736 | 16777216 | 13846016 | 17.4713134765625 | 63.320583767361114
Conv5 | 8 | 8 | 128 | 256 | 18874368 | 8388608 | 7578624 | 9.65576171875 | 59.84700520833333
Conv6 | 8 | 8 | 256 | 256 | 37748736 | 16777216 | 11224064 | 33.099365234375 | 70.26638454861111
Conv7 | 8 | 8 | 256 | 256 | 37748736 | 16777216 | 9466880 | 43.572998046875 | 74.92133246527779
Conv8 | 4 | 4 | 256 | 512 | 18874368 | 8388608 | 6516736 | 22.314453125 | 65.47309027777779
Conv9 | 4 | 4 | 512 | 512 | 37748736 | 16777216 | 8400896 | 49.9267578125 | 77.74522569444444
Conv10 | 4 | 4 | 512 | 512 | 37748736 | 16777216 | 8081408 | 51.8310546875 | 78.59157986111111
Conv11 | 2 | 2 | 512 | 512 | 9437184 | 4194304 | 3563520 | 15.0390625 | 62.23958333333333
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
