jbpark0616/IDEC_Challenge/docs/experiment_results/free_topic/layer_ppa/measurements.csv

case | sparse | input_NHWC | local_output_channels | duration_ps | clock_period_ps | power_w | energy_nj | simulation_wall_s | vcd_sha256
10 | 0 | [1,4,4,512] | 4 | 17862130 | 1430 | 0.03650921211 | 652.1322929063944 | 237.86928562899993 | ad3b8fb08b76d012c27159b50c46c3caed343e274b1cd6a8241d369bd820e569
10 | 1 | [1,4,4,512] | 4 | 14098370 | 1430 | 0.03630580753 | 511.85270770672605 | 609.9514496929987 | 0b4c85917338f913ab2b1485f899ce3bebb44208d777c0af74aa7c2461ee52b7
11 | 0 | [1,2,2,512] | 4 | 4471610 | 1430 | 0.03789423034 | 169.44821933064742 | 312.5298462069986 | eee056456c687e89ce1ec9bf4764080d79a4cf8d9005cec776d50f02b3f7c05e
11 | 1 | [1,2,2,512] | 4 | 4374370 | 1430 | 0.03764853626 | 164.6886275596562 | 228.5689467250013 | f0283e12551f3a875f084484b8383fc77708083d85fe6ecd1b84d72a679bc473
