jbpark0616/IDEC_Challenge/docs/experiment_results/free_topic/multicast_profile/measurements.csv

bytes | period | multicast | cycles | external_bytes | received_words
512 | 1 | 0 | 1026 | 8192 | 1024
512 | 1 | 1 | 66 | 512 | 1024
512 | 4 | 0 | 4095 | 8192 | 1024
512 | 4 | 1 | 255 | 512 | 1024
4096 | 1 | 0 | 8194 | 65536 | 8192
4096 | 1 | 1 | 514 | 4096 | 8192
4096 | 4 | 0 | 32767 | 65536 | 8192
4096 | 4 | 1 | 2047 | 4096 | 8192
16384 | 1 | 0 | 32770 | 262144 | 32768
16384 | 1 | 1 | 2050 | 16384 | 32768
16384 | 4 | 0 | 131071 | 262144 | 32768
16384 | 4 | 1 | 8191 | 16384 | 32768
