jbpark0616/IDEC_Challenge/docs/experiment_results/free_topic/multicast_profile/supply_effects.csv

input_NHWC | bytes | period | repeated_load_cycles | single_load_mcast_cycles | speedup | reduction_percent | external_bytes_repeated | external_bytes_mcast | repeated_load_phase | mcast_load_phase | tile_words_per_receiver
[1,4,4,32] | 512 | 1 | 6531 | 5572 | 1.1721105527638191 | 14.683815648445876 | 8192 | 512 | 1024 | 64 | 256
[1,4,4,32] | 512 | 4 | 9600 | 5761 | 1.6663773650407916 | 39.989583333333336 | 8192 | 512 | 4093 | 253 | 256
[1,8,8,64] | 4096 | 1 | 62211 | 54532 | 1.1408164013790068 | 12.34347623410651 | 65536 | 4096 | 8192 | 512 | 2048
[1,8,8,64] | 4096 | 4 | 86784 | 56065 | 1.5479175956479088 | 35.397077802359874 | 65536 | 4096 | 32765 | 2045 | 2048
[1,8,8,256] | 16384 | 1 | 248835 | 218116 | 1.1408379027673348 | 12.345128297868069 | 262144 | 16384 | 32768 | 2048 | 8192
[1,8,8,256] | 16384 | 4 | 347136 | 224257 | 1.5479383029292286 | 35.39794201696165 | 262144 | 16384 | 131069 | 8189 | 8192
