jbpark0616/IDEC_Challenge/docs/experiment_results/free_topic/multicast_profile/supply_measurements.csv

h | cin | bytes | period | multicast | cycles | load_cycles | external_bytes | received_words | source0_reads
4 | 32 | 512 | 1 | 0 | 6531 | 1024 | 8192 | 4096 | 1152
4 | 32 | 512 | 1 | 1 | 5572 | 64 | 512 | 4096 | 1152
4 | 32 | 512 | 4 | 0 | 9600 | 4093 | 8192 | 4096 | 1152
4 | 32 | 512 | 4 | 1 | 5761 | 253 | 512 | 4096 | 1152
8 | 64 | 4096 | 1 | 0 | 62211 | 8192 | 65536 | 32768 | 12544
8 | 64 | 4096 | 1 | 1 | 54532 | 512 | 4096 | 32768 | 12544
8 | 64 | 4096 | 4 | 0 | 86784 | 32765 | 65536 | 32768 | 12544
8 | 64 | 4096 | 4 | 1 | 56065 | 2045 | 4096 | 32768 | 12544
8 | 256 | 16384 | 1 | 0 | 248835 | 32768 | 262144 | 131072 | 50176
8 | 256 | 16384 | 1 | 1 | 218116 | 2048 | 16384 | 131072 | 50176
8 | 256 | 16384 | 4 | 0 | 347136 | 131069 | 262144 | 131072 | 50176
8 | 256 | 16384 | 4 | 1 | 224257 | 8189 | 16384 | 131072 | 50176
