jbpark0616/IDEC_Challenge/docs/experiment_results/free_topic/controlled_power/fast/measurements.csv

case | sparse | input_NHWC | local_output_channels | duration_ps | clock_period_ps | power_w | energy_nj | unannotated_lef_only_sdel_pins | analysis_elapsed_s | vcd_sha256
3 | 0 | [1,4,4,32] | 8 | 1826110 | 1430 | 0.03523102403 | 64.3357252914233 | 40 | 81.78111319399977 | b7ad94d5c941458d646c1e5154939217e417dabe3a8f55278edee0ee3259224c
3 | 1 | [1,4,4,32] | 8 | 739310 | 1430 | 0.03504076973 | 25.905991469086295 | 40 | 59.934349250001105 | ae9d414504bbea9202314b6a2579997173f6e2f862b96b059ff68381e8964a39
4 | 0 | [1,4,4,32] | 8 | 1826110 | 1430 | 0.03404965997 | 62.1784245678167 | 40 | 65.80835206399934 | 4e44cfb8d03793de7ba32b5b3901ecfeaf18b680787d288f34813a7e6fcb1ea3
4 | 1 | [1,4,4,32] | 8 | 619190 | 1430 | 0.03214395419 | 19.903214994906097 | 40 | 42.11720728799992 | e9e65fb34c30a5a1345379103ebdf2d1ad1468d077ee6e83863b230e78c902a0
