jbpark0616/IDEC_Challenge/docs/experiment_results/free_topic/controlled_power/supply8/measurements.csv

case | sparse | input_NHWC | local_output_channels | duration_ps | clock_period_ps | power_w | energy_nj | unannotated_lef_only_sdel_pins | analysis_elapsed_s | vcd_sha256
3 | 0 | [1,4,4,32] | 8 | 3307590 | 1430 | 0.0341443643 | 112.93555791503701 | 40 | 94.35186416899887 | 6916d56f085422d09a5f7e2cc9754d2641f17e760b2e65193fc90574aa721278
3 | 1 | [1,4,4,32] | 8 | 3067350 | 1430 | 0.03292421624 | 100.990094683764 | 40 | 67.61501858500196 | a879e087b593ee373075b91d1989005570368c82c7d45b135345de75e333ddec
4 | 0 | [1,4,4,32] | 8 | 3307590 | 1430 | 0.03350522742 | 110.8215551621178 | 40 | 79.33089936400211 | 98030a263d8b29db12f3fa8bb93b15d2f9968bc8d0626f9d64aa72df9b4014cd
4 | 1 | [1,4,4,32] | 8 | 2981550 | 1430 | 0.03217661381 | 95.9361829052055 | 40 | 58.51245270999789 | 46ae844bea1be6084ab81c9d5385844c2751e6f6c0b7b8f6bb0933f887bf581a
