jbpark0616/IDEC_Challenge/docs/experiment_results/free_topic/figure_sources/fig01_sparse_scaling/source_data.csv

source | rate | case | pattern | input_NHWC | local_K | u_bytes | zero_row_percent | ideal_dense_beats | ideal_sparse_beats | row0_zero_percent | row1_zero_percent | row2_zero_percent | row3_zero_percent | cycles_off | cycles_on | cycle_reduction | mac_beats_off | mac_beats_on | ideal_beat_reduction | actual_beat_reduction | wait_off | wait_on | weight_wait_off | weight_wait_on | v_block_off | v_block_on | inclusive_off | inclusive_on | u_fits_32kib | inclusive_off_us_700mhz | inclusive_on_us_700mhz
scale32 | fast | 0 | dense | 1,4,4,32 | 8 | 4096 | 0.0 | 1024 | 1024 | 0.0 | 0.0 | 0.0 | 0.0 | 1273 | 1273 | 0.0 | 1024 | 1024 | 0.0 | 0.0 | 66 | 66 | 0 | 0 | 40 | 40 | 2300 | 2300 | 1 | 3.2857142857142856 | 3.2857142857142856
scale32 | fast | 1 | balanced25 | 1,4,4,32 | 8 | 4096 | 25.0 | 1024 | 768 | 25.0 | 25.0 | 25.0 | 25.0 | 1273 | 1025 | 19.481539670070703 | 1024 | 768 | 25.0 | 25.0 | 66 | 74 | 0 | 0 | 40 | 40 | 2300 | 2052 | 1 | 3.2857142857142856 | 2.9314285714285715
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
