jbpark0616/IDEC_Challenge/docs/experiment_results/free_topic/report700/cluster/measurements.csv

layer | sparse | activation_preload | weight_preload | cycles | mac_beats | mac_lanes | weight_wait_corecycles | writer_stall_corecycles | preload | U_words | replacements | source_reads | compared_words | resident_u | input_NHWC | output_channels | u_bytes_per_core | image_index | clock_mhz | inclusive_cycles | simulation_seconds | inclusive_latency_us_at_700mhz
0 | 0 | 384 | 560 | 30561 | 49152 | 786432 | 0 | 0 | 560 | 512 | 0 | 6076 | 8192 | 1 | [1,32,32,3] | 64 | 192 | 0 | 700 | 31505 | 35.36666759299999 | 45.00714285714286
0 | 1 | 384 | 560 | 30561 | 49152 | 784896 | 0 | 0 | 560 | 512 | 0 | 6076 | 8192 | 1 | [1,32,32,3] | 64 | 192 | 0 | 700 | 31505 | 34.60913729800001 | 45.00714285714286
4 | 0 | 1024 | 65584 | 110512 | 524288 | 8388608 | 72963 | 0 | 65584 | 65536 | 496 | 25088 | 2048 | 1 | [1,8,8,128] | 256 | 32768 | 0 | 700 | 177120 | 108.99343316099998 | 253.02857142857144
4 | 1 | 1024 | 65584 | 110375 | 498960 | 7578624 | 77675 | 0 | 65584 | 65536 | 496 | 25088 | 2048 | 1 | [1,8,8,128] | 256 | 32768 | 0 | 700 | 176983 | 94.87953180600005 | 252.83285714285714
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
