jbpark0616/IDEC_Challenge/docs/experiment_results/free_topic/report700/cluster_all/measurements.csv

layer | sparse | activation_preload | weight_preload | cycles | mac_beats | mac_lanes | weight_wait_corecycles | writer_stall_corecycles | preload | U_words | replacements | source_reads | compared_words | resident_u | input_NHWC | output_channels | u_bytes_per_core | image_index | clock_mhz | inclusive_cycles | simulation_seconds | input_layout | inclusive_latency_us_at_700mhz
0 | 0 | 384 | 560 | 30561 | 49152 | 786432 | 0 | 0 | 560 | 512 | 0 | 6076 | 8192 | 1 | [1,32,32,3] | 64 | 192 | 0 | 700 | 31505 |  | core0 HWC | 45.00714285714286
0 | 1 | 384 | 560 | 30561 | 49152 | 784896 | 0 | 0 | 560 | 512 | 0 | 6076 | 8192 | 1 | [1,32,32,3] | 64 | 192 | 0 | 700 | 31505 |  | core0 HWC | 45.00714285714286
1 | 0 | 0 | 8240 | 754658 | 1048576 | 16777216 | 0 | 0 | 8240 | 8192 | 0 | 164096 | 2048 | 1 | [1,32,32,64] | 64 | 4096 | 0 | 700 | 762898 |  | preceding-layer committed shards | 1089.8542857142857
1 | 1 | 0 | 8240 | 754610 | 775680 | 11885824 | 0 | 0 | 8240 | 8192 | 0 | 164096 | 2048 | 1 | [1,32,32,64] | 64 | 4096 | 0 | 700 | 762850 |  | preceding-layer committed shards | 1089.7857142857142
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
