jbpark0616/IDEC_Challenge/docs/experiment_results/free_topic/report700/scale32/measurements.csv

rate | case | input | local_K | U_block | sparse | cycles | transforms | V_writes | releases | requests | U_words | weight_wait | rows | early | resident | preload | elapsed | mac_beats | mac_lanes | v_read_blocked | v_write_blocked | no_ready_channel | mac_backpressure | busy | result_blocked | pattern | input_NHWC | u_bytes | zero_row_percent | ideal_dense_beats | ideal_sparse_beats | row0_zero_percent | row1_zero_percent | row2_zero_percent | row3_zero_percent
fast | 0 | 1,4,4,32 | 8 | 8 | 0 | 1273 | 128 | 128 | 4 | 0 | 512 | 0 | 4096 | 30 | 1 | 1024 | 1276 | 1024 | 16384 | 40 | 40 | 66 | 0 | 1226 | 0 | dense | 1,4,4,32 | 4096 | 0.0 | 1024 | 1024 | 0.0 | 0.0 | 0.0 | 0.0
fast | 0 | 1,4,4,32 | 8 | 8 | 1 | 1273 | 128 | 128 | 4 | 0 | 512 | 0 | 4096 | 30 | 1 | 1024 | 1276 | 1024 | 16384 | 40 | 40 | 66 | 0 | 1226 | 0 | dense | 1,4,4,32 | 4096 | 0.0 | 1024 | 1024 | 0.0 | 0.0 | 0.0 | 0.0
fast | 1 | 1,4,4,32 | 8 | 8 | 0 | 1273 | 128 | 128 | 4 | 0 | 512 | 0 | 4096 | 30 | 1 | 1024 | 1276 | 1024 | 16384 | 40 | 40 | 66 | 0 | 1226 | 0 | balanced25 | 1,4,4,32 | 4096 | 25.0 | 1024 | 768 | 25.0 | 25.0 | 25.0 | 25.0
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
