jbpark0616/IDEC_Challenge/docs/experiment_results/free_topic/report700/scale512/measurements.csv

rate | case | input | local_K | U_block | sparse | cycles | transforms | V_writes | releases | requests | U_words | weight_wait | rows | early | resident | preload | elapsed | mac_beats | mac_lanes | v_read_blocked | v_write_blocked | no_ready_channel | mac_backpressure | busy | result_blocked | pattern | input_NHWC | u_bytes | zero_row_percent | ideal_dense_beats | ideal_sparse_beats | row0_zero_percent | row1_zero_percent | row2_zero_percent | row3_zero_percent
fast | 0 | 1,4,4,512 | 8 | 4 | 0 | 75209 | 2048 | 2048 | 4 | 7 | 32768 | 57596 | 65536 | 510 | 0 | 8192 | 75211 | 16384 | 262144 | 0 | 0 | 1026 | 0 | 17506 | 0 | dense | 1,4,4,512 | 65536 | 0.0 | 16384 | 16384 | 0.0 | 0.0 | 0.0 | 0.0
fast | 0 | 1,4,4,512 | 8 | 4 | 1 | 75209 | 2048 | 2048 | 4 | 7 | 32768 | 57596 | 65536 | 510 | 0 | 8192 | 75211 | 16384 | 262144 | 0 | 0 | 1026 | 0 | 17506 | 0 | dense | 1,4,4,512 | 65536 | 0.0 | 16384 | 16384 | 0.0 | 0.0 | 0.0 | 0.0
fast | 1 | 1,4,4,512 | 8 | 4 | 0 | 75209 | 2048 | 2048 | 4 | 7 | 32768 | 57596 | 65536 | 510 | 0 | 8192 | 75211 | 16384 | 262144 | 0 | 0 | 1026 | 0 | 17506 | 0 | balanced25 | 1,4,4,512 | 65536 | 25.0 | 16384 | 12288 | 25.0 | 25.0 | 25.0 | 25.0
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
