jbpark0616/IDEC_Challenge/docs/experiment_results/free_topic/vgg_conv1_conv2_ppa/results/summary.csv

layer | case | sparse | input_NHWC | local_output_channels | duration_ps | clock_period_ps | power_w | energy_nj | unannotated_lef_only_sdel_pins | analysis_elapsed_s | vcd_sha256
Conv1 | 12 | 0 | [1,32,32,3] | 4 | 30737850 | 1430 | 0.03476599604 | 1068.6319713781138 | 40 | 688.6007452639999 | f097d1d78e7b4c0b6a6783a5bbfa7b2a55a65fd3075229163878de05408f7d99
Conv1 | 12 | 1 | [1,32,32,3] | 4 | 30737850 | 1430 | 0.03476787359 | 1068.6896832283815 | 40 | 641.984791679 | 17c8f6f5144e976eca36318e62843e5211ac89635fae0fe658b5c030d02f1618
Conv2 | 13 | 0 | [1,32,32,64] | 4 | 126101690 | 1430 | 0.03820159659 | 4817.285890697237 | 40 | 1595.7888890180002 | e1ecca5a8b54e88a4b174f73e63f5f78e0c745311e51a9912ccf1d27f19b8c3c
Conv2 | 13 | 1 | [1,32,32,64] | 4 | 101156770 | 1430 | 0.03860385716 | 3905.041499846973 | 40 | 4175.164937598 | f7b772b7319eafbccfd1c248efed5308d80e6c1d05a11847f0478e23c0a250e7
