jbpark0616/IDEC_Challenge/free_topic_vgg/tests/tb_window_equivalence.sv

`timescale 1ns/1ps
module tb_window_equivalence #(
    parameter integer H=6, W=6, C=3
);
    reg clk=0;
    always #5 clk=~clk;
    reg rst_n=0;
    integer cycle=0;
    always @(posedge clk) cycle<=cycle+1;
    initial begin #100000000; $fatal(1,"Window watchdog"); end
    reg ref_start=0,ref_in_valid=0;
    wire ref_start_ready,ref_in_ready,ref_valid,ref_last;
    wire [127:0] ref_tile;
    wire [6:0] ref_c;
    wire [4:0] ref_y,ref_x;
    reg [C*8-1:0] pixel_vector=0;
    wire sink_ready=cycle%7!=2 && cycle%7!=3;
    winograd_window_ff_reference #(
        .CHANNELS(C),.CHANNEL_BITS(7),.FEATURE_WIDTH(W+2),.FEATURE_HEIGHT(H+2),
        .POSITION_BITS(6),.TILE_ROWS(H/2),.TILE_COLS(W/2),.TILE_INDEX_BITS(5)
    ) reference_window (
        .clk(clk),.rst_n(rst_n),.start(ref_start),.start_ready(ref_start_ready),.busy(),.done(),
        .in_valid(ref_in_valid),.in_ready(ref_in_ready),.pixel_vector(pixel_vector),
        .out_valid(ref_valid),.out_ready(sink_ready),.activation_tile(ref_tile),
        .output_input_channel(ref_c),.output_tile_row(ref_y),.output_tile_col(ref_x),.output_last(ref_last)
    );
    reg start=0,loading=1;
    wire start_ready,valid,last;
    wire [127:0] tile;
    wire [6:0] oc;
    wire [4:0] oy,ox;
    wire mv,mready,mwrite,rv,rr;
    wire [3:0] mb;
    wire [9:0] ma;
    wire [63:0] mw,rd;
    reg load_valid=0;
    reg [9:0] load_addr=0;
    reg [63:0] load_data=0;
    wire sp_ready;
    wire pixel_valid, pixel_ready;
    wire [1023:0] loaded_pixel;
    assign mwrite=0;
    assign mb=8;
    assign mw=0;
    vgg_activation_reader #(.HEIGHT(H),.WIDTH(W)) reader (
        .clk(clk),.rst_n(rst_n),.start(start),.channels(8'(C)),.streaming(1'b0),
        .pixel_valid(pixel_valid),.pixel_ready(pixel_ready),.pixel_vector(loaded_pixel),
        .mem_valid(mv),.mem_ready(mready),.mem_slot(),.mem_addr(ma),
        .mem_rvalid(rv),.mem_rready(rr),.mem_rdata(rd),
        .page_available(1'b0),.page_words(11'b0),.page_release(),.page_slot(),.done()
    );
    winograd_sliding_window_generator #(
        .CHANNELS(128),.CHANNEL_BITS(7),.RUNTIME_CHANNELS(1),
        .FEATURE_WIDTH(W+2),.FEATURE_HEIGHT(H+2),.POSITION_BITS(6),
        .TILE_ROWS(H/2),.TILE_COLS(W/2),.TILE_INDEX_BITS(5)
    ) dut (
        .clk(clk),.rst_n(rst_n),.start(start),.start_ready(start_ready),
        .channel_count_minus1(7'(C-1)),.busy(),.done(),
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
