jbpark0616/IDEC_Challenge/(commit log)

2026-07-14 Initial project setup
    - Add Vivado baseline project (.xpr), verilog RTL sources, test data
    - Add OpenROAD reference package (config/, std_cell/, verilog/)
    - Add competition docs (KNU IDEC 2026 CCDC)
    - Fix top_tb.v \$readmemh paths from C:/cnn_verilog/data/ to C:/IDEC_challenge/data/
    - .gitignore excludes Vivado build artifacts (cache/hw/runs/sim/dcp)
    [chip.v]
2026-07-14 Add PROGRESS.md for cross-session continuity
    Lightweight log of decisions, next steps, and baseline measurements.
    Read on new session with "PROGRESS.md 읽고 이어서 하자".
2026-07-14 Add Makefile-based non-project mode flow (Level 2)
    Terminal-first workflow, no Vivado GUI required for daily loop.
    Structure:
    Makefile — single entry point (sim, synth, xpr, wave, clean)
    flow/vivado/*.tcl — non-project Tcl (xsim, Vivado batch)
    flow/constraints/timing.xdc — 100 MHz clock constraint
    scripts/check_accuracy.py — parse xsim log, PASS/FAIL vs baseline 96%
    .vscode/tasks.json — one-click runners for VS Code
    Verified end-to-end:
    make sim TOP=top_tb → 5s smoke test, PASS
    make sim → 23s, 1000 images, Accuracy 97.0% PASS
    Notes:
    - xelab needs -timescale 1ps/1ps because RTL modules don't
    ha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
2026-07-14 PROGRESS.md: record Level 2 flow setup and baseline accuracy 97%
2026-07-14 Fix make on Windows PowerShell + record baseline synth numbers
    Makefile: hard-code Git Bash path on Windows_NT so mkdir -p / && work
    regardless of invoking shell. Previously SHELL:=bash could resolve to
    WSL bash from PowerShell context, breaking recipes.
    Baseline synth results (100 MHz target):
    WNS: -60.156 ns (Fmax ~14.25 MHz — far below target)
    LUT: 21,922 (18.72%)
    FF: 3,792
    Power: 0.497 W (Dyn 0.208 + Static 0.289)
    Large Fmax improvement headroom available for 지정주제 scoring.
2026-07-14 Fix make on Windows PowerShell (short DOS path + .SHELLFLAGS)
    - SHELL := C:/PROGRA~1/Git/usr/bin/bash.exe (avoid space in Program Files)
    - .SHELLFLAGS := -c (force GNU Make 3.81 to route recipes through bash)
    - Verified: make clean, sim, help all work from PowerShell
    Also silence broken-pipe 'write error' in synth timing summary
    by wrapping grep in { } || true before piping to head.
2026-07-14 Fix: prepend Git Bash usr/bin to PATH so make can find mkdir/rm/cp
    Root cause: GNU Make 3.81 on Windows bypasses SHELL for 'simple' commands
    (no metachars like &&, |, >) and calls CreateProcess directly. When
    PowerShell's PATH lacks Git Bash's usr/bin (where POSIX mkdir, rm, cp
    live), CreateProcess fails with 'CreateProcess(NULL, mkdir -p ...) failed'.
    Fix: export PATH := C:/PROGRA~1/Git/usr/bin:$(PATH) in Makefile for
    Windows_NT. This propagates through all spawned child processes.
    Verified end-to-end from PowerShell:
    make clean → rm -rf build succeeds
    make sim → xvlog/xelab/xsim/python all reachable, PASS
2026-07-14 Integrate OpenROAD ASIC synth flow via WSL Ubuntu
    RTL changes:
    - Prepend \`timescale 1ps/1ps to all 6 verilog/*.v files (professional
    practice, also lets us drop xelab -timescale workaround)
    Makefile:
    - Add synth-asic target that invokes OpenROAD synth-report in WSL
    - Auto-copy netlist, SDC, and reports to build/asic/ after synth
    flow/openroad/chip.config.mk:
    - config.mk for the WSL side, points VERILOG_FILES at
    /mnt/c/IDEC_challenge/verilog/*.v so single source of truth
    .vscode/tasks.json:
    - Add synth-asic task (relabels Vivado synth as sanity-check tier)
    Baseline OpenROAD ASAP7 7nm results:
    - Area: 23,988.79 um^2 (Seq 7.4% + Comb 92.6%)
    - Fmax: 618.37 MHz (vs 400ps target - misses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
    [chip.v]
2026-07-14 PROGRESS: EOD 2026-07-15 — environment complete, ready for RTL analysis
    Today's work complete: full flow (sim + synth-asic + WSL OpenROAD bridge)
    verified end-to-end. Baseline measurements captured.
    Tomorrow's starting point: verilog/chip.v analysis + optimization ideation.
2026-09-01 Implement Winograd W4A8 CNN accelerator
    [activation_lifetime_trace.csv, baseline_vs_winograd.csv, dead_tile_pruning_comparison.csv, depth_sweep.csv, fifo_depth1_trace.csv, fifo_depth2_trace.csv, fifo_depth_ppa.csv, fifo_depth_sweep.csv]
2026-11-12 docs: add detailed Winograd and multicore circuit guide
2026-11-12 docs: show detailed circuit figures without collapsed sections
2026-11-12 docs: remove two retired circuit figures from README
